martingms/dmpro2012ytelse/README.md

dmpro2012ytelse
===============

Mailingliste: [dmpro2012ytelse@list.stud.ntnu.no](mailto:dmpro2012ytelse@list.stud.ntnu.no)  
IRC: [#dmpro @ IRCnet](irc://irc.ifi.uio.no/dmpro)
