martingms/dmpro2012ytelse/report/acronyms.tex

\chapter*{Abbreviations}
\acrodef{ALU}{Arithmetic Logic Unit}
\acrodef{API}{Application Programming Interface}
\acrodef{BMP}{Bitmap}
\acrodef{CPU}{Central Processing Unit}
\acrodef{DAC}{Digital-to-Analog Converter}
\acrodef{DMA}{Direct Memory Access}
\acrodef{DRAM}{Dynamic RAM}
\acrodef{FAT}{File Allocation Table}
\acrodef{I/O}{Input/Output}
\acrodef{LED}{Light-Emitting Diode}
\acrodef{MB}{Megabyte}
\acrodef{RAM}{Random Access Memory}
\acrodef{RISC}{Reduced Instruction Set Computer}
\acrodef{SRAM}{Static RAM}
\acrodef{UI}{User Interface}
\acrodef{USB}{Universal Serial Bus}
\begin{acronym}
  \acro{ASF}{Atmel Software Foundation}
  \acro{EBI}{External Bus Interface}
  \acro{FPGA}{Field-Programmable Gate Array}
  \acro{GPIO}{General Purpose Input/Output}
  \acro{JTAG}{Joint Test Action Group}
  \acro{LENA}{Lightweight, Efficient Node Array}
  \acro{MIMD}{Multiple Instruction, Multiple Data}
  \acro{PCB}{Printed Circuit Board}
  \acro{PDCA}{Peripheral DMA Controller}
  \acro{SCU}{System Control Unit}
  \acro{SDHC}{Secure Digital High-Capacity}
  \acro{SDRAM}{Synchronous Dynamic RAM}
  \acro{SD}{Secure Digital}
  \acro{SIMD}{Single Instruction, Multiple Data}
  \acro{SMC}{Static Memory Controller}
  \acro{SPI}{Serial Peripheral Interface Bus}
  \acro{USART}{Universal Synchronous/Asynchronous Receiver Transmitter}
  \acro{VGA}{Video Graphics Array}
  \acro{VHDL}{VHSIC Hardware Description Language}
  \acro{VHSIC}{Very-High-Speed Integrated Circuits}
\end{acronym}
