martingms/dmpro2012ytelse/report/fb/front.tex

\begin{titlepage}
%  \begin{addmargin}[-1cm]{-3cm}
    \begin{center}
      \large  
      
      \hfill
      
      \vfill
      
      \begingroup
      \color{Maroon}\spacedallcaps{\ourTitle} \\ 
      \endgroup
      \begingroup
%      \small \spacedlowsmallcaps{computers have never been sexier}
      \bigskip
      \endgroup
      
      {\sc \ourNames}
      
      \vfill
      
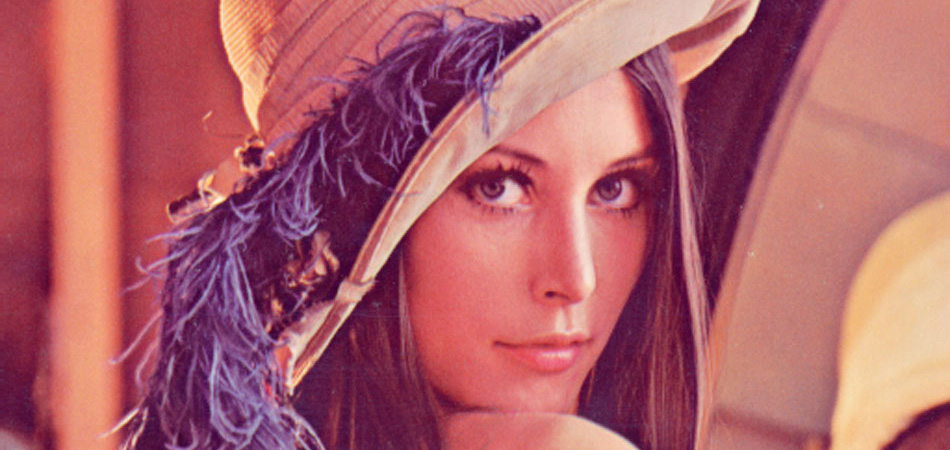
[picture p1: report/gfx/killinglena.jpg]
       \\
      
      \vfill
      
      \ourProject \\
      \ourDept \\                            
      \ourFaculty \\
      \ourUni \\ \bigskip
      
      \vfill                      
      
    \end{center}  
% \end{addmargin}
\end{titlepage}
