martingms/dmpro2012ytelse/report/apx/pcb.tex

\chapter{PCB}

\input{apx/pcb/pin-use}
\input{apx/pcb/ordered-parts}
\input{apx/pcb/macaos} 
\clearpage
\input{apx/pcb/schematics}
