martingms/dmpro2012ytelse/report/ch/pcb.tex

\chapter{PCB}\label{ch:pcb}

\begin{flushright}{\slshape
    Electricity is really just organized lightning.\\ \medskip
    --- George Carlin}
\end{flushright}

\input{fig/pcb/pcbwithcomp}
The entire system is connected together on the PCB. Designing and soldering
a correct and working PCB is thus important to be able to construct the system
as a whole.

This chapter will start by explaining how some of our overall design choices
affected the PCB design. We elaborate our power layout before giving an
overview of where we got our footprints from. Finally, we explain the process 
of making the PCB, as well as some of the issues and solutions we met during 
the process.

\input{ch/pcb/introduction.tex}
%Flytta til process
%\input{ch/pcb/schematics.tex}
\input{ch/pcb/power_supply.tex}
\input{ch/pcb/power_plane.tex}
\input{ch/pcb/footprints.tex}
%Flytta til process
%\input{ch/pcb/routing.tex}
\input{ch/pcb/thepcb.tex}
\input{ch/pcb/process.tex}
\input{ch/pcb/workarounds.tex}
