martingms/dmpro2012ytelse/report/presentation/presentation.tex

\documentclass{beamer}
\usepackage[utf8x]{inputenc}

\usepackage{beamerthementnuenglish}

\title[Datamaskinprosjekt 2012 med fokus på ytelse: 256 Shades of Grey]{256
  Shades of Grey}
\institute[NTNU]{Department of Computer and Information Science}
\author{V. Mange}
\date{21. november, 2012}

\begin{document}

\ntnutitlepage

\begin{frame}
  Eksempel på frame
\end{frame}

\end{document}
