martingms/dmpro2012ytelse/report/ch/res/sdcard.tex

\section{SD Card Performance}
\label{sec:performance-sd-card}

As mentioned in Section \ref{sec:avr-spi-issues}, reading data from an
SD card over SPI turned out to be the biggest bottleneck for throughput
in our system. In this section, we will document the optimizations we
made to improve the SD card's read performance.

Table \ref{tab:spi-optimizations-table} shows the gradually improving
performance as we optimized the code. This is also shown in Figure
\ref{fig:spi-optimizations-plot}. Each of the optimizations are
explained in greater detail below.

\begin{description}
	\item[Removed status checking + function inlining] \hfill \\
		The spi\_send function busy-waited on the TXEMPTY flag for each
		byte it transmitted. In our case of alternating sends and reads,
		we do not have to check whether the SPI send register is empty
		every time. Inlining spi\_read and spi\_write also helped,
		although -O1, -O2 or -O3 would have done this for us.
	\item[Less SPI status register polling] \hfill \\
		In spi\_read, two conditions are busy-waited on before
		returning: whether the send register is empty, and whether the
		receive buffer is full yet. We only have to check the latter of
		these conditions.
	\item[Increased clock rate] \hfill \\
		Our CPU and main bus is driven by an external 12MHz crystal
		oscillator and the SPI clock frequency is calculated by dividing
		this by an integer number. We kept this divisor to be either 1
		or 2 (so SPI ran at either the same or half the speed of the
		CPU). Increasing to clock rate from 12MHz to 78 MHz boosted the
		speed from 157kB/s to 456 kB/s.
	\item[Compiler optimizations] \hfill \\
		Turning on compiler optimizations improved performance
		by another 14\%. There was no noticeable difference in
		performance between -O1, -O2 or -O3. However, compiler
		optimizations had a more profound effect on the overall system
		performance. We did not benchmark this extensively, but it was
		probably caused by optimizations the compiler made to the \ac{LENA}
		communication code.
	\item[Bypass FAT and use multiple block reads] \hfill \\
		We patched the framework code to support multiple block reads.
		Apparently, this was not something the FAT driver was able to
		take full advantage of out of the box. It was easier to simply
		bypass the file system than to try to fix it, so that is what we
		did.
		
		By reading the blocks directly from the SD card, we could read
		all 150 blocks of a picture in one function call. Limiting the
		file system to the first half of the SD card and adding metadata
		files containing the block offsets into the second half of the
		card was easy. This more than doubled our performance, from 515
		kB/s to 1172 kB/s.
\end{description}

\TODO{This must be rewritten}
After implementing these optimizations, the \ac{SCU} was capable of pushing out around
12 FPS to the \ac{LENA}, around 920 kB/s. As we managed to reach our goal of 10
FPS, we did not optimize it any further. However, using the \ac{PDCA}, we could
have effectively eliminated the 25\% time spent sending to the \ac{LENA} while
the \ac{SD} card waited. Thus, giving as a frame rate of around 16
FPS. 
\input{fig/avr/spi-optimizations-table.tex}
\input{fig/avr/spi-optimizations-plot.tex}
