martingms/dmpro2012ytelse/report/ch/pcb/footprints.tex

\section {Footprints}
Some of the components we chose did not have footprints readily available, which
meant we either had to look for them on the internet, or create them.

This meant either staring at datasheets and carefully placing pins
relative to each other, or running the IPC wizard.

\subsection{We made the following footprints}
\input{fig/pcb/footprintswemade}
\begin{description}
\item[SD card] \hfill
\\
  With the pin designations selected by googling the pinouts for
  \ac{SD} cards in general, and comparing a few of those hits to make sure that
  the results agreed with each other. Finally we selected a single hit\footnote{\url{http://pinouts.ru/Memory/sdcard_pinout.shtml}}
  to base the pinout on. The
  schematic\footnote{\url{http://katalog.we-online.de/em/datasheet/693063010911.pdf}}
  for the reader itself was particularly hard to read, to the point that we had to ask Tufte
  for help to understand it. Even after that, there was no way to be sure
  precisely where the grounding pads were relative to the rest of the \ac{SD}
  card reader. Thus we did some guesswork, and added a decent amount
  of slack to the ground pads by adding extra tin to these pads.
\item[Memory (TSOP54/TSOP44)] \hfill
\\
  The TSOP54/TSOP44 footprints were created using
  the IPC Footprint Wizard, as their datasheets fitted nicely with the Small
  Outline Package setting in that Wizard.
\end{description}

\subsection{Footprints from other sources:}
As Festina Lente used some components that we also ended up using, we decided,
after talking to Tufte, to use their Footprints\footnote{\url{http://org.ntnu.no/datamaskinerprosjekt2011/altium_libraries/dmprolibrary/}}
(as they were known to work) for these components:

\input{fig/pcb/footprintsources}
The oscillator had one issue last year, the footprint for it was mirrored
, noting this from Festina Lente's report, we read
through the datasheet, and remapped the pin-numbering (taking care to understand
why it was mirrored last year) on the footprint 
before using this footprint.

After reading the Festina Lente report\cite{berg2011festinalente}, we decided to
follow their choice of footprint for capacitors and resistors: 1206 SMT. As
those were physically bigger than the 0804 SMTs they mentioned as an
alternative, they would be easier to solder by hand.
