martingms/dmpro2012ytelse/report/fig/pcb/footprintswemade.tex

\begin{table}[h]
  \centering
  \begin{tabular}{l l}\toprule
    \thx{Component} & \thx{Purpose} \\ \midrule
    \ac{SD} card reader & For fast data access \\
    \ac{VGA} plug & For our own VGA implementation \\
    CY7C1069DV33 54TSOP & Data-memory (2M $\times$ 8bit) \\
    CY7C1021DV33 44TSOP & Program-memory (64k $\times$ 16bit) \\
    CY7C1049DV33 44TSOP &  VGA memory (512 $\times$ 8bit) \\
    \bottomrule
  \end{tabular}
  \caption{The Customized Footprints}
  \label{fig:footprints-we-made}
\end{table}
