martingms/dmpro2012ytelse/report/fig/fpga/fpga-simd-s-reg.tex

\begin{figure}[h]
  \centering
  \includegraphics[width=\linewidth,clip,trim=0 0 0 0]
                  {fig/fpga/fpga-simd-s-reg.pdf}
  \caption[Source Data Flow.]{Source data flow through the \ac{LENA} \ac{SIMD} array.}
  \label{fig:fpga-simd-s-reg}
\end{figure}
