martingms/dmpro2012ytelse/report/apx/pcb/pin-use.tex

\section{Overview of Pin Use}\label{app:pin-use}

\subsection{FPGA}\label{app:pin-use-fpga}
\input{fig/parts/pcb-pin-use-fpga.tex}
\subsection{AVR}\label{app:pin-use-avr}
\input{fig/parts/pcb-pin-use-avr.tex}
