martingms/dmpro2012ytelse/report/ch/pcb/process.tex

\section {Process}
This section describes the work and design challenges faced related to the PCB.

\input{ch/pcb/schematics}
\input{ch/pcb/routing}
\input{ch/pcb/soldering}
