martingms/dmpro2012ytelse/report/fig/avr/modules.tex

\begin{figure}[H]
  \centering
  
  \caption[SCU Modules]{The different modules of the SCU}
  \label{fig:avr-modules}
\end{figure}
