martingms/dmpro2012ytelse/report/fig/avr/spi-optimizations-plot.tex

\begin{figure}[H]
  \centering
  
  \caption[SPI Optimizations Plot]{The results from Table
    \ref{tab:spi-optimizations-table} plotted. Milestones are along the
    $x$-axis and read performance along the $y$-axis.}
  \label{fig:spi-optimizations-plot}
\end{figure}
