martingms/dmpro2012ytelse/report/fig/avr/spi-optimizations-table.tex

\begin{table}[H]
  \centering
  \begin{tabularx}{\textwidth}{c X r} \toprule
    \thx{Milestone} & \thx{Description} & \thx{Performance} \\
    \midrule
    1 & Baseline before optimization & 74.87 kB/s \\
    2 & Less status checking in {\tt spi\_send} plus inlining & 137.00 kB/s \\
    3 & Less \ac{SPI} status register polling & 156.59 kB/s \\
    4 & Clock rate of 20MHz, 10MHz \ac{SPI} & 214.40 kB/s \\
    5 & Clock rate of 20MHz, 20MHz \ac{SPI} & 243.00 kB/s \\
    6 & Clock rate of 40MHz, 20MHz \ac{SPI} & 327.80 kB/s \\
    7 & Clock rate of 48MHz, 24MHz \ac{SPI} & 369.50 kB/s \\
    8 & Clock rate of 60MHz, 30MHz \ac{SPI} & 423.40 kB/s \\
    9 & Clock rate of 72MHz, 36MHz \ac{SPI} & 432.70 kB/s \\
    10 & Clock rate of 78MHz, 39MHz \ac{SPI} & 455.80 kB/s \\
    11 & Turn on {\tt -O1} & 521.70 kB/s \\
    12 & Turn on {\tt -O2} & 523.40 kB/s \\
    13 & Turn on {\tt -O3} & 515.30 kB/s \\
    14 & Bypass \ac{FAT} and use multiple block reads & 1171.90 kB/s \\ 
    \bottomrule
  \end{tabularx}
  \caption[SPI Read Performance]{The read performance over \ac{SPI} at various
    milestones.}
  \label{tab:spi-optimizations-table}
\end{table}
