martingms/dmpro2012ytelse/report/fig/disc/memarch.tex

\begin{figure}[h]
  \centering
  \includegraphics[width=\textwidth,clip,trim=0 17cm 0 0]
                  {fig/disc/memarch.pdf}
  \caption[Data Memory Architecturres]{Considered data memory architectures}
  \label{fig:disc-memarch}
\end{figure}
