martingms/dmpro2012ytelse/report/fig/fpga/fpga_ctrl_core.tex

\begin{figure}[h]
  \begin{addmargin}{-2cm}
    \centering
    \includegraphics[width=\linewidth,clip,trim=0 18cm 0 0]
                    {fig/fpga/fpga_ctrl_core.pdf}
    \caption{Image processor control core.}
    \label{fig:fpga-ctrl-core}
  \end{addmargin}
\end{figure}
