martingms/dmpro2012ytelse/report/fig/pcb/footprintsources.tex

\begin{table}[h]
  \centering
  \begin{tabular}{l l}\toprule
    \thx{Component} & \thx{Source} \\ \midrule 
    Button (FSM2JSMA) & Festina Lente \\
    Crystal & Festina Lente \\
    LUMBERG - 2486 01 - MINI \ac{USB} TYPE B & Festina Lente \\
    Oscillator (CSX750FJC50.000M-UT) & Festina Lente \\
    Power Connector & Festina Lente \\
    External \ac{VGA} module & Festina Lente \\
    AVR & AVR-freaks \\
    \ac{FPGA} & Altium Design Library \\ \bottomrule
  \end{tabular}
  \caption{Footprints and sources}
  \label{fig:footprints-and-sources}
\end{table}
