martingms/dmpro2012ytelse/report/fig/pcb/pcbwithcomp.tex

\begin{figure}[h]
  \centering
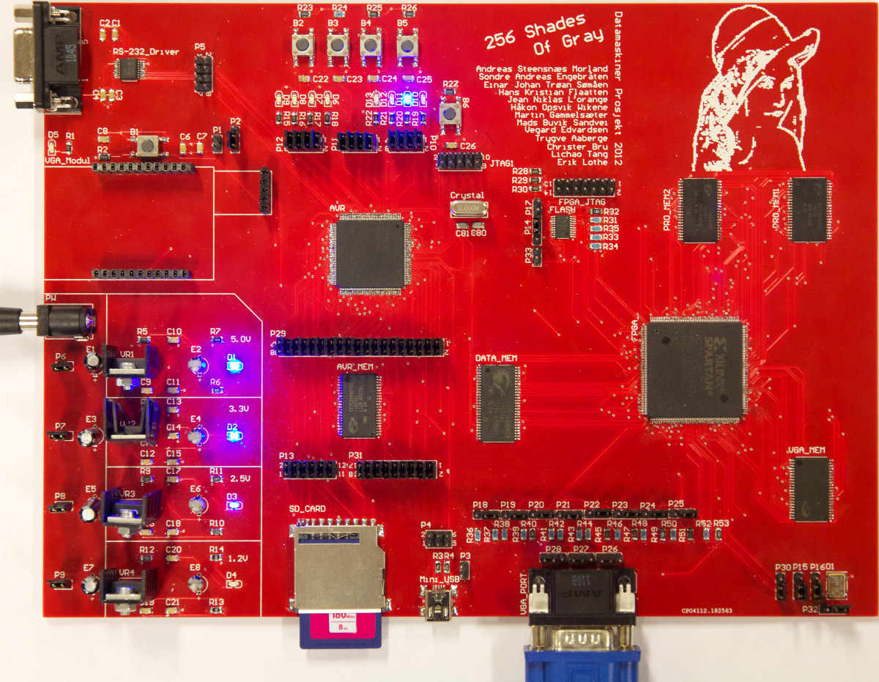
[picture p2: report/fig/pcb/pcbwithcomp.jpg]
  
  \caption[The PCB]{The PCB With All The Components.}
  \label{fig:pcb-with-components}
\end{figure}
