martingms/dmpro2012ytelse/report/apx/pcb/schematics.tex

\section{Schematics}\label{app:schematics}
The following figures will show schematics of our PCB.
\input{fig/pcb/schematics/pcbschematic}
\input{fig/pcb/schematics/pcbschematic_avr}
\input{fig/pcb/schematics/pcbschematic_avrmem}
\input{fig/pcb/schematics/pcbschematic_vgamodule}
\input{fig/pcb/schematics/pcbschematic_vgamem}
\input{fig/pcb/schematics/pcbschematic_vgacontroller}
\input{fig/pcb/schematics/pcbschematic_serial}
\input{fig/pcb/schematics/pcbschematic_sdcard}
\input{fig/pcb/schematics/pcbschematic_powersupply}
\input{fig/pcb/schematics/pcbschematic_ledbtn}
\input{fig/pcb/schematics/pcbschematic_jtagflash}
\input{fig/pcb/schematics/pcbschematic_fpgapower}
\input{fig/pcb/schematics/pcbschematic_fpgab01}
\input{fig/pcb/schematics/pcbschematic_fpgab3}
