martingms/dmpro2012ytelse/report/fig/pcb/pcb_removing_vias.tex

\begin{figure}[h]
  \centering
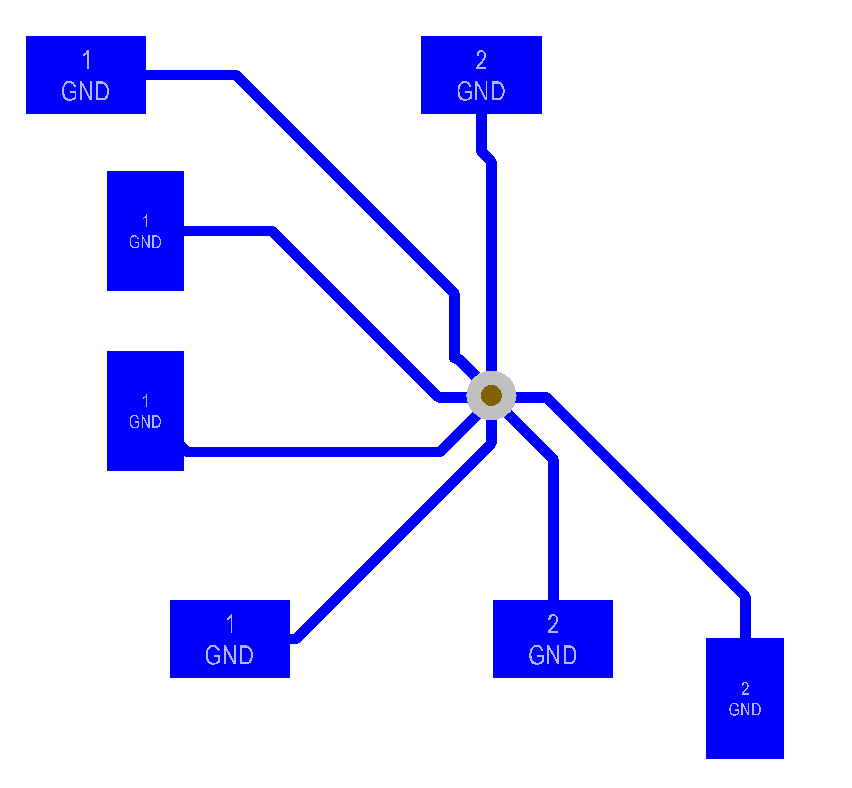
[picture p3: report/fig/pcb/pcb_removing_vias.png]
  
  \caption{Removing vias}
  \label{fig:removingvias-pcb}
\end{figure}
