martingms/dmpro2012ytelse/report/fig/pcb/voltageresult.tex

\begin{table}[h]
  \centering
  \begin{tabularx}{\textwidth}{l l l l}\toprule
    \thx{Test} & \thx{Result} & \thx{Passed} 
    \\ 
	 \midrule
    Power supply 12.0V               &Measured 12.045  & OK  \\	
    Power supply 5.0V               &Measured 4.995  & OK  \\
    Power supply 3.3V                   & Measured 3.286 & OK  \\
    Power supply 2.5V                 & Measured 2.510 & OK \\
    Power supply 1.2V            & Measured 1.240 & OK  \\
    
    \bottomrule
  \end{tabularx}
  \caption{Results of power supply}
  \label{fig:pcb}
\end{table}
