martingms/dmpro2012ytelse/report/fig/sys-over/journey.tex

\begin{figure}[h]
  \centering
  \includegraphics[width=\linewidth,clip,trim=0 20.5cm 0 0]
                  {fig/sys-over/journey.pdf}
  \caption{The Journey of an Image}
  \label{fig:image-journey}
\end{figure}
