martingms/dmpro2012ytelse/report/fig/fpga/fpga-simd-datacom.tex

\begin{figure}[h]
  \centering
  \includegraphics[width=\linewidth,clip,trim=0 18cm 0 0]
                  {fig/fpga/fpga-simd-datacom.pdf}
  \caption[Communication in SIMD array.]{Four-way communication in the \ac{LENA}
    \ac{SIMD} array.}
  \label{fig:fpga-simd-datacom}
\end{figure}
