martingms/dmpro2012ytelse/report/fig/fpga/vga-circuit.tex

\begin{figure}[h!]
\centering
\includegraphics[width=\linewidth,clip,trim=0 11cm 0 0]
                {fig/fpga/vga-circuit.pdf}
\caption[VGA controller]
        {The resistor network of the DAC.}
\label{fig:vga-circuit}
\end{figure}
