martingms/dmpro2012ytelse/report/fig/pcb/routing.tex

\begin{figure}[h]
  \centering
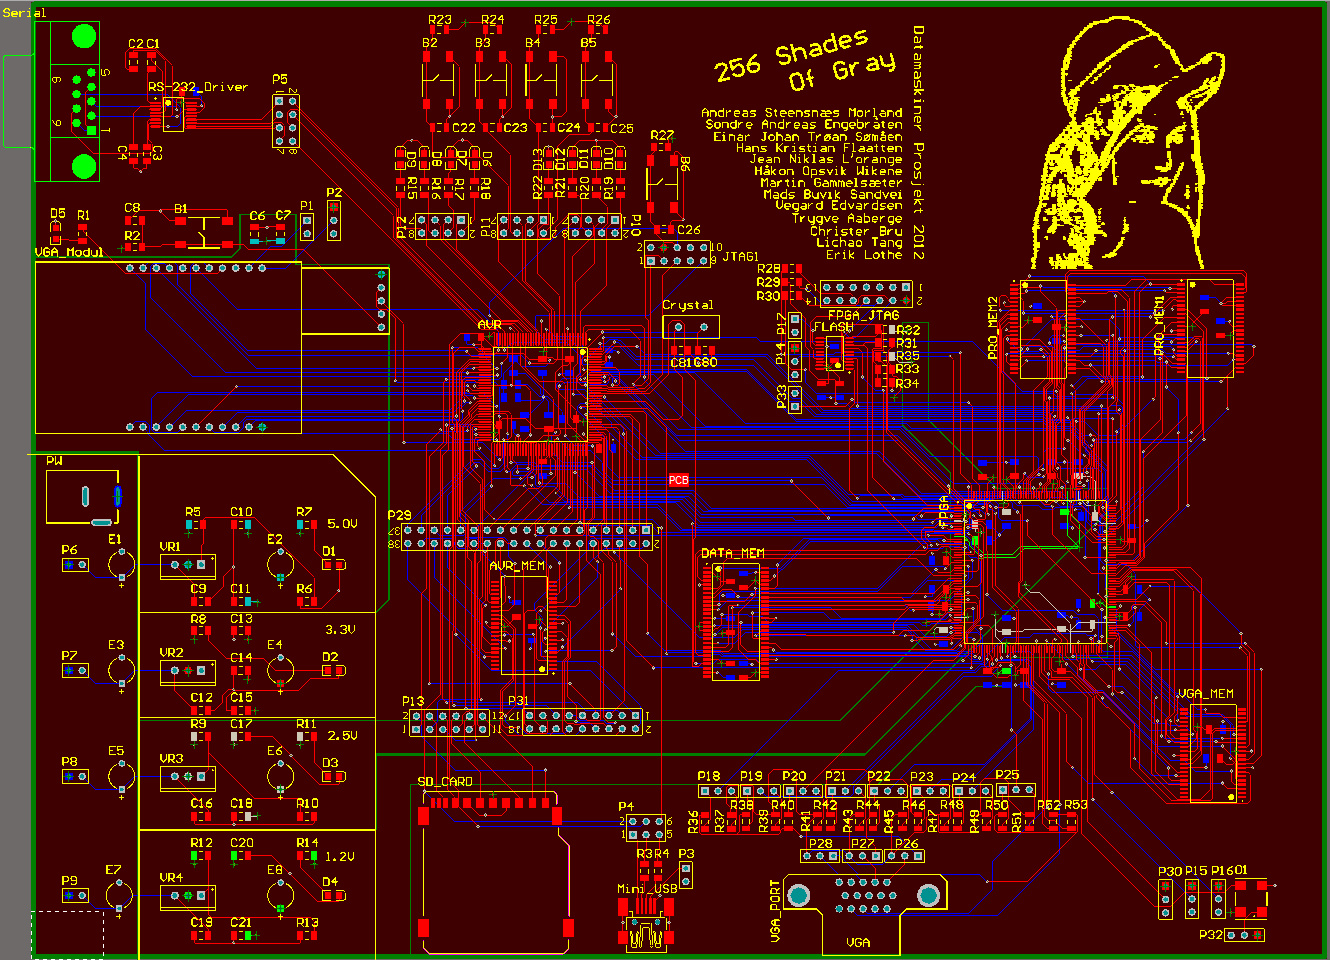
[picture p4: report/fig/pcb/routing.PNG]
  
  \caption{Routed PCB}
  \label{fig:routed-pcb}
\end{figure}
