martingms/dmpro2012ytelse/report/fig/pcb/power_planes.tex

\begin{figure}[h]
  \centering
  
  \caption{The Power Planes}
  \label{fig:power_planes}
\end{figure}
