martingms/dmpro2012ytelse/report/fig/fpga/vga.tex

\begin{figure}[h!]
\centering
\includegraphics[width=\linewidth,clip,trim=0 18cm 0 0]
                {fig/fpga/vga.pdf}
\caption[VGA controller]
        {The parts of the VGA controller.}
\label{fig:vga}
\end{figure}
