martingms/dmpro2012ytelse/report/fig/fpga/control_module.tex

\begin{figure}[h!]
\centering
\includegraphics[width=\linewidth,clip,trim=0 10cm 0 0]
                {fig/fpga/control_module.pdf}
\caption[Control module]
        {An overview of the control module of the image processor.}
\label{fig:control-module}
\end{figure}
