martingms/dmpro2012ytelse/report/fig/fpga/architecture.tex

\begin{figure}[h!]
\centering
\includegraphics[width=\linewidth,clip,trim=0 7.6cm 0 0]
                {fig/fpga/architecture.pdf}
\caption[LENA architecture]
        {An overview of the LENA image processor architecture.}
\label{fig:fpga-architecture}
\end{figure}
