martingms/dmpro2012ytelse/report/fig/pcb/pcbwithoutcomp.tex

\begin{figure}[h]
  \centering
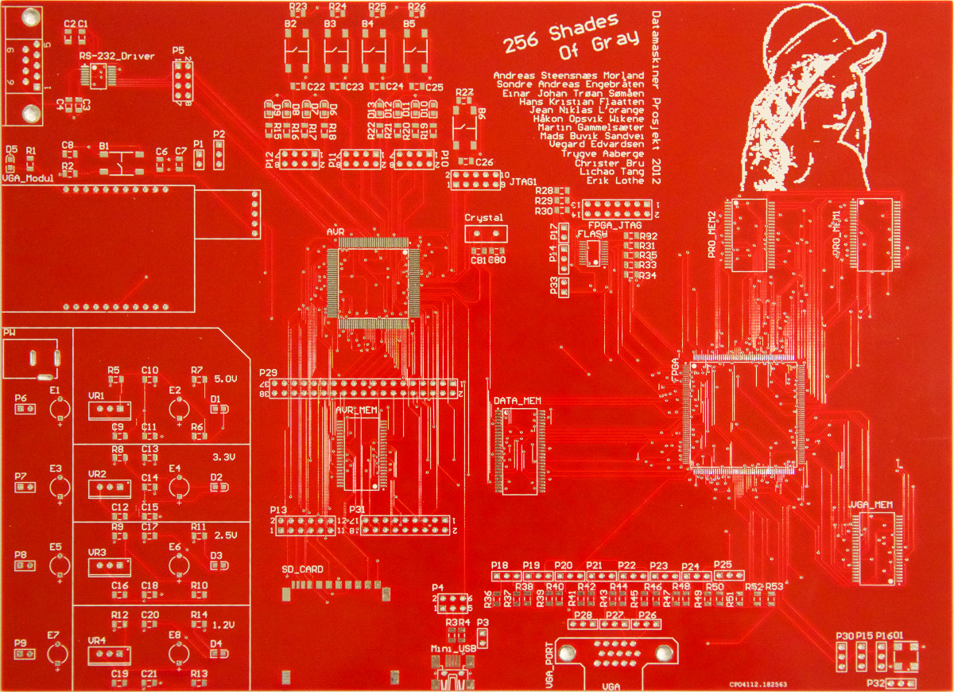
[picture p5: report/fig/pcb/pcbwithoutcomp.jpg]
  
  \caption{The PCB Without Components}
  \label{fig:pcb-without-components}
\end{figure}
