martingms/dmpro2012ytelse/report/fig/sys-over/arch-fig.tex

\begin{figure}[h]
  \centering
  \includegraphics[width=\linewidth,clip,trim=0 18cm 0 0]
                  {fig/sys-over/arch-fig.pdf}
  \caption{System Architecture}
  \label{fig:sys-over-arch-fig}
\end{figure}
