martingms/dmpro2012ytelse/report/ch/intro/terms.tex

\section{Terminology, Names and Conventions}

We will use the following names and non-standard terms in the report:

\begin{description}
\item[AVR] A microprocessor architecture
\item[LENA Architecture] Lightweight, Efficient, Node Array Architecture
\end{description}

The following acronyms are used consistently throughout the report, to ease
reading.

\begin{description}
\item[PCB] Printed Circuit Board
\item[FPGA] Field-Programmable Gate Array
\item[SIMD] Single Instruction, Multiple Data
\item[RISC] Reduced Instruction Set Computer
\item[VGA] Video Graphics Array
\item[ALU] Arithmetic Logic Unit
\item[USB] Universal Serial Bus
\item[I/O] Input/Output
\item[JTAG] Joint Test Action Group
\item[API] Application Programming Interface
\item[RAM] Random Access Memory
\item[SRAM] Static Random Access Memory
\item[DRAM] Dynamic Random Access Memory
\item[SD] Secure Digital
\end{description}
