martingms/dmpro2012ytelse/report/lst/apx/lena/simd_embossing.tex

\begin{code}
  \usemintedstyle{soderberg}
  \inputminted[frame=single,linenos,%firstline=50,firstnumber=50,%lastline=92,
    fontsize=\small]{lena}{../tools/fpga_programs/simd_edge_detection.lena}
  \caption{Edge detection code in LENA assembly.}
  \label{lst:edgedetect}
\end{code}
