martingms/dmpro2012ytelse/report/fig/pcb/schematics/pcbschematic_avrmem.tex

\begin{figure}[h]
  \centering
  
  \caption{AVR Memory}
  \label{fig:schematic-pcb-avrmem}
\end{figure}
