martingms/dmpro2012ytelse/report/fig/pcb/schematics/pcbschematic_avr.tex

\begin{figure}[h]
  \centering
  
  \caption{AVR Schematic and FPGA Input}
  \label{fig:schematic-pcb-avr}
\end{figure}
