martingms/dmpro2012ytelse/report/fig/pcb/schematics/pcbschematic.tex

\begin{figure}[h]
  \centering
  
  \caption{PCB Schematic Overview}
  \label{fig:schematic-pcb}
\end{figure}
