martingms/dmpro2012ytelse/report/fig/pcb/schematics/pcbschematic_fpgab01.tex

\begin{figure}[h]
  \centering
  
  \caption{FPGA Bank 0 and Bank 1}
  \label{fig:schematic-pcb-fpgab01}
\end{figure}
