martingms/dmpro2012ytelse/report/fig/pcb/schematics/pcbschematic_fpgab3.tex

\begin{figure}[h]
  \centering
  
  \caption{FPGA Bank 3}
  \label{fig:schematic-pcb-fpgab3}
\end{figure}
