martingms/dmpro2012ytelse/report/fig/pcb/schematics/pcbschematic_fpgapower.tex

\begin{figure}[h]
  \centering
  
  \caption{FPGA Power Supply}
  \label{fig:schematic-pcb-fpgapower}
\end{figure}
