martingms/dmpro2012ytelse/report/fig/pcb/schematics/pcbschematic_jtagflash.tex

\begin{figure}[h]
  \centering
  
  \caption{FPGA JTAG Flash}
  \label{fig:schematic-pcb-jtagflash}
\end{figure}
