martingms/dmpro2012ytelse/report/fig/pcb/schematics/pcbschematic_ledbtn.tex

\begin{figure}[h]
  \centering
  
  \caption{LEDs and Buttons}
  \label{fig:schematic-pcb-ledbtn}
\end{figure}
