martingms/dmpro2012ytelse/report/fig/pcb/schematics/pcbschematic_powersupply.tex

\begin{figure}[h]
  \centering
  
  \caption{Power Supply}
  \label{fig:schematic-pcb-powersupply}
\end{figure}
