martingms/dmpro2012ytelse/report/fig/pcb/schematics/pcbschematic_sdcard.tex

\begin{figure}[h]
  \centering
  
  \caption{SD Card Reader}
  \label{fig:schematic-pcb-sdcard}
\end{figure}
