martingms/dmpro2012ytelse/report/fig/pcb/schematics/pcbschematic_serial.tex

\begin{figure}[h]
  \centering
  
  \caption{Serial}
  \label{fig:schematic-pcb-serial}
\end{figure}
