martingms/dmpro2012ytelse/report/fig/pcb/schematics/pcbschematic_vgacontroller.tex

\begin{figure}[h]
  \centering
  
  \caption{VGA Controller}
  \label{fig:schematic-pcb-vgacontroller}
\end{figure}
