martingms/dmpro2012ytelse/report/fig/pcb/schematics/pcbschematic_vgamem.tex

\begin{figure}[h]
  \centering
  
  \caption{VGA Memory}
  \label{fig:schematic-pcb-vgamem}
\end{figure}
