martingms/dmpro2012ytelse/report/fig/pcb/schematics/pcbschematic_vgamodule.tex

\begin{figure}[h]
  \centering
  
  \caption{VGA Module}
  \label{fig:schematic-pcb-vgamodule}
\end{figure}
