martingms/dmpro2012ytelse/doc/design_spec/architecture.pdf

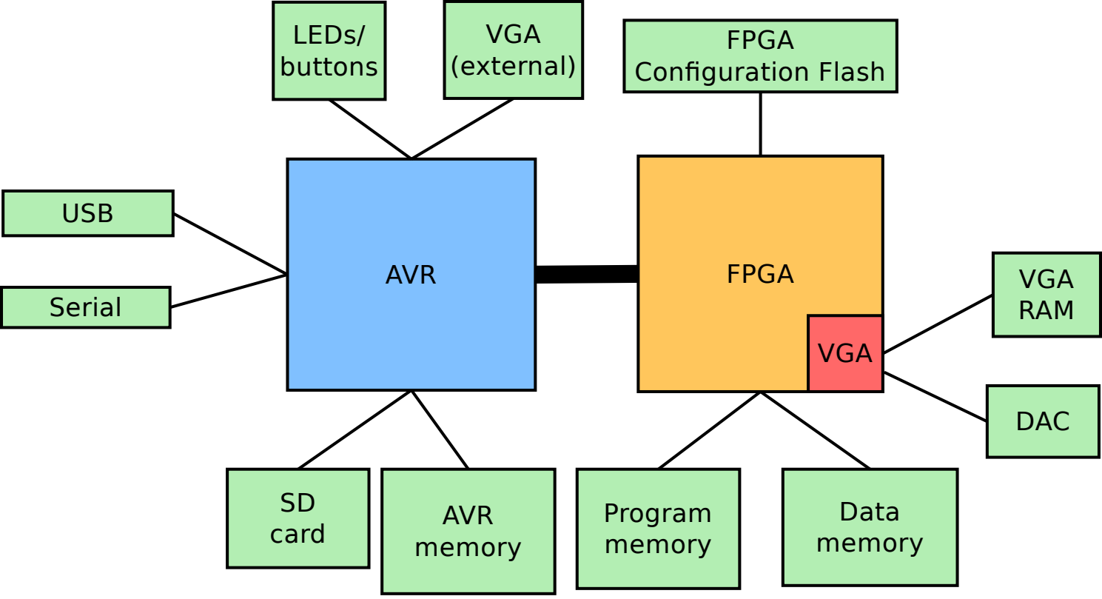
[picture p6: figure]
AVR; FPGA; VGA; VGA (external); LEDs/ buttons; USB; Serial; Data memory; Program memory; DAC; FPGA Configuration Flash; VGA RAM; card; memory
