martingms/dmpro2012ytelse/report/fig/avr/modules.pdf

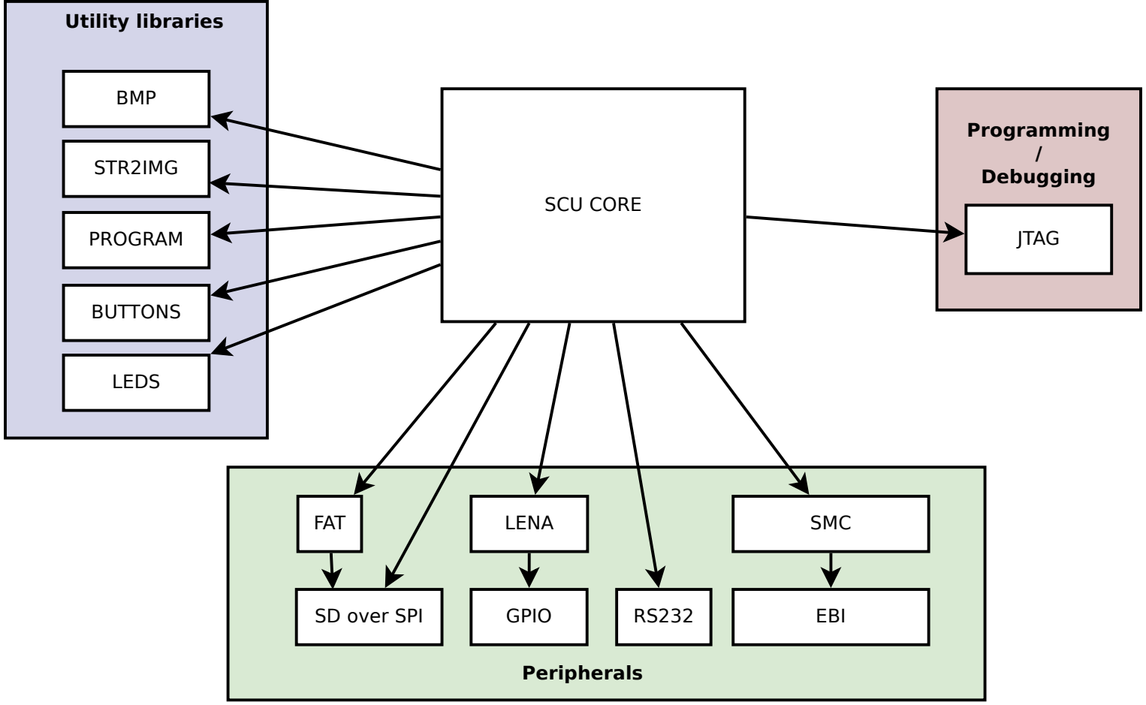
[picture p7: figure]
SCU CORE; STR2IMG; BMP; PROGRAM; Utility libraries; EBI; SMC; LEDS; BUTTONS; SD over SPI; FAT; GPIO; LENA; Peripherals; JTAG; Programming / Debugging
