martingms/dmpro2012ytelse/report/fig/fpga/architecture.pdf

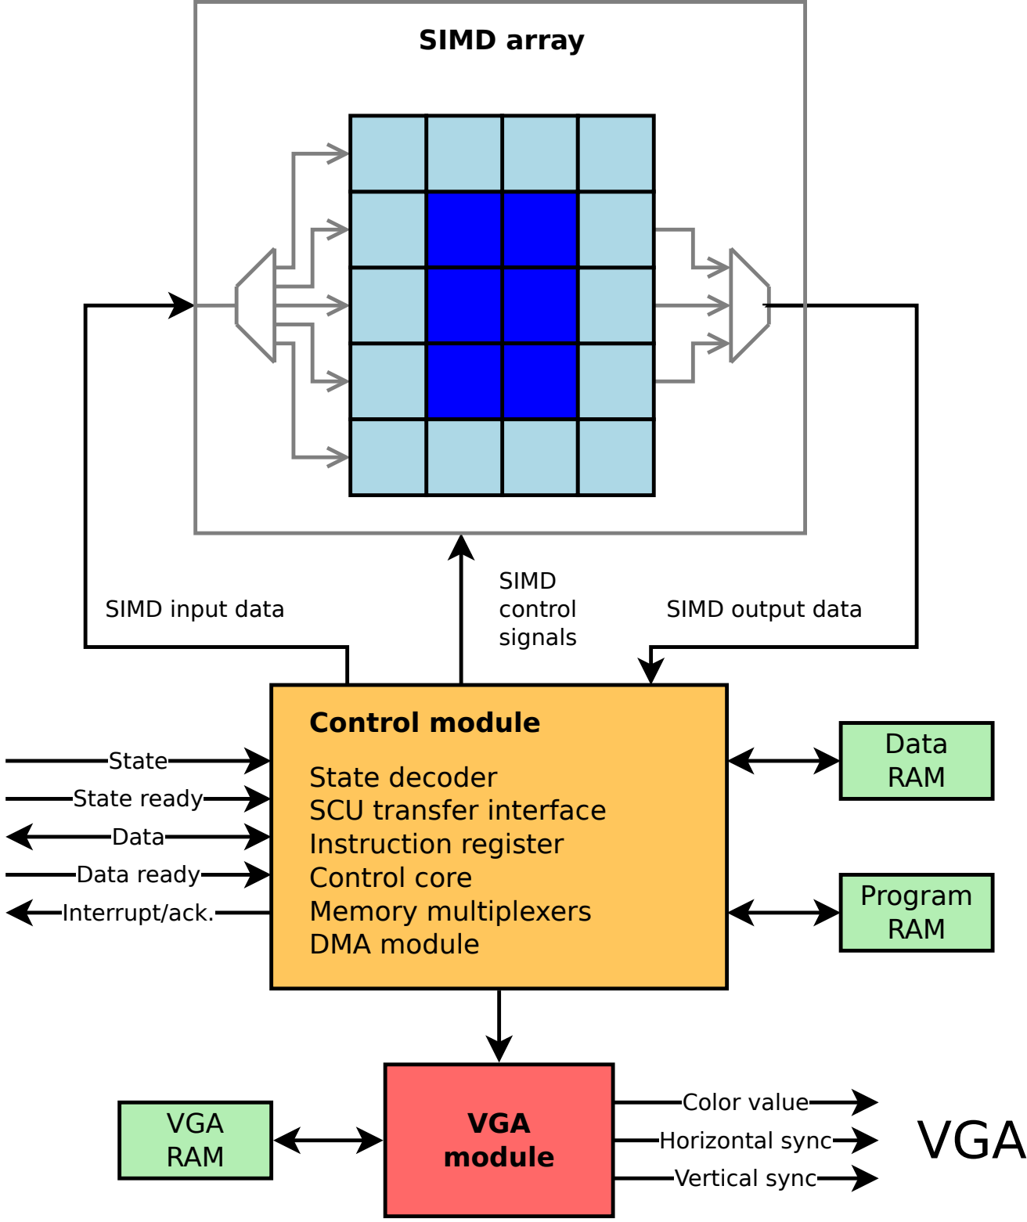
[picture p8: figure]
Program RAM; Data RAM; VGA module; VGA RAM; State ready; State; Data; Interrupt/ack.; Vertical sync; Color value; Data ready; Horizontal sync; State decoder SCU transfer interface Instruction register Control core Memory multiplexers DMA module; Control module; VGA; SIMD array; SIMD control signals; SIMD input data; SIMD output data

# SCU
