martingms/dmpro2012ytelse/report/fig/sys-over/arch-fig.pdf

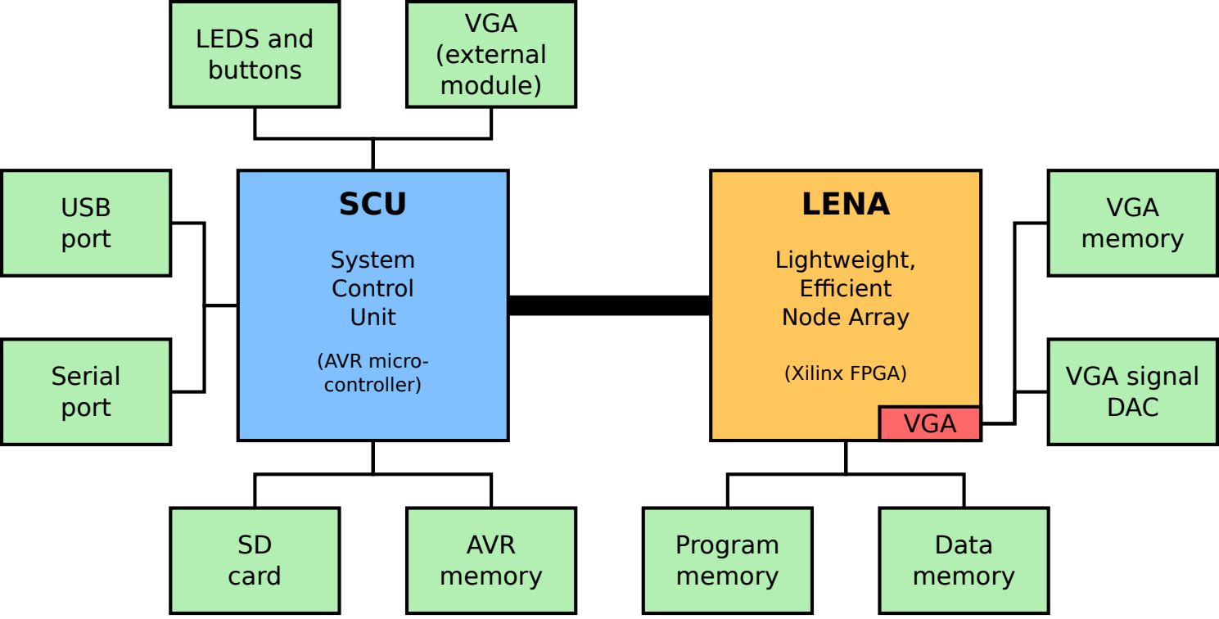
[picture p9: figure]
SCU; LENA; VGA; VGA (external module); LEDS and buttons; (AVR micro-; controller); (Xilinx FPGA); AVR memory; SD card; Serial port; USB port; Data memory; Program memory; VGA signal DAC; VGA memory System; Control Unit; Lightweight, Efficient Node Array
