martingms/dmpro2012ytelse/report/fig/sys-over/journey.pdf

S | S
S | S
S | S

VGA

# LENA

SD | SCU | DMA
MEM | C
