martingms/dmpro2012ytelse/report/fig/fpga/vga.pdf

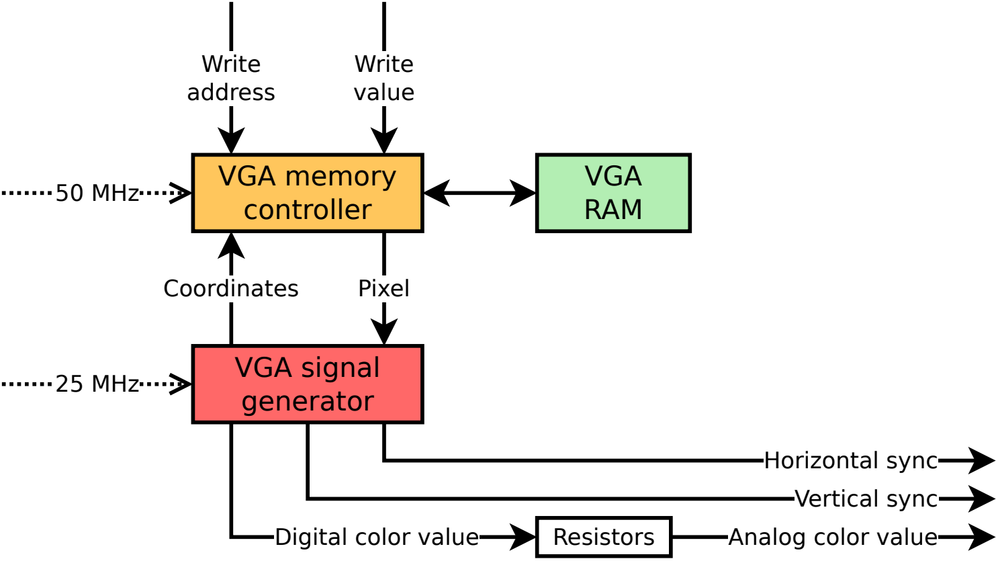
[picture p10: figure]
Horizontal sync; VGA signal generator; VGA RAM; Resistors; Analog color value; Coordinates; Pixel; Write address; Write value; VGA memory controller; 25 MHz; 50 MHz; Vertical sync; Digital color value
