martingms/dmpro2012ytelse/report/fig/fpga/fpga-simd-datacom.pdf

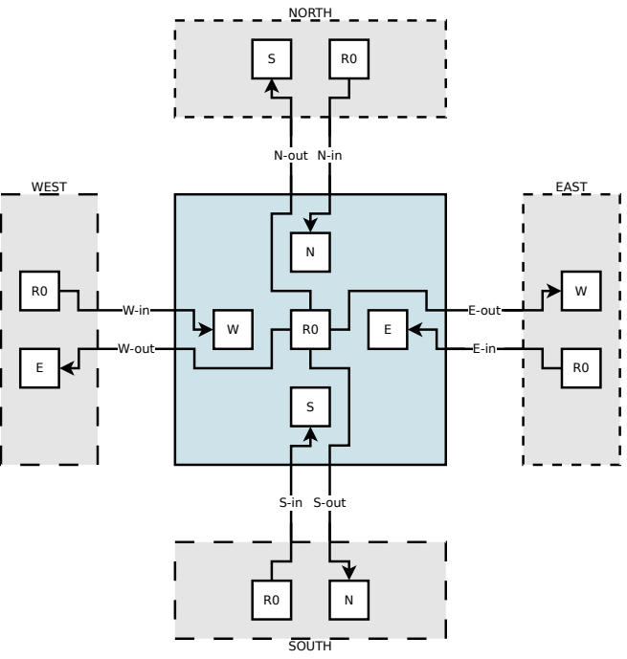
[picture p11: figure]
N-out N-in; S-in S-out; W-out; E-out; WEST; NORTH; EAST; SOUTH
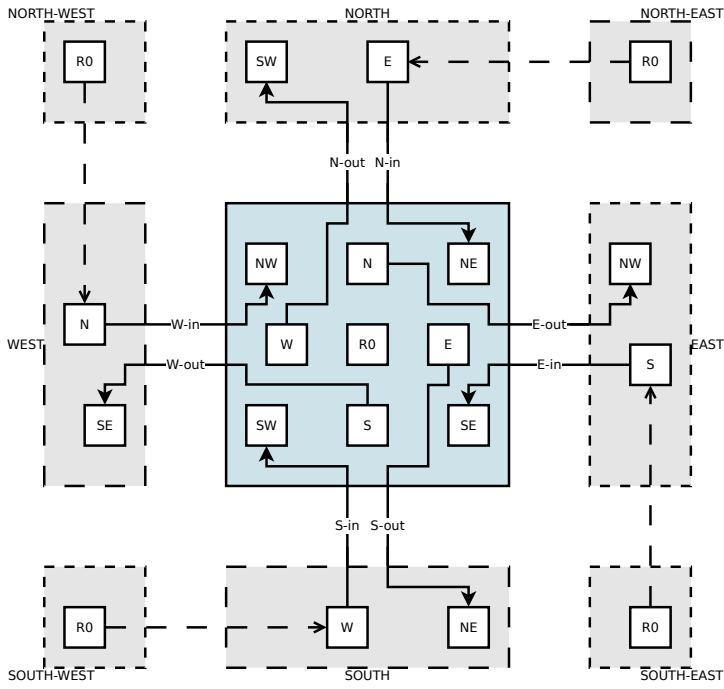
[picture p12: figure]
N-out N-in; S-in S-out; W-out; E-out; WEST; NORTH; EAST; SOUTH; NORTH-EAST; SOUTH-EAST; SOUTH-WEST; NORTH-WEST

DATA FLOW BETWEEN ADJACENT NODES | DATA FLOW BETWEEN NON-ADJACENT NODES
