martingms/dmpro2012ytelse/report/fig/fpga/fpga_ctrl_core.pdf

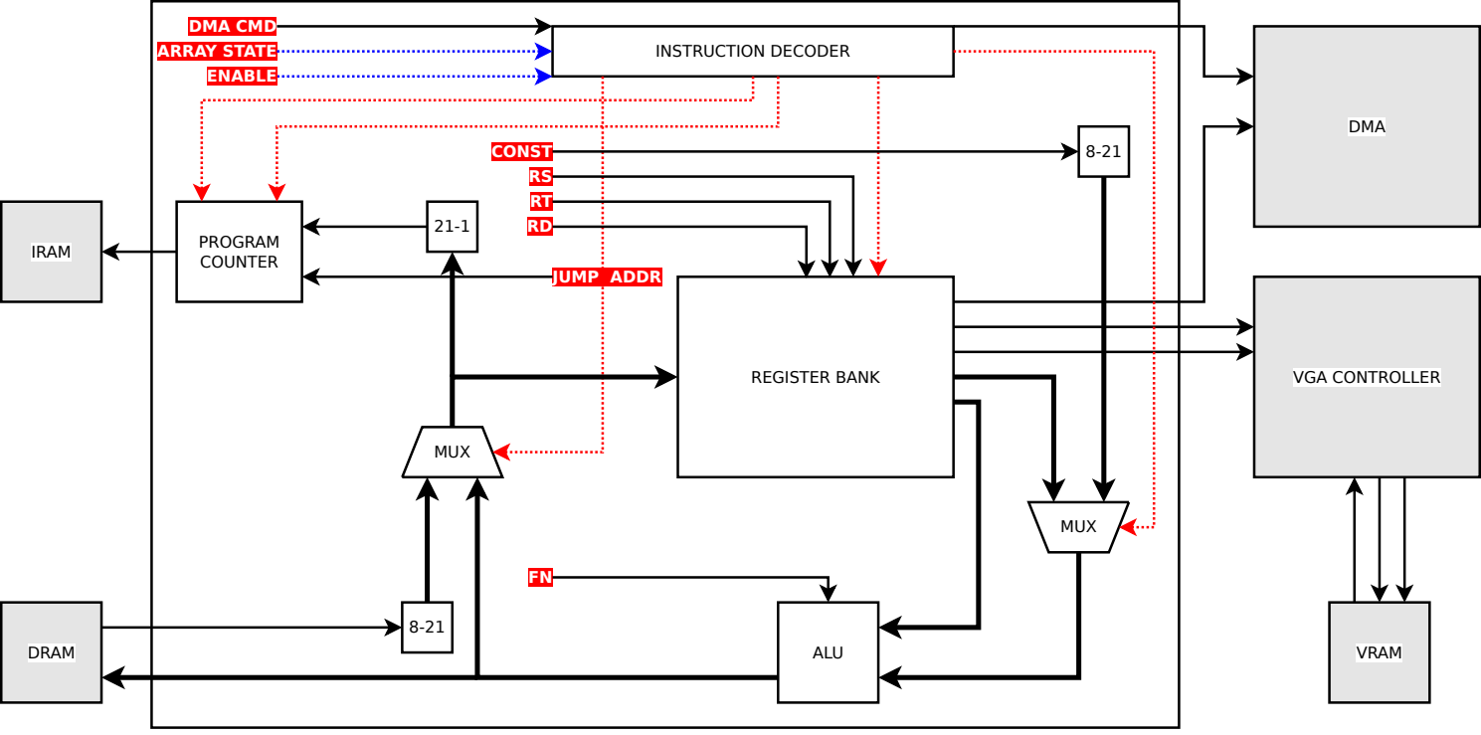
[picture p13: figure]
REGISTER BANK; INSTRUCTION DECODER; MUX; PROGRAM COUNTER; DMA; VGA CONTROLLER; DRAM; ALU; VRAM; CONST; JUMP ADDR; ENABLE; IRAM; ARRAY STATE; DMA CMD
