martingms/dmpro2012ytelse/report/fig/fpga/control_module.pdf

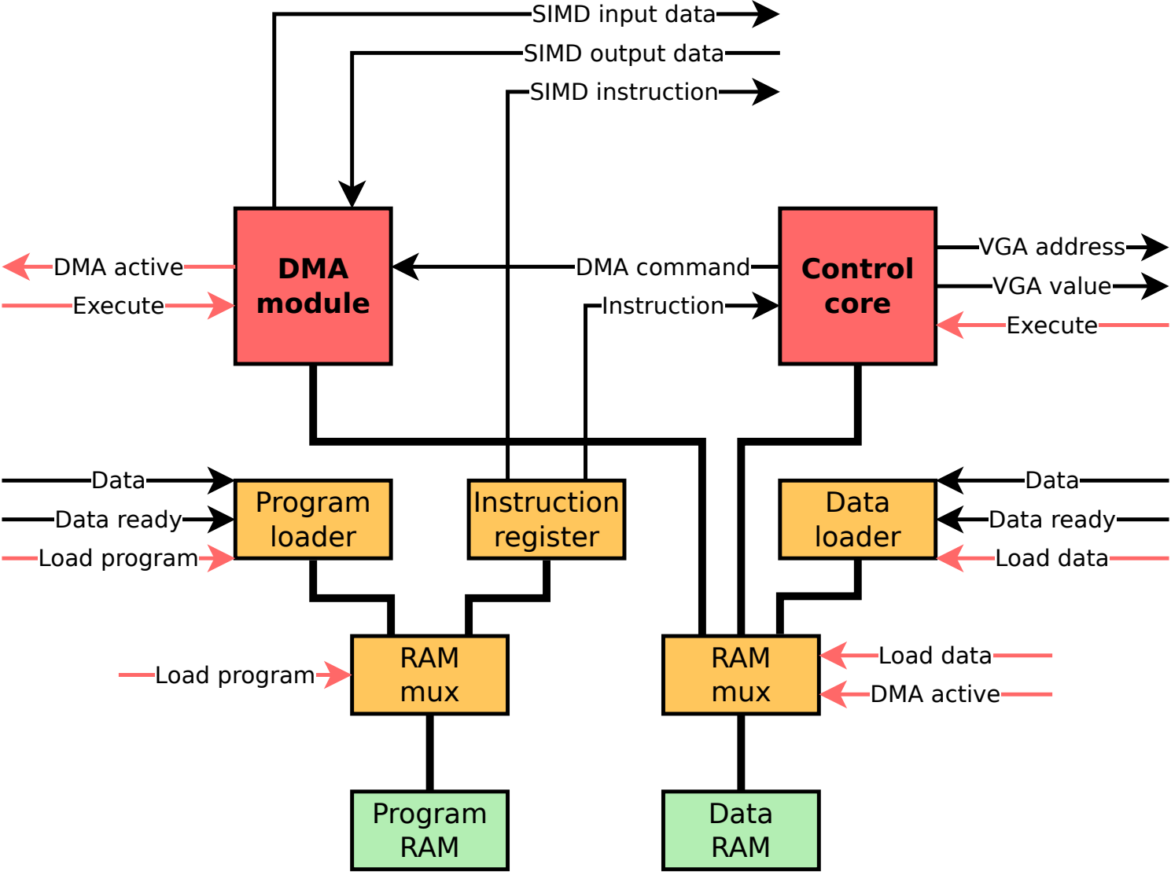
[picture p14: figure]
Program RAM; Data Data ready; Data RAM; RAM mux; Load program; RAM; mux; Load data; DMA module; DMA active; Control core; Program loader; Instruction register Load program; Data Data ready Data loader; VGA address VGA value; DMA command Instruction; Execute; SIMD instruction; SIMD output data; SIMD input data

State

### State decoder

Load program
Load data
Execute
