martingms/dmpro2012ytelse/report/fig/pcb/schematics/pcbschematic_sdcard.pdf

CD - DAT3 | 1
CMD | 2
Vss1 | 3
Vdd | 4
CLK | 5
GND | 6
DAT0 | 7
DAT1 | 8
DAT2 | 9
WP | WP
CD | CD

SD_CARD

SD_CARD

# SD_CARD

3.3V

2 | 1
4 | 3
6 | 5
8 | 7
10 | 9

12 11

P13

Header 6X2

DAT0
DAT1
DAT2

CD - DAT3
CMD
CLK

NC

GND
