martingms/dmpro2012ytelse/doc/fpga/fpga_simd_datacom2.pdf

R0

R-in | R0' | R-in

WEST

NORTH

EAST

SOUTH

R0' | R0'

# SOURCE DATA FLOW

step
