martingms/dmpro2012ytelse/doc/fpga/fpga_simd_datacom_send.pdf

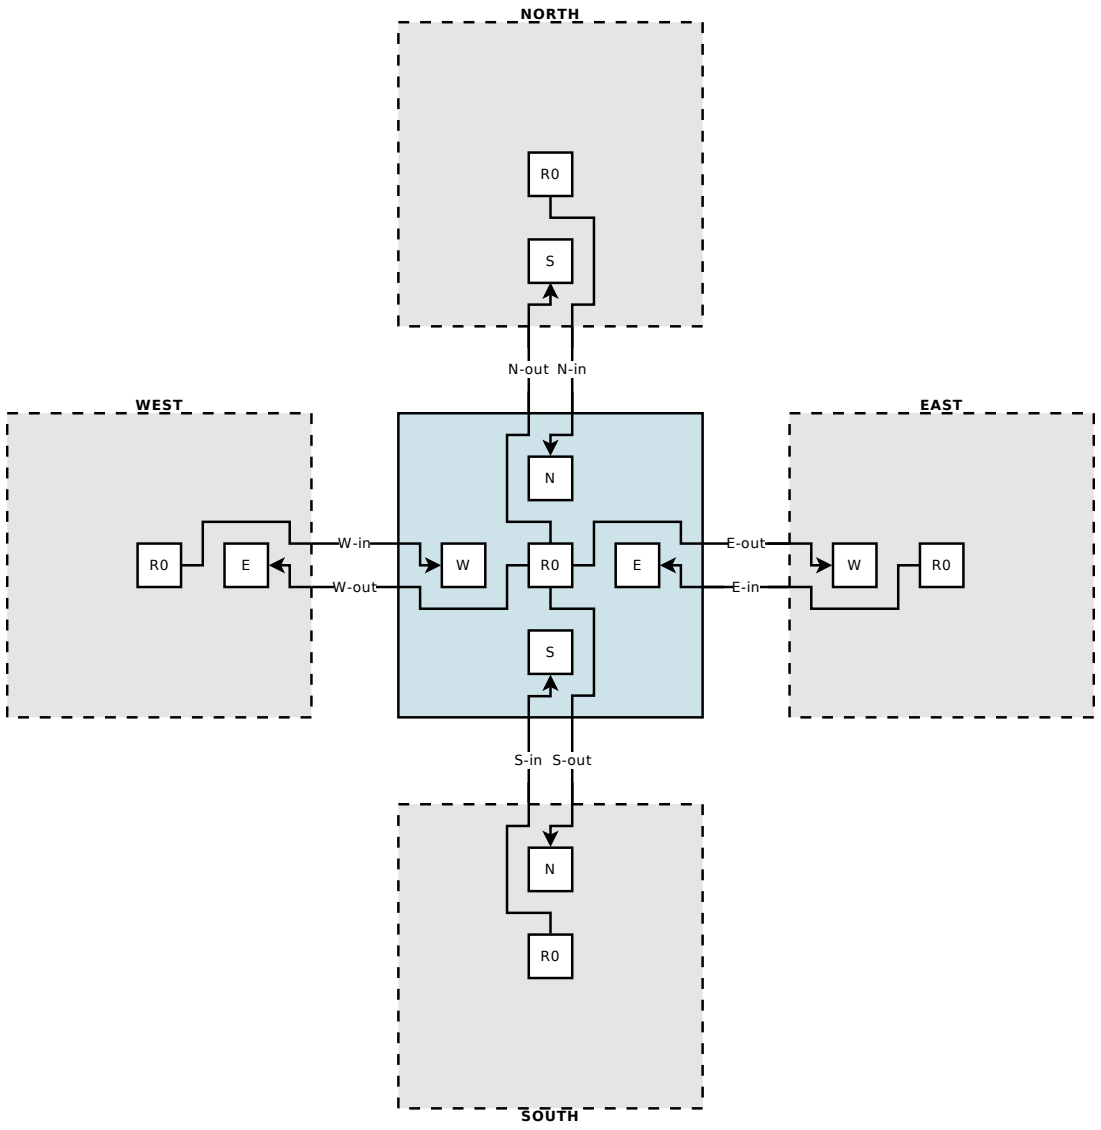
[picture p15: figure]
N-out N-in; S-in S-out; W-out; E-out; WEST; NORTH; EAST; SOUTH

# DATA FLOW BETWEEN ADJACENT NODES
