martingms/dmpro2012ytelse/doc/fpga/fpga_simd_dataflow_fwrd.pdf

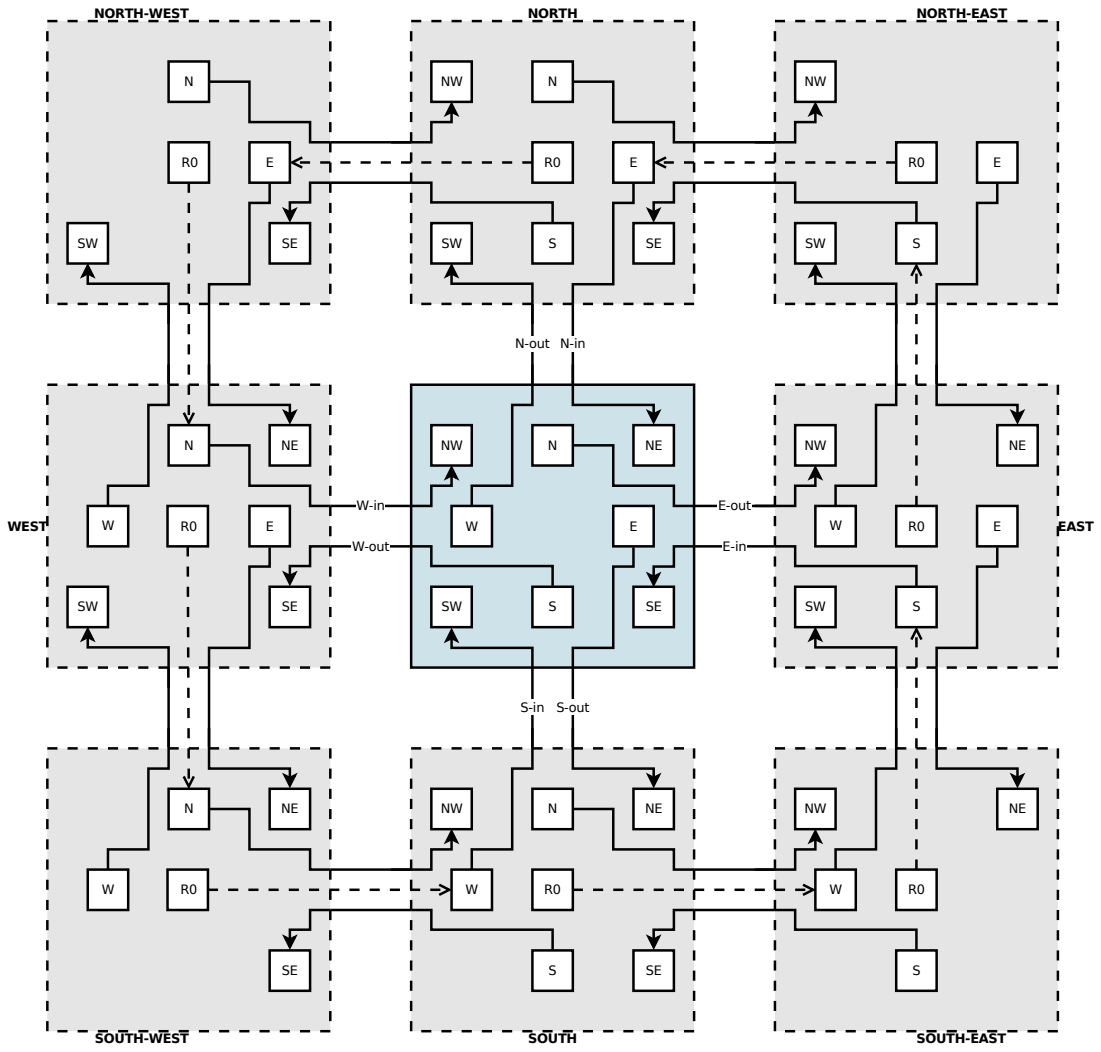
[picture p16: figure]
N-out N-in; S-in S-out; W-out; E-out; WEST; NORTH; EAST; SOUTH; NORTH-EAST; SOUTH-WEST; SOUTH-EAST; NORTH-WEST

# DATA FLOW BETWEEN NON-ADJACENT NODES (counterclockwise forwarding)
