martingms/dmpro2012ytelse/doc/fpga/fpga_simd_datacom.pdf

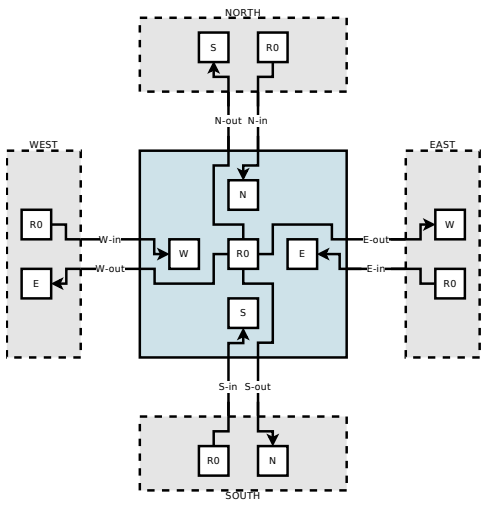
[picture p17: figure]
N-out N-in; S-in S-out; W-out; E-out; WEST; NORTH; EAST; SOUTH
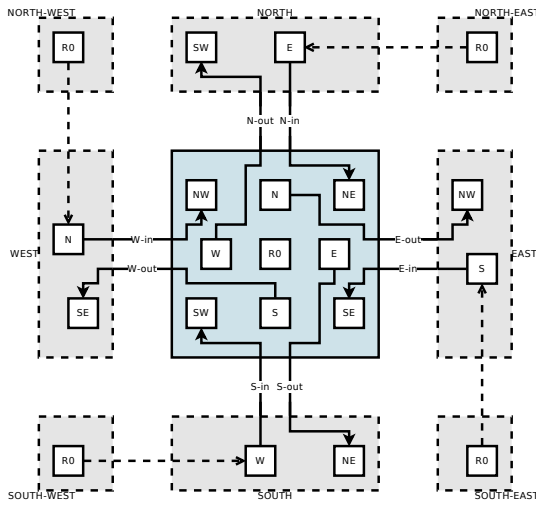
[picture p18: figure]
N-out N-in; S-in S-out; W-out; E-out; WEST; NORTH; EAST; SOUTH; NORTH-EAST; SOUTH-EAST; SOUTH-WEST; NORTH-WEST

DATA FLOW BETWEEN ADJACENT NODES | DATA FLOW BETWEEN NON-ADJACENT NODES
