martingms/dmpro2012ytelse/report/config.tex

%%% Personal data.
\usepackage[utf8x]{inputenc} % Fix æøå before they actually appear

\newcommand{\ourTitle}{256 Shades of Gray}
\newcommand{\ourNames}{
Christer Emil Haga Bru\\
Vegard Edvardsen\\
Sondre Andreas Engebråten\\
Hans Kristian Flaatten\\
Martin Gammelsæter\\
Jean Niklas L'orange\\ % "'" is before "o" in the ASCII-table :D
Erik Lothe\\
Andreas Steensnæs Morland\\
Mads Buvik Sandvei\\
Einar Johan Trøan Sømåen\\
Lichao Tang\\
Håkon Opsvik Wikene\\
Trygve Aaberge\\
}
\newcommand{\ourDate}{November 21, 2012}
\newcommand{\ourProject}{TDT4295 Computer Design, Project Work}
\newcommand{\ourDept}{Department of Computer and Information Science}
\newcommand{\ourFaculty}{Computer Architecture and Design}
\newcommand{\ourUni}{Norwegian University of Science and Technology}
\newcommand{\myVersion}{0.1.0-alpha03}

%% Functional requirements as commands? Yessir.

\newcommand{\FRI}{The image processor should be fast enough to output unmodified
    8-bit images of at least $320\times240$ resolution at 10 frames per second.}
\newcommand{\FRII}{The image processor should be generally programmable.}
\newcommand{\FRIII}{The machine should have a video port for image output.}
\newcommand{\FRIV}{It should be possible to operate the machine with on-board 
    buttons.}
\newcommand{\FRV}{The machine should have on-board \acp{LED} for visual
    feedback.}
\newcommand{\FRVI}{There should be developer tools (assembler) available for the
    machine.}
\newcommand{\FRVII}{The machine should have example programs demonstrating its 
    capabilities, such as a video player and a median filter.}

%%% Util commands
\newcommand{\thx}[1]{\spacedlowsmallcaps{#1}}
\newcommand{\thxc}[1]{\multicolumn{1}{c}{\spacedlowsmallcaps{#1}}}
\newcommand{\subsubsubsection}[1]{\paragraph{#1}}
\newcommand{\TODO}[1]{}
\newcommand{\NOTE}[1]{}
\newcommand{\CHECK}[1]{}
\newcommand{\acfoot}[1]{\acsu{#1}\footnote{\acl*{#1}}}

%%% Util environments
\newenvironment{Test}[0]
{\begin{addmargin}[1cm]{0cm}}
{\end{addmargin}}

%%% Packages

\usepackage{scrextend}
\usepackage{float}
\usepackage{graphicx}
\usepackage{tabularx}
\usepackage{multirow}
\usepackage{comment}
\usepackage{caption}
\usepackage{hyperref}
\usepackage{appendix}
\usepackage[nohyperlinks]{acronym}

%%% Fine-tuning of this classicthesis
\newcounter{dummy} % Fikser hyperref-feil (?)
\usepackage{textcomp} % Fikser feilmelding om at fonter er bytta ut
\usepackage{scrhack} % Fikser warnings i listings

\usepackage{xspace} % Fikser mellomrom etter makroer.
\usepackage{mparhack} % Margins, how do they work.
\usepackage{fixltx2e} % Generell "fiks" på diverse andre fails
                      % (ser ut til å funke?)

%%% Hyperref setup
\hypersetup{
    %draft, % Fjerner alle lenker. Kjekt for 
    colorlinks=true, linktocpage=true, pdfstartpage=3, pdfstartview=FitV,
    % Fjern kommenteringa på lenkene under for svarte lenker
    % colorlinks=false, linktocpage=false, pdfborder={0 0 0},
    breaklinks=true, pdfpagemode=UseNone, pageanchor=true, 
    pdfpagemode=UseOutlines,plainpages=false, bookmarksnumbered, 
    bookmarksopen=true, bookmarksopenlevel=1, hypertexnames=true, 
    pdfhighlight=/O,
    urlcolor=webbrown, linkcolor=RoyalBlue, citecolor=webgreen, 
    % pagecolor=RoyalBlue,
    % urlcolor=Black, linkcolor=Black, citecolor=Black, %pagecolor=Black,
    pdftitle={\ourTitle},
    pdfauthor={\textcopyright\ C. Bru et al, \ourUni, \ourFaculty},
    pdfsubject={\ourProject},
}

\renewcommand{\bflabel}[1]{{#1}\hfill}

\usepackage[usenames,dvipsnames]{xcolor}
\usepackage[chapter]{minted}
\usemintedstyle{soderberg}
\newenvironment{code}{\captionsetup{type=listing}\centering}{}
\renewcommand\listoflistingscaption{List of Listings}

\newminted{lena}{frame=single,linenos}

\usepackage{amsmath, amssymb}
%% Note: eulermath is sweet for equations, but requires a 500 mb font bundle
%% installed. Better leave it off and remember to flip it on before sending.
\usepackage[dottedtoc,%eulermath,%listings,
            floatperchapter,%drafting
            ]{classicthesis}
\setlength{\parskip}{\bigskipamount}
\setlength{\parindent}{0pt}
\usepackage{tikz}

%\renewcommand{\lstlistlistingname}{List of Listings}
