martingms/dmpro2012ytelse/report/ch/conc/future.tex

\section{Future Work}
The limited number of cores we were able to fit on the FPGA is a major limitation
of our system. Future work could be to work on reducing the complexity of the
SIMD nodes to fit more onto the FPGA, and another option may be to choose a larger
FPGA.

Once the core design has been improved to fit more cores, or a much larger FPGA is
used, we might consider adding some instructions we chose to strip out. Multiplication
and division are two very useful instructions we did not include that, if included, would simplify
general coding on the LENA architecture.

A second major limitation was the reading speed from the SD card.
The chosen microcontroller, the AT32UC3A0512, has limited possibilities of input
from mass storage devices. A possibly faster solution is Ethernet input, but this
would require another computer to feed information to the system. As the group did not want the system to be dependent on another computer, we did not look further into this possibilitiy.

Another possibility for improving input speed could be to switch to an AT32UC3A3xxx
microcontroller, as these have support for SD card in 4 bit bus mode, which should be
able to read SD cards much faster than in our current solution.
