martingms/dmpro2012ytelse/report/ch/pcb/introduction.tex

\section {Design Choices}

\subsection {Memory}
The overall design for our machine specifies various different, separate memories. One for data,
one for instructions and one for the VGA. The data, VGA and AVR memories use 8-bit chips to match
their word size. And the instruction memory uses 2x16-bit chips with address lines connected
together and 8 ignored I/O-pins, to match its 24-bit word size.
\begin{comment}
Tok dette ut siden dette allerede er diskutert tidligere i rapporten
~Mads

One of the
earliest design choices that led to this was the decision to have separate instruction/data-memories.
The reasoning behind this choice being that we could avoid the bottleneck that would be introduced
from sharing memories.
\end{comment}

\begin{comment}
Skrev om for å skille ut prosess
~Mads

Since the requirements for the data/instruction memories differed in both size and word-width 
we wound up with not only separate, but also different chips for this purpose (The data-memory required
8-bit words, the instruction-width was 24-bit, and since we wanted to avoid using multiple memory accesses
to get a complete instruction, we needed a wide enough memory chip for that purpose. 24-bit chips were out of
production, and 32-bit memory was too expensive, thus the solution became 2x16-bit chips with their address lines
connected together and 8 ignored I/O-pins, effectively making them a 24-bit memory).

Since we wanted to reduce the sharing of memories as much as possible, we also needed a separate memory for
our \ac{VGA} controller, as that needed to read it's buffer as fast as possible without interfering with the speed
of the rest of the system. This called for a memory that was big enough to hold at least a full screen-frame,
at 8-bit per pixel (since each pixel is an 8-bit greyscale pixel).

To reduce the possibility of having too slow data-access from the AVR, an extra memory was added to work as
a buffer for the AVR as well. This design choice was made {\em after} ordering, which meant that we had to choose from
the chips we had already ordered to fit this purpose. Since this was intended to carry data intended for the rest
of the system, and as the rest of the system is working with data in 8-bit bytes, we ended up using one of the
extra chips ordered as \ac{VGA} memory for this purpose.

Forresten, da vart det så kort at jeg bare tødde det in i avsnittet over. Må få jobbet prosess-delene inn igjen et eller annet sted!
~Mads
\end{comment}

\subsection{VGA}
Our initial plans were to create our own \ac{VGA} controller in the \ac{FPGA}, but since having video output was mission critical
for our project, we really wanted to have a fallback solution in case our own
\ac{VGA} controller solution ended up not working.
To allow for this fallback, we added the necessary connectors for the external \ac{VGA} module that Festina Lente used last year,
even though that module was known to be too slow to be able to display images at our required speeds, it would at least give us
some way of outputting anything at all if our own solution failed.

\subsection {Communication}
The intention was to use the \ac{SD} card reader as our main source of data and instructions. However, as our system would
not fulfill our functional requirements unless we were able to get data into it at the speeds specified in requirement
FR1, we opted to also have a fallback solution here. Thus we also added \ac{USB} and RS232 as fallback solutions for getting data into, or communicating with, the computer.
