martingms/dmpro2012ytelse/report/fig/apx/bus_pin_mapping.tex

\begin{table}[h]
  \centering
  \begin{tabular}{l l} \toprule
    \thx{Line} & \thx{Usage}\\ \midrule
	LENA\_IO\_00..07 & Data bus (LSB..MSB)\\
	LENA\_IO\_CTRL & Interrupt / Ack from LENA.\\
  \end{tabular}
  \caption{LENA out bus}
  \label{tab:outbus}
\end{table}

\begin{table}[h]
  \centering
  \begin{tabular}{l l} \toprule
    \thx{Line} & \thx{Usage}\\ \midrule
	LENA\_IN\_00..23 & Data bus (LSB..MSB)\\
	LENA\_IN\_24 & Data bus ready\\ \bottomrule
  \end{tabular}
  \caption{LENA in bus}
  \label{tab:inbus}
\end{table}

\begin{table}[h]
  \centering
  \begin{tabular}{l l} \toprule
    \thx{Line} & \thx{Usage}\\ \midrule
	LENA\_IN\_25 & Set LENA state\\
	LENA\_IN\_26 & State bus (LSB)\\
	LENA\_IN\_27 & State bus\\
	LENA\_IN\_28 & State bus (MSB)\\ \bottomrule
  \end{tabular}
  \caption{LENA state bus}
  \label{tab:statebus}
\end{table}
