martingms/dmpro2012ytelse/report/fig/avr/intro-picture.tex

\begin{figure}[h]
  \centering
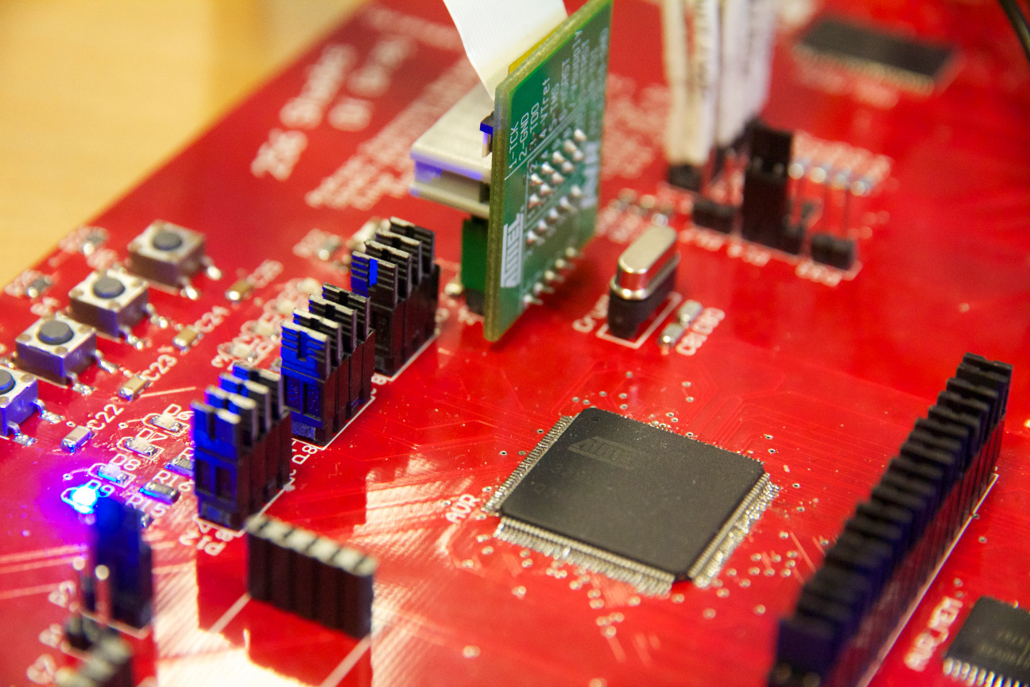
[picture p23: report/fig/avr/intro-picture.jpg]
  
  \caption{The System Control Unit}
  \label{fig:scu-intro-picture}
\end{figure}
