martingms/dmpro2012ytelse/report/fig/intro/nonfunc.tex

\begin{table}[h]
  \centering
  \begin{tabularx}{\textwidth}{l X}\toprule
    \thxc{Name} & \thxc{Description}\\ \midrule
    {\sc NFR1} & The machine must use a Xilinx Spartan 3 XC3S500E PQG208 FPGA\\
    {\sc NFR2} & The machine must use one AVR32 UC3A microcontroller\\
    {\sc NFR3} & The budget of $\sim$ 10 000 NOK must cover all \ac{PCB} and
    component costs\\
    {\sc NFR4} & The image processor should consist of multiple cores arranged 
    in a matrix\\
    {\sc NFR5} & The machine should be optimized for performance\\
    \bottomrule
  \end{tabularx}
  \caption[Non-functional requirements]{The non-functional requirements}
  \label{fig:nonfunc-req}
\end{table}
