martingms/dmpro2012ytelse/report/fig/fpga/fpga-simd-fwrd.pdf

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

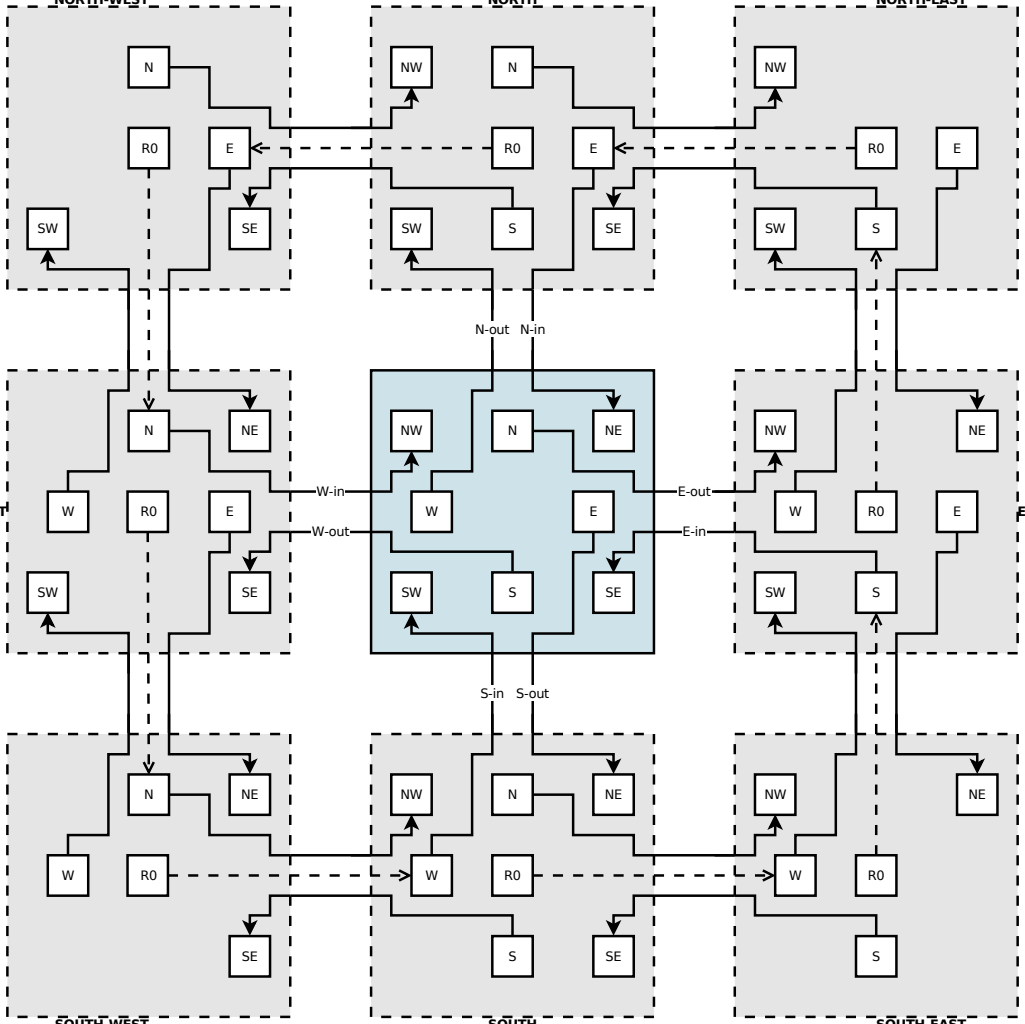
[picture p24: figure]
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
