martingms/dmpro2012ytelse/report/fig/disc/memarch.pdf

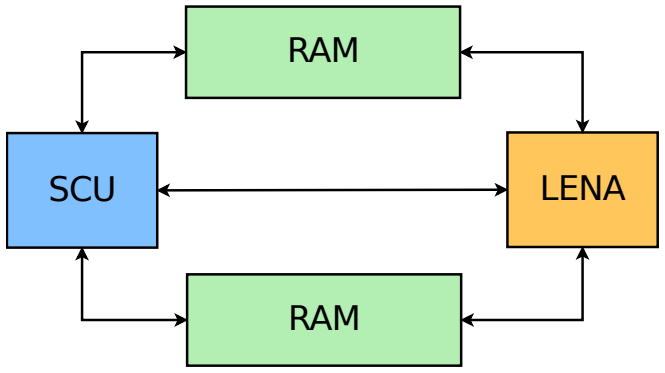
[picture p26: figure]
RAM; LENA; SCU

RAM

RAM

RAM

LENA

RAM

LENA

LENA

SCU

SCU
SCU
