martingms/dmpro2012ytelse/report/fig/fpga/vga-circuit.pdf

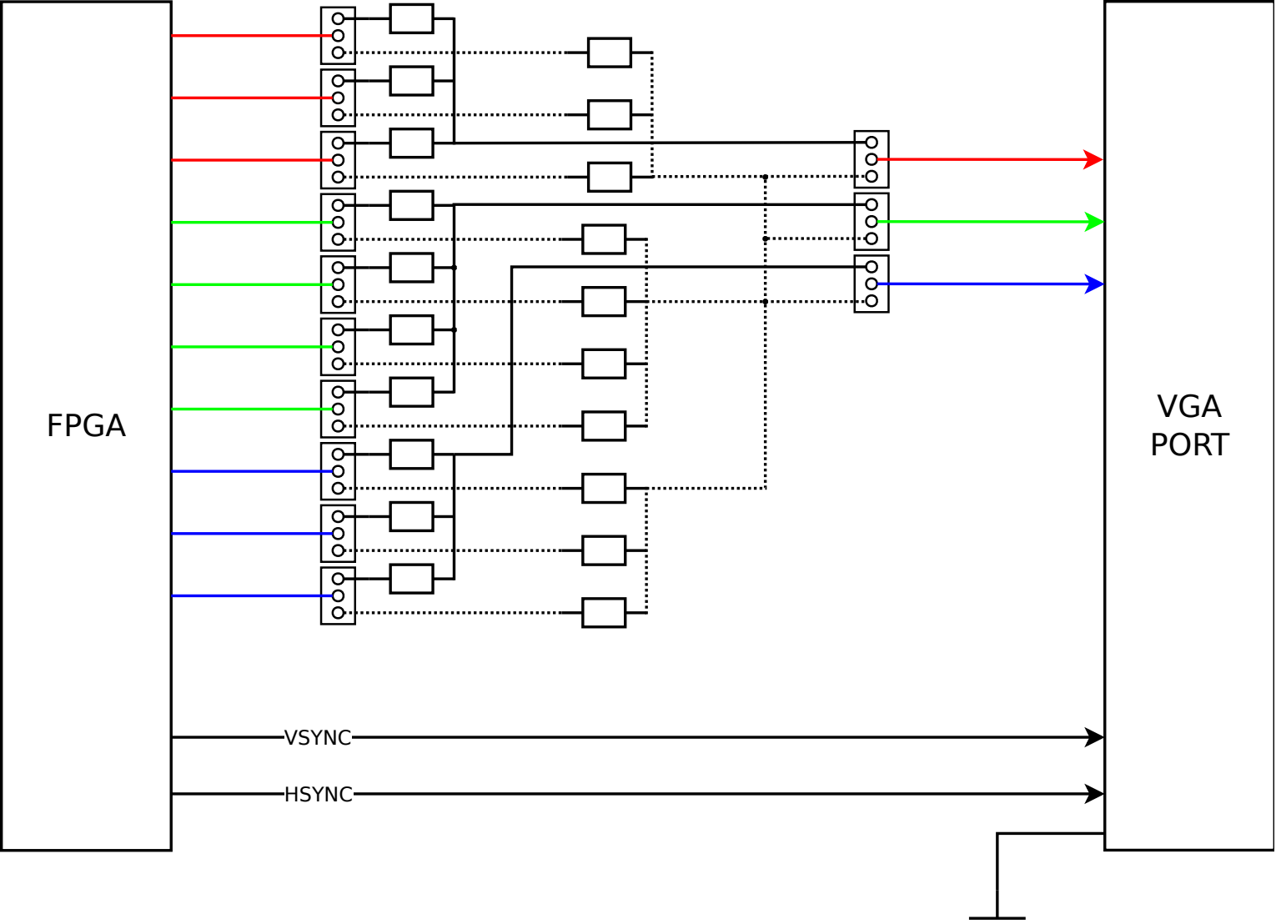
[picture p27: figure]
FPGA; VGA; PORT; VSYNC; HSYNC
