martingms/dmpro2012ytelse/doc/fpga/fpga_ctrl_core.pdf

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

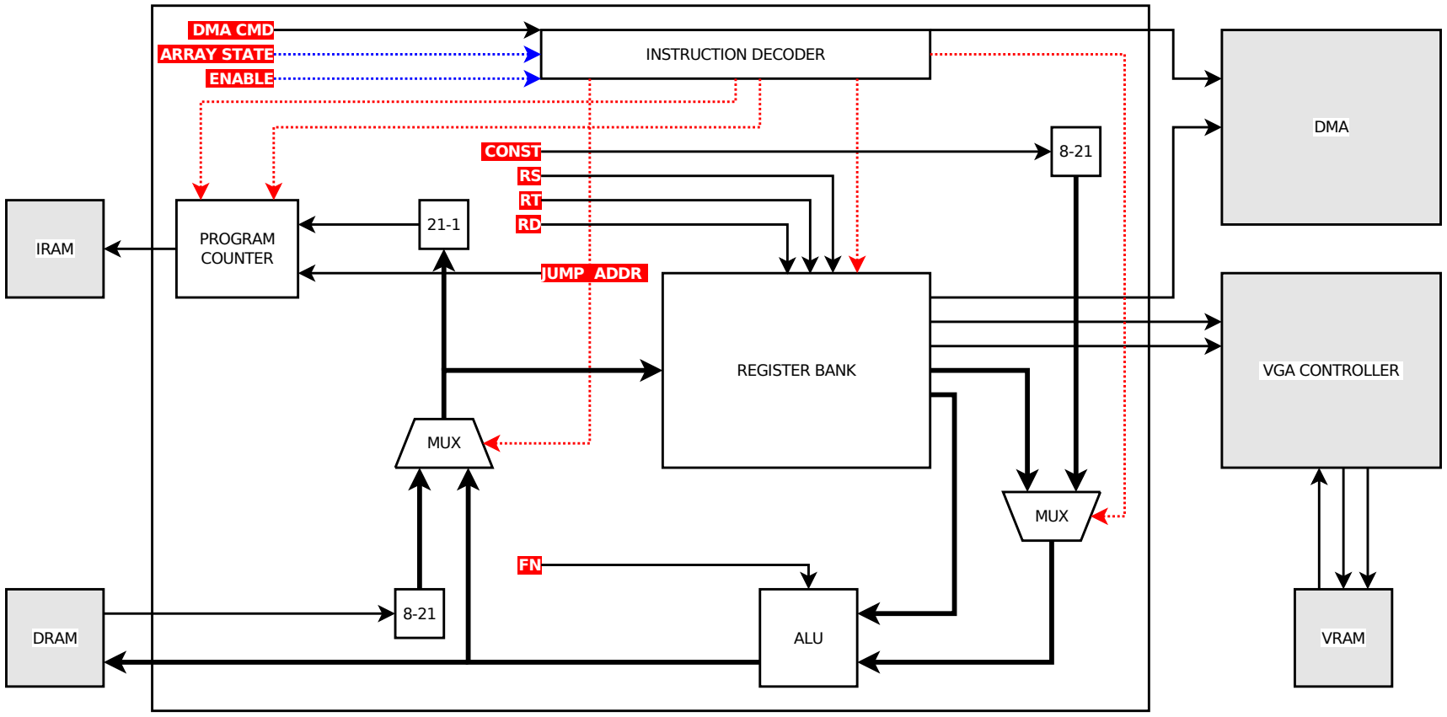
[picture p28: figure]
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
