martingms/dmpro2012ytelse/doc/fpga/fpga_simd_edge.pdf

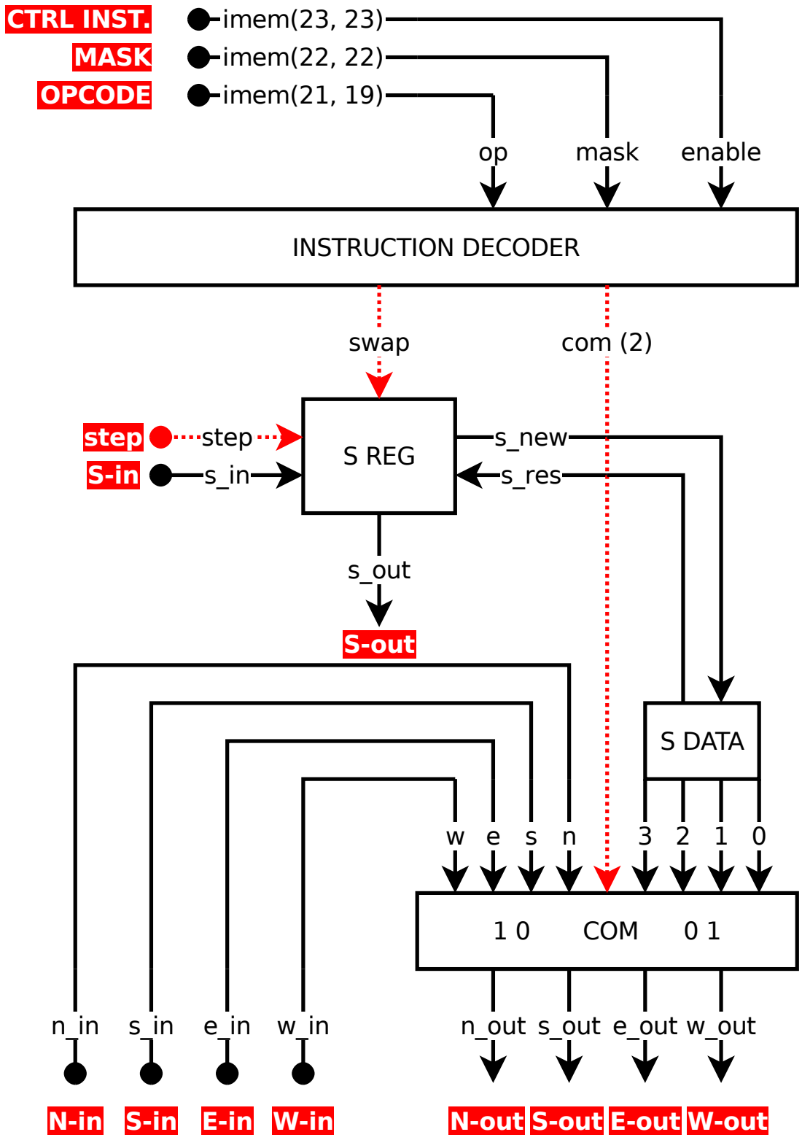
[picture p29: figure]
COM; INSTRUCTION DECODER; S REG s_in; s_out; step; s_res; s_new; OPCODE; imem(21, 19); swap; CTRL INST.; imem(23, 23); enable; MASK; mask; imem(22, 22); n_out s_out e_out w_out; N-out S-out E-out W-out; step S-in; S-out; com (2); S DATA
