martingms/dmpro2012ytelse/doc/fpga/fpga_states.pdf

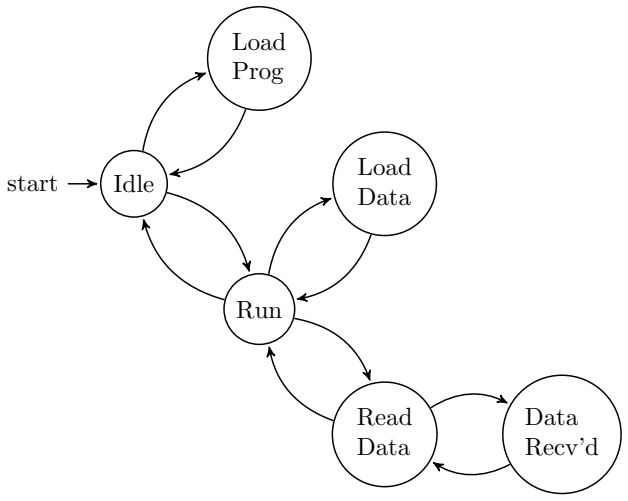
[picture p30: figure]
start; Idle; Load Prog; Run; Load Data; Read Data; Data Recv’d
