martingms/dmpro2012ytelse/doc/architecture1/Programvarediagram.png

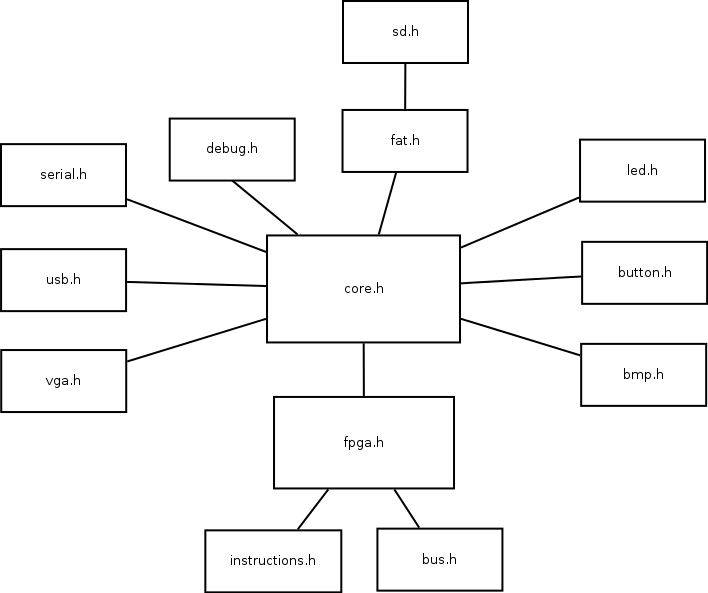
doc/architecture1/Programvarediagram.png
