martingms/dmpro2012ytelse/doc/design_spec/systemarkitektur-0.png

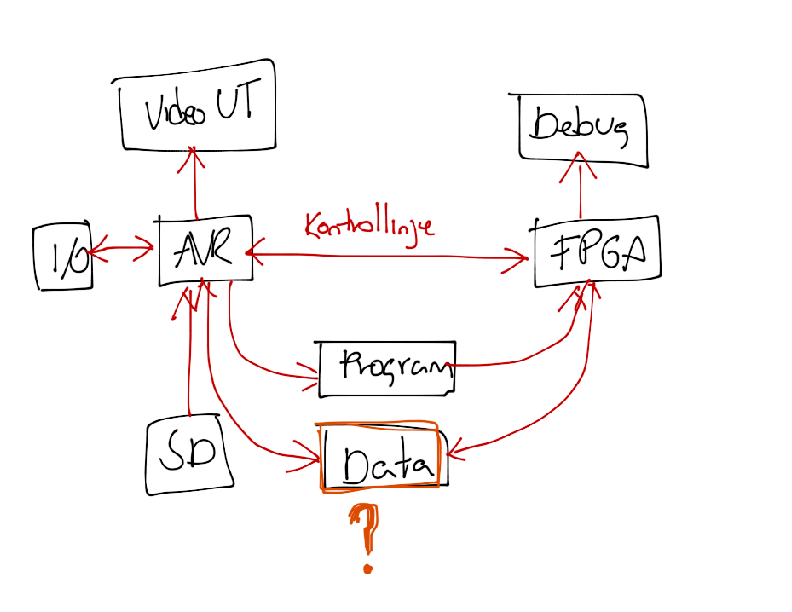
doc/design_spec/systemarkitektur-0.png
