martingms/dmpro2012ytelse/doc/design_spec/systemarkitektur-1.png

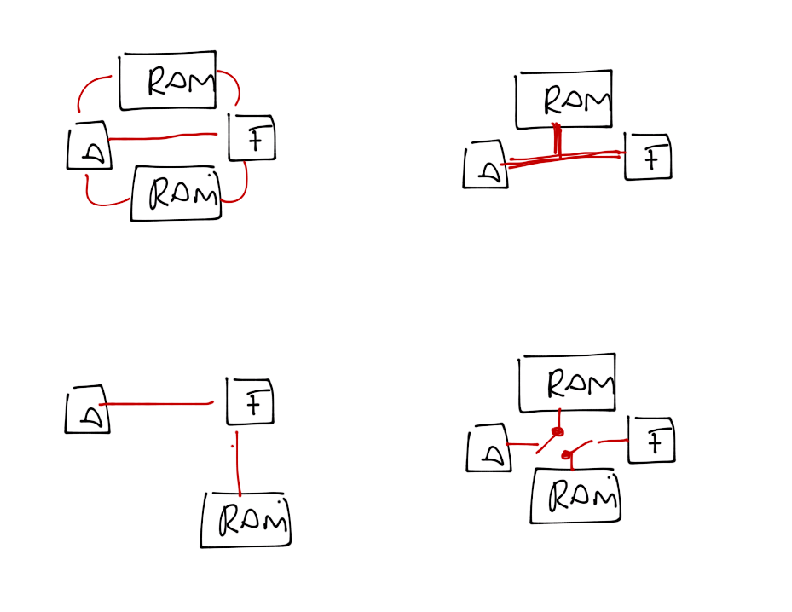
doc/design_spec/systemarkitektur-1.png
