martingms/dmpro2012ytelse/doc/design_spec/systemarkitektur-2.png

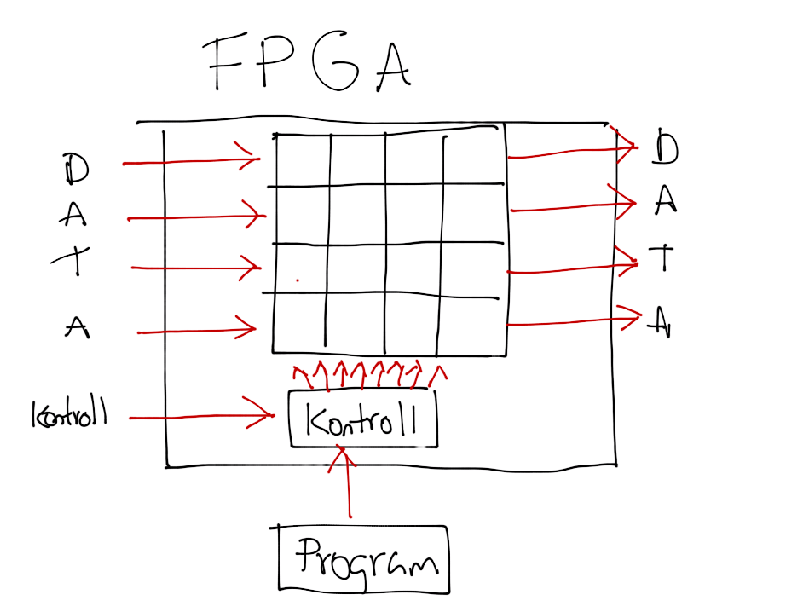
doc/design_spec/systemarkitektur-2.png
