martingms/dmpro2012ytelse/doc/design_spec/systemarkitektur-3.png

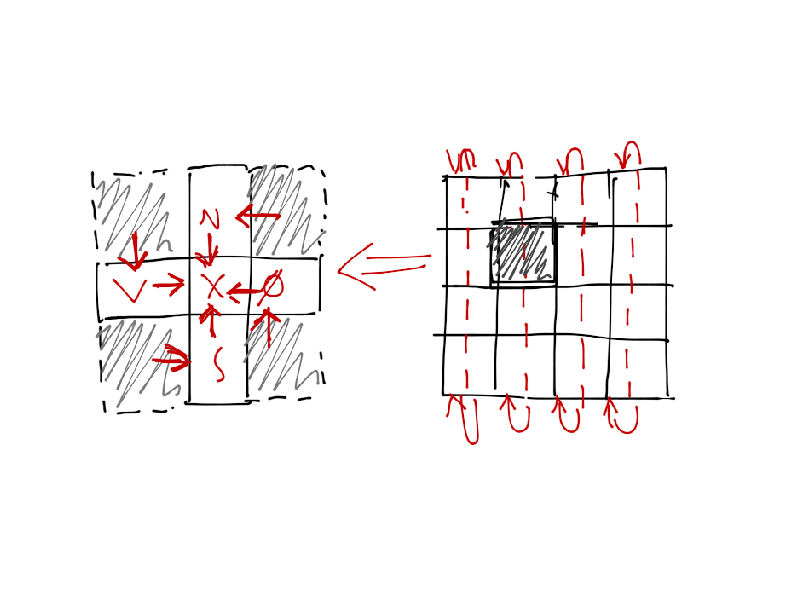
doc/design_spec/systemarkitektur-3.png
