martingms/dmpro2012ytelse/doc/fpga/skisse_fpga_2012-09-10.jpg

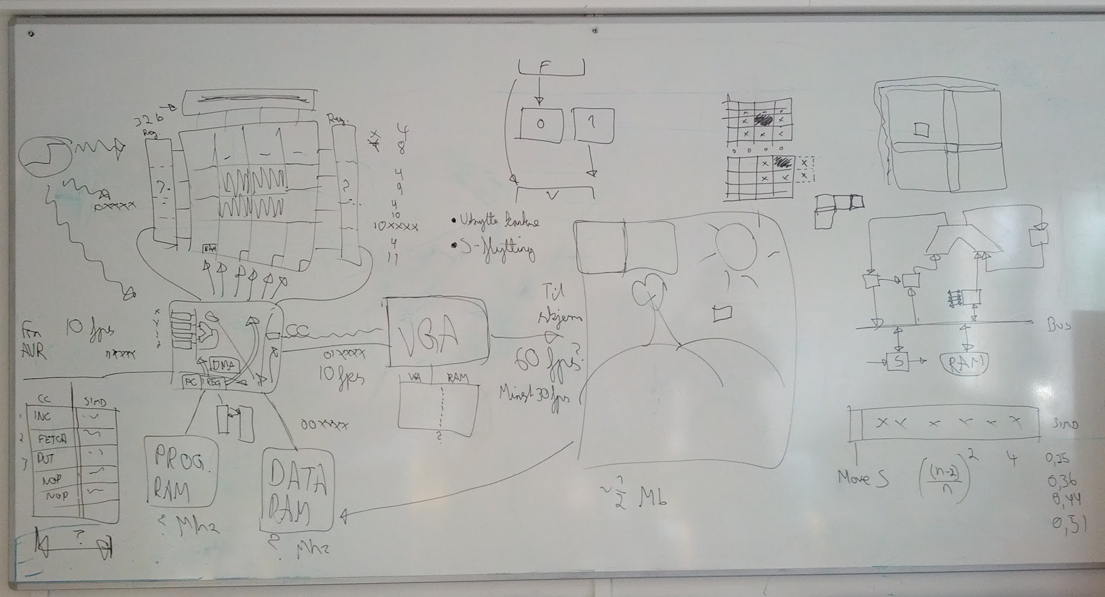
doc/fpga/skisse_fpga_2012-09-10.jpg
