martingms/dmpro2012ytelse/doc/pcb/d_review_26-09.png

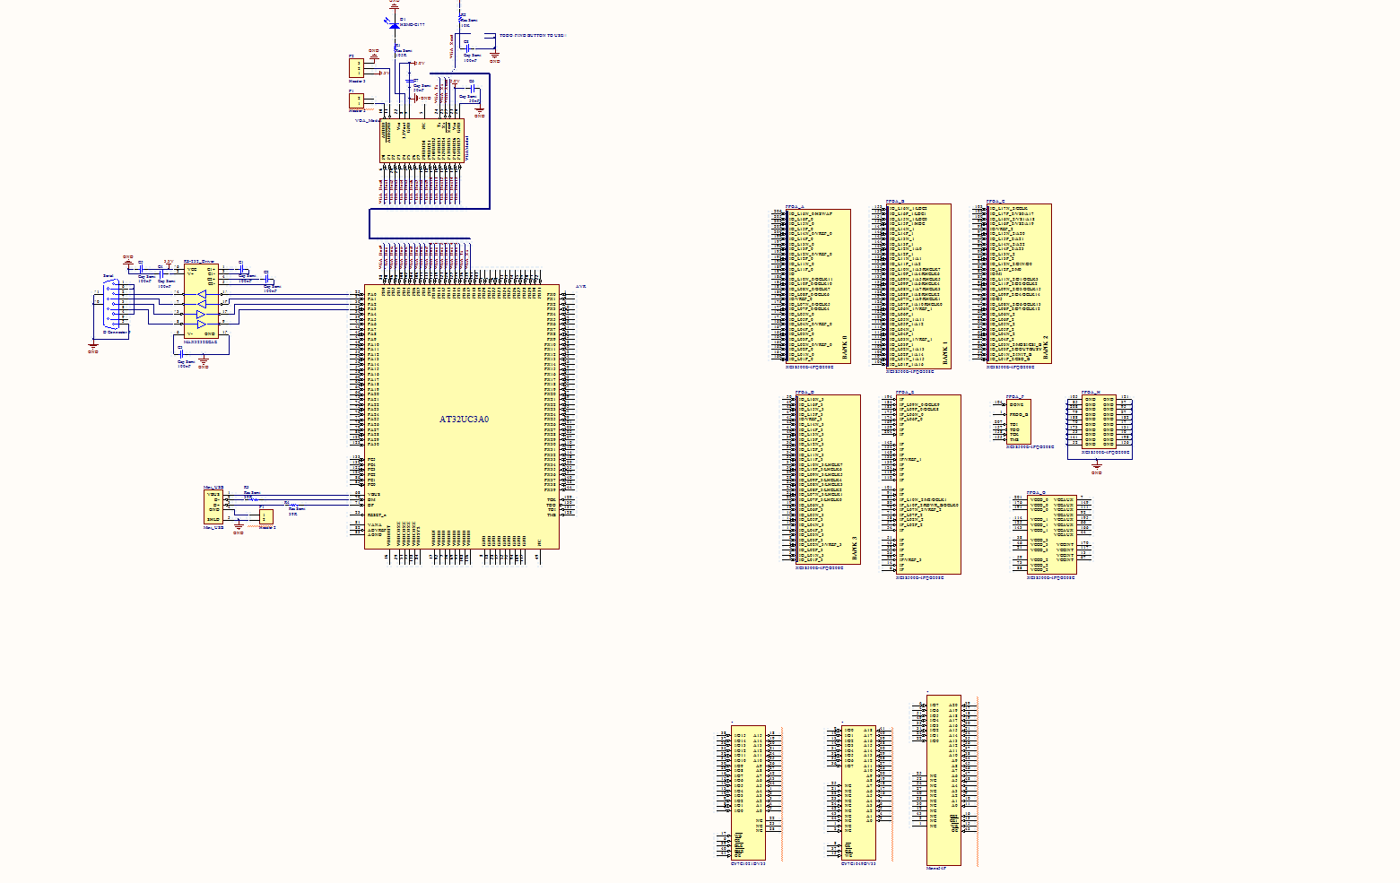
doc/pcb/d_review_26-09.png
