martingms/dmpro2012ytelse/doc/pcb/pcb_d_review_26-09.png

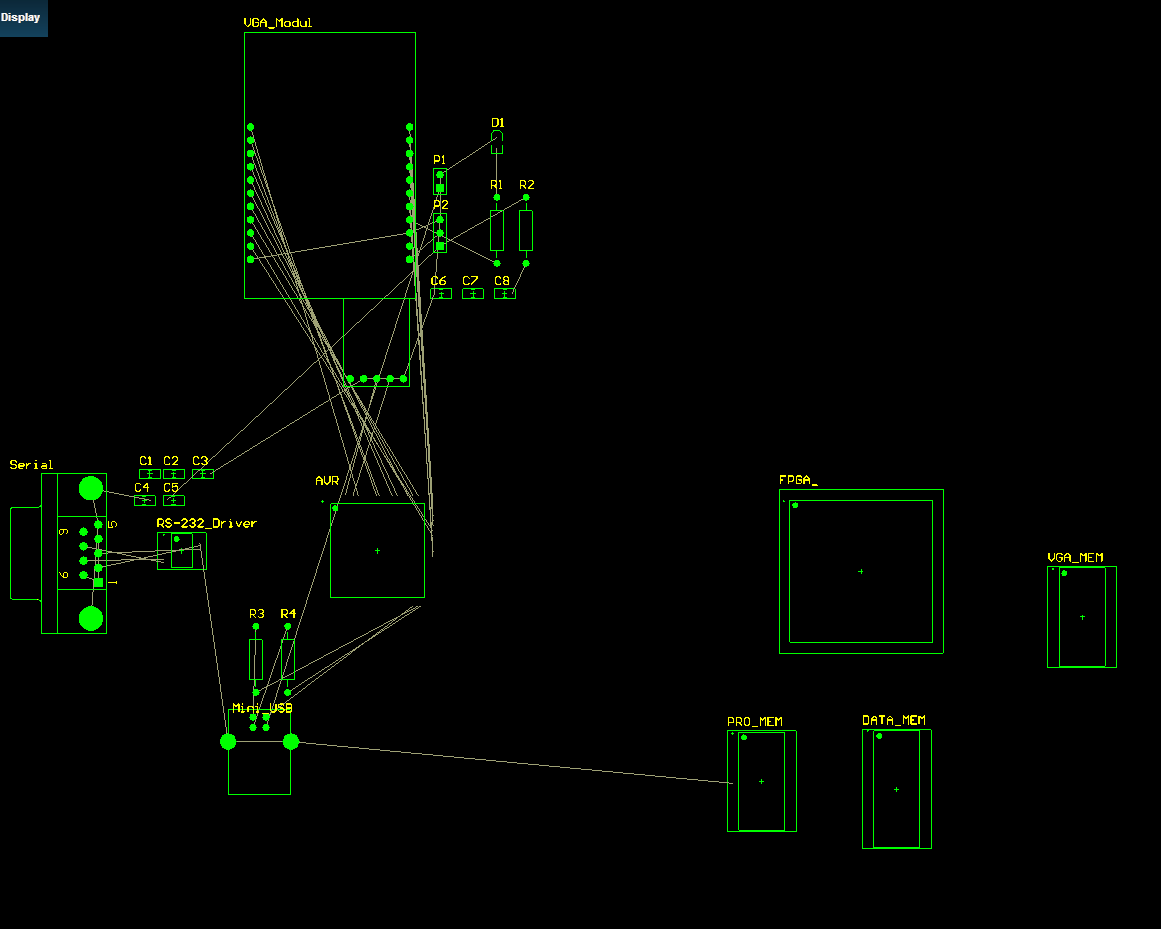
doc/pcb/pcb_d_review_26-09.png
