martingms/dmpro2012ytelse/pcb/altium/hull.PNG

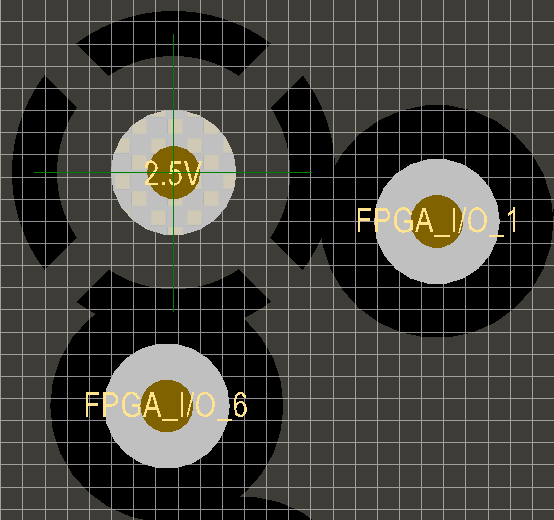
pcb/altium/hull.PNG
