martingms/dmpro2012ytelse/pcb/altium/lenna208.bmp

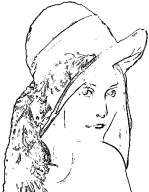
pcb/altium/lenna208.bmp
