martingms/dmpro2012ytelse/pcb/altium/lenna-monochrome.bmp

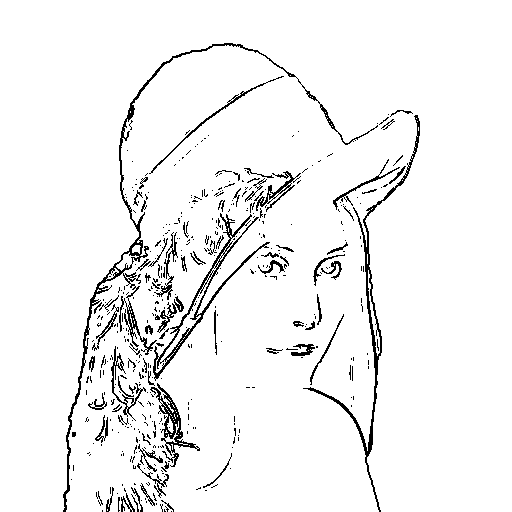
pcb/altium/lenna-monochrome.bmp
