martingms/dmpro2012ytelse/report/fig/pcb/power_planes.PNG

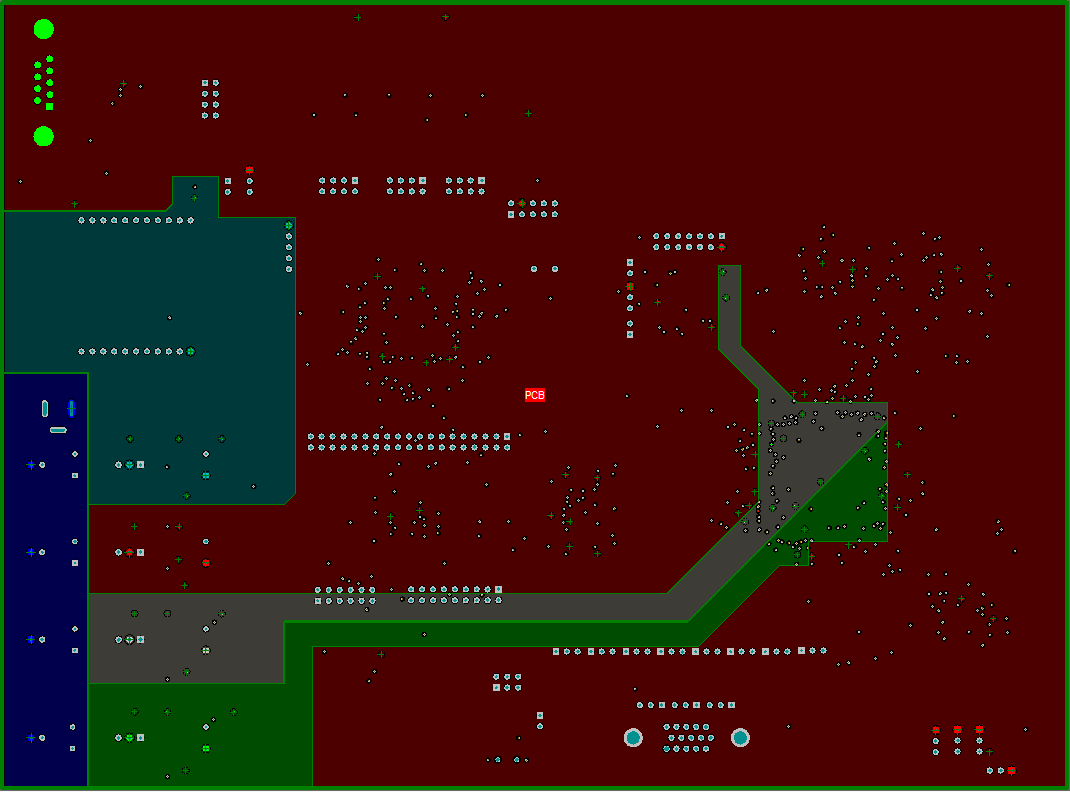
report/fig/pcb/power_planes.PNG
