martingms/dmpro2012ytelse/tools/gol_patterns/gosper_glider_gun.png

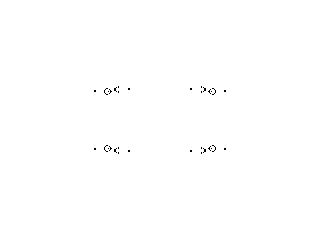
tools/gol_patterns/gosper_glider_gun.png
