martingms/dmpro2012ytelse/tools/gol_patterns/line.png

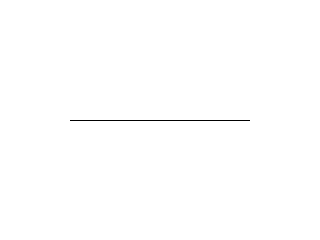
tools/gol_patterns/line.png
