martingms/dmpro2012ytelse/tools/gol_patterns/p138.png

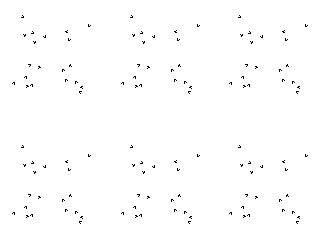
tools/gol_patterns/p138.png
