martingms/dmpro2012ytelse/tools/gol_patterns/puffer_breeder.png

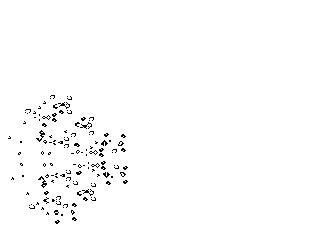
tools/gol_patterns/puffer_breeder.png
