martingms/dmpro2012ytelse/report/apx/pcb/ordered-parts.tex

\clearpage
\section{Ordered Parts}\label{app:ordered-parts}
We ordered the following components. They were ordered from
Farnell. All prices are in NOK.

\input{fig/parts/pcb-parts1.tex}
\input{fig/parts/pcb-parts2.tex}
\input{fig/parts/pcb-parts3.tex}
