martingms/dmpro2012ytelse/report/fig/parts/pcb-parts2.tex

\begin{table}[H]
  \centering
  \begin{tabular}{l r r r r}\toprule
    \thx{Name} & \thx{Product ID} & \thx{Count} & \thx{Price}
    & \thx{Total} \\ \midrule
     Crystal 50.0 MHz    & 1843360   & 2   &    6.09  &  12.18  \\
     Crystal 40.0 MHz    & 1611785   & 2   &    3.45  &   6.90  \\
     Crystal 16.0 MHz    & 1640875   & 2   &   14.59  &  29.18  \\
     Crystal 20.0 MHz    & 1640878   & 2   &   14.59  &  29.18  \\
     Socket              & 224960    & 1   &   48.59  &  48.59  \\
     Flash               & 1605850   & 1   &   62.95  &  62.95  \\
     Capacitor 100$\mu$f & 1889290   & 1   &    6.66  &  99.90  \\
     Resistor 105R       & 2142134   & 12  &    0.42  &   5.04  \\
     Resistor 39R        & 9337377RL & 150 &    0.16  &  23.70  \\ %% 0.158
     Resistor 360R       & 9336400   & 50  &    0.22  &  11.00  \\
     Resistor 191R       & 2139374   & 50  &    0.09  &   4.55  \\ %% 0.091
     Resistor 100R       & 2074543   & 100 &    0.14  &  13.70  \\ %% 0.137
     Resistor 0R         & 9240273RL & 150 &    0.07  &   9.75  \\ %% 0.065
     Micro SD 2GB        & 1795130   & 1   &  113.52  & 113.52  \\
     Header              & 9728856   & 2   &   22.32  &  44.64  \\
     Capacitor 47nf      & 1740718   & 60  &    1.97  & 118.20  \\
     \bottomrule
  \end{tabular}
  \caption{Components ordered in the first order continued}
  \label{fig:pcb-components}
\end{table}
