martingms/dmpro2012ytelse/report/fig/parts/pcb-parts3.tex

\begin{table}[H]
  \centering
  \begin{tabularx}{\textwidth}{l c r r r}\toprule
    \thx{Name} & \thx{Product ID} & \thx{Count} & \thx{Price} & \thx{Total}
    \\ \midrule
    Program memory\\ (64k $\times$ 16bit) & 2115418 & 1 & 21.27  & 21.27  \\
    VGA memory\\ (512 $\times$ 8bit)    & 1688739 & 2 &  55.94  & 111.88  \\
    Oscillator        & 1611846 & 1 &  26.09  &  26.09  \\
 Voltage regulator \\ adjustable& 1685484 & 4 &  38.34  &  153.36  \\
    Voltage regulator \\ 3.3V & 1469037 &2 &  31.96  & 63.92 \\
     Flash               & 1605850   & 1   &   62.95  &  62.95  \\
 \bottomrule
  \end{tabularx}
  \caption{Spare parts ordered for the third board}
\label{fig:pcb-components}
\end{table}
