martingms/dmpro2012ytelse/report/fig/parts/pcb-parts1.tex

\begin{table}[H]
  \centering
  \begin{tabularx}{\textwidth}{l c r r r}\toprule
    \thx{Name} & \thx{Product ID} & \thx{Count} & \thx{Price} & \thx{Total}
    \\ \midrule
    SD card reader               & 2081360 & 2 &  38.78  &  77.56  \\
    Serial port                  & 1653975 & 2 &   8.63  &  17.26  \\
    Serial driver                & 1287435 & 2 &  24.25  &  48.50  \\
    USB port (Mini B)            & 1243250 & 2 &  17.89  &  35.78  \\
    VGA port                     & 1056018 & 2 &  91.61  & 183.22  \\
    Data memory\\ (2M $\times$ 8bit)    & 2115432 & 2 & 326.02  & 652.04  \\
    Program memory\\ (64k $\times$ 16bit) & 2115418 & 2 & 19.85  & 39.7  \\
    VGA memory\\ (512 $\times$ 8bit)    & 1688739 & 2 &  57.43  & 111.88  \\
    Switch			 & 3801287 & 25 &  1.84  &  46.00  \\
    LED		 	& 1716765 & 20 &  1.91  &  38.20  \\
    Voltage regulator \\ adjustable& 1685484 & 3 &  38.34  &  115.02  \\
    Voltage regulator \\ 3.3V & 1469037 &1 &  31.96  &  31.96 \\
    Oscillator        & 1611846 & 1 &  26.09  &  26.09 \\
    Socket for\\Crystals        & 4695434 & 10 & 8.99  &  89.90  \\
    Crystal\\12.0 MHz        & 1640871 & 2 &  10.21  &  20.42  \\
    Crystal \\ 30.0 MHz       & 1842246 & 2 &  4.04  &  8.08  \\
    \bottomrule
  \end{tabularx}
  \caption{Components ordered in the first order}
\end{table}
