martingms/dmpro2012ytelse/report/fig/parts/pcb-parts.tex

\begin{table}[h]
  \centering
  \begin{tabularx}{\textwidth}{l c r r r}\toprule
    \thx{Name} & \thx{Product ID} & \thx{Count} & \thx{Price} & \thx{Total}
    \\ \midrule
    SD card reader               & 2081360 & 2 &  38,78 kr &  77,56 kr \\
    \midrule
    Serial port                  & 1653975 & 2 &   8,63 kr &  17,26 kr \\
    \midrule
    Serial driver                & 1287435 & 2 &  24,25 kr &  48,50 kr \\
    \midrule
    USB port (Mini B)            & 1243250 & 2 &  17,89 kr &  35,78 kr \\
    \midrule
    VGA controller               & ??????? & 1 &   0,00 kr &   0,00 kr \\
    \midrule
    VGA port                     & 1056018 & 2 &  91,61 kr & 183,22 kr \\
    \midrule
    Data memory\\ (2M x 8bit)      & 2115432 & 2 & 326,02 kr & 652,04 kr \\
    \midrule
    Program memory\\ (64k x 16bit) & 2115418 & 3 &  19,85 kr &  59,55 kr \\
    \midrule
    VGA memory\\ (512 x 8bit)      & 1688739 & 2 &  57,43 kr & 114,86 kr \\
    \bottomrule
  \end{tabularx}
  \caption{Components}
  \label{fig:components}
\end{table}
