martingms/dmpro2012ytelse/report/fig/pcb/pcb_powersoldered.tex

\begin{figure}[H]
  \centering
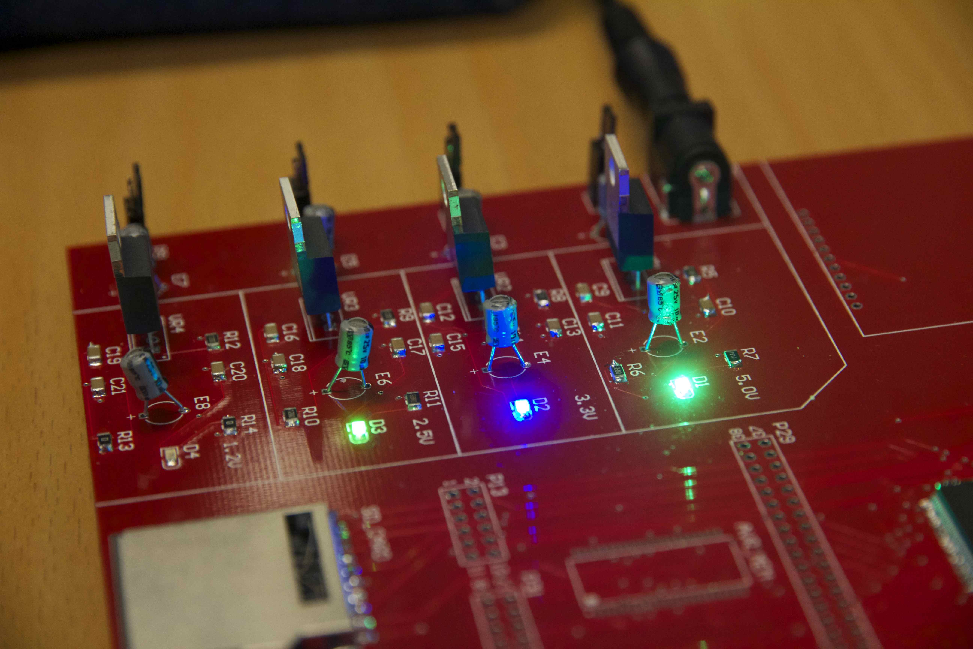
[picture p47: report/fig/pcb/pcb_powersoldered.jpeg]
  
  \caption[The PCB Power Supply]{The PCB with the powersupply soldered.}
  \label{fig:pcb-powersoldered}
\end{figure}
