martingms/dmpro2012ytelse/report/fig/fpga/s-instructions.tex

\begin{table}[h]\small
  \centering
  \begin{tabularx}{\textwidth}{lccX}\toprule
    \thx{name} & \thx{fn} & \thx{assembly code} & \thx{binary representation}
    \\ \midrule
    \thx{swap} & \tt 000 & \tt swap \$rs, \$rt &
    \tt 0 m 001 ssss tttt 0000 ---- 111\\ \bottomrule
  \end{tabularx}
  \caption{List of S instructions}
  \label{tab:s-instructions}
\end{table}
