martingms/dmpro2012ytelse/report/fig/res/lena-benchmark-plot.pdf

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
Idle

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
Frames per Second

Power Consumption (W)

Program

Frames per Second
Power Consumption
