martingms/dmpro2012ytelse/report/ch/sys-test.tex

\chapter{System Testing}\label{ch:sys-test}

\begin{flushright}{\slshape
    If you don’t care about quality, you can meet any other requirement.\\ \medskip
    --- Gerald M. Weinberg}
\end{flushright}

Any system with functional requirements needs to verify whether the functional
requirements are satisfied or not. This is done through system tests, which are
essential to get a confirmation or a rejection of whether we satisfy the
requirements. Usually we will test the functionality of a system as a whole, but
the nature of our requirements means that some of the tests will only test
specific parts of the system.

This chapter will start by presenting the design of the system tests. It will
then go into how we will test the different functional requirements. We
summarize by presenting our results with additional comments.

\input{ch/sys-test/design}
\input{ch/sys-test/proc}
\input{ch/sys-test/result}
