martingms/dmpro2012ytelse/tools/fpga_programs/simd_test_sim.txt

IRAM(0) <= "100000000000000000000000";
IRAM(1) <= "100010001000010010110000";
IRAM(2) <= "100000001000100000000110";
IRAM(3) <= "100000001000100000000110";
IRAM(4) <= "100000001000100000000110";
IRAM(5) <= "100000001000100000000110";
IRAM(6) <= "100000001000100000000110";
IRAM(7) <= "100000001000100000000110";
IRAM(8) <= "100000001000100000000110";
IRAM(9) <= "100000001000100000000110";
IRAM(10) <= "100000001000100000000110";
IRAM(11) <= "100011101000000000000000";
IRAM(12) <= "000010010000000111000000";
IRAM(13) <= "000100010001000000000000";
IRAM(14) <= "100011111000000000000000";
IRAM(15) <= "110000000000000000100000";
IRAM(16) <= "100000000000000000000000";
IRAM(17) <= "100011111000000000001000";
IRAM(18) <= "110000000000000001000000";
IRAM(19) <= "100000000000000000000000";
IRAM(20) <= "100011111000000000100000";
IRAM(21) <= "110000000000000001001000";
IRAM(22) <= "100000000000000000000000";
IRAM(23) <= "100011111000010100000000";
IRAM(24) <= "100001111111100000000110";
IRAM(25) <= "110000000000000001011000";
IRAM(26) <= "100000000000000000000000";
IRAM(27) <= "100010100000010100000000";
IRAM(28) <= "100000100010000000000110";
IRAM(29) <= "100001111000001000000000";
IRAM(30) <= "100001111111101000000000";
IRAM(31) <= "100001111111101000000000";
IRAM(32) <= "100011111111100000001000";
IRAM(33) <= "110000000000000001010000";
IRAM(34) <= "100000000000000000000000";
IRAM(35) <= "110000000000000000001000";
IRAM(36) <= "100000000000000000000000";
IRAM(37) <= "100000000000000000000000";
IRAM(38) <= "100000000000000000000000";
IRAM(39) <= "100000000000000000000000";
IRAM(40) <= "100000000000000000000000";
IRAM(41) <= "100000000000000000000000";
IRAM(42) <= "100000000000000000000000";
IRAM(43) <= "100000000000000000000000";
IRAM(44) <= "100000000000000000000000";
IRAM(45) <= "100000000000000000000000";
IRAM(46) <= "100000000000000000000000";
IRAM(47) <= "100000000000000000000000";
IRAM(48) <= "100000000000000000000000";
IRAM(49) <= "100000000000000000000000";
IRAM(50) <= "100000000000000000000000";
IRAM(51) <= "100000000000000000000000";
IRAM(52) <= "100000000000000000000000";
IRAM(53) <= "100000000000000000000000";
IRAM(54) <= "100000000000000000000000";
IRAM(55) <= "100000000000000000000000";
IRAM(56) <= "100000000000000000000000";
IRAM(57) <= "100000000000000000000000";
IRAM(58) <= "100000000000000000000000";
IRAM(59) <= "100000000000000000000000";
IRAM(60) <= "100000000000000000000000";
IRAM(61) <= "100000000000000000000000";
IRAM(62) <= "100101110110100000000000";
IRAM(63) <= "100000000000000000000000";
IRAM(64) <= "100011101110100000001000";
IRAM(65) <= "101010000000001000101000";
IRAM(66) <= "100000000000111010000010";
IRAM(67) <= "100000000000000000000000";
IRAM(68) <= "101000000000000111110000";
IRAM(69) <= "100000000000000000000000";
IRAM(70) <= "101000000000001000101000";
