martingms/dmpro2012ytelse/report/fig/res/lena-benchmark-plot.tex

\begin{figure}[h!]
\centering

\caption[LENA results]{The LENA results from Table
\ref{tab:lena-benchmark-table}.}
\label{fig:lena-benchmark-plot}
\end{figure}
