martingms/dmpro2012ytelse/tools/test_pattern.png

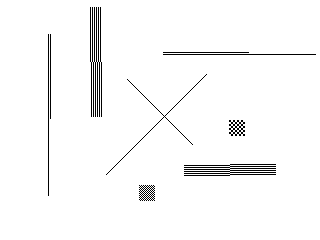
tools/test_pattern.png
