martingms/dmpro2012ytelse/report/fig/pcb/schematics/pcbschematic_avrmem.pdf

# AVR_MEM

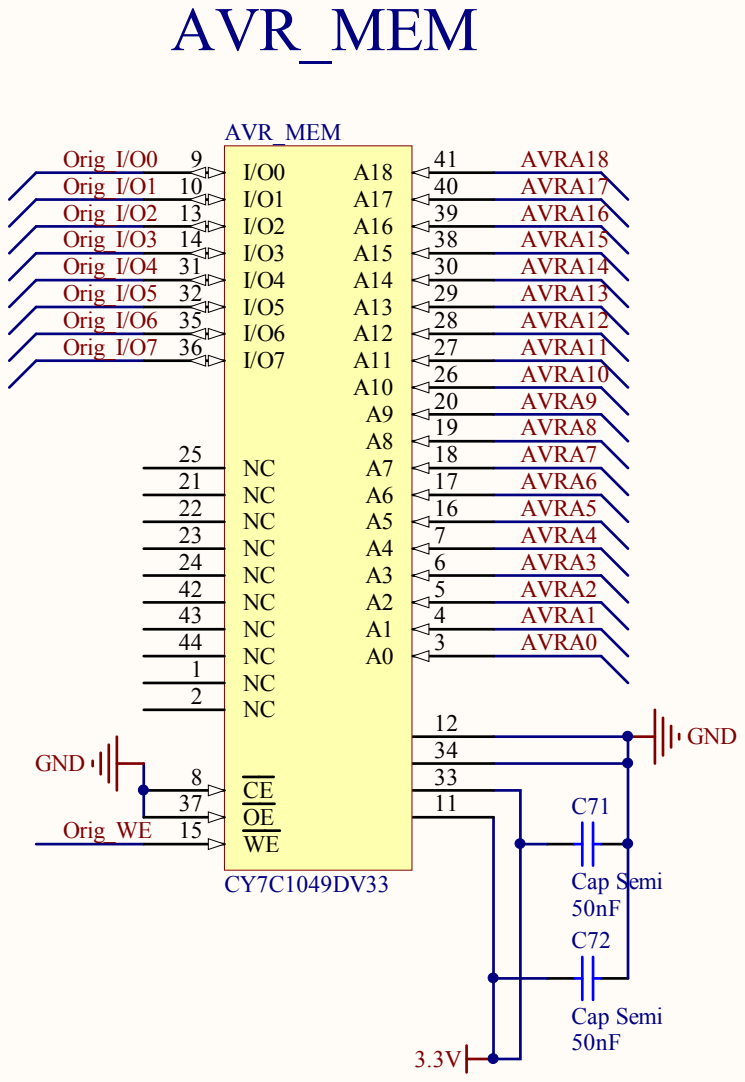
[picture p49: page 1]
Orig_WE; Cap Semi; Vcc; Vss; 33 Vss; AVR_MEM; Orig_I/O0 Orig_I/O1 Orig_I/O2 Orig_I/O3 Orig_I/O4 Orig_I/O5 Orig_I/O6 Orig_I/O7; GND; AVRA0; AVRA1; AVRA2; AVRA3; AVRA4; AVRA5; AVRA6; AVRA7; AVRA8; AVRA9; AVRA10; AVRA11; AVRA12; AVRA13; AVRA14; AVRA15; AVRA16; AVRA17; AVRA18
