martingms/dmpro2012ytelse/report/fig/pcb/schematics/pcbschematic_ledbtn.pdf

# Buttons LED

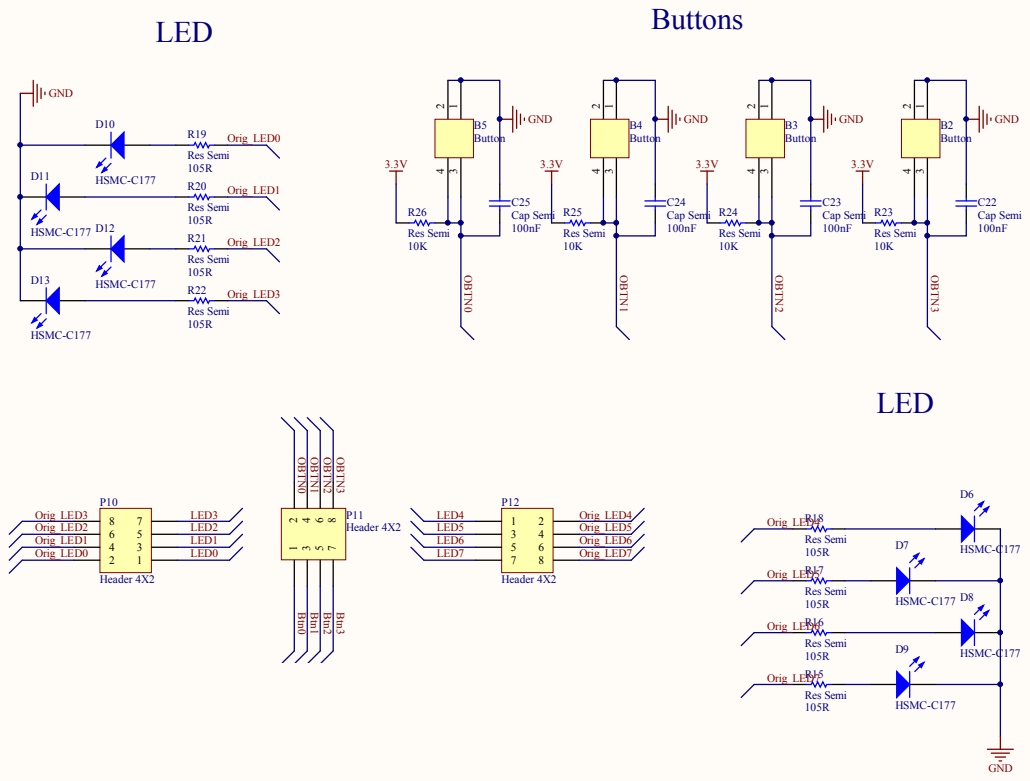
[picture p50: page 1]
