martingms/dmpro2012ytelse/report/fig/pcb/schematics/pcbschematic_powersupply.pdf

# POWER SUPPLY

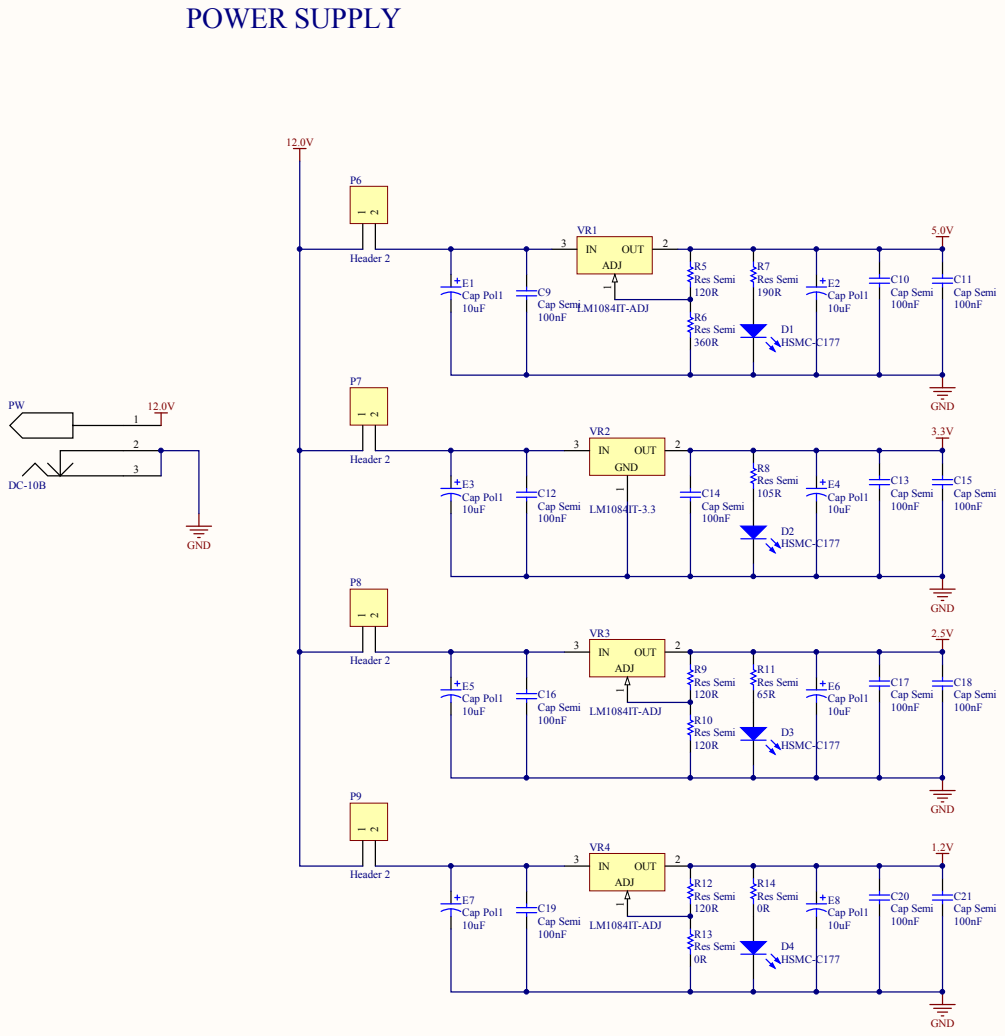
[picture p51: page 1]
