martingms/dmpro2012ytelse/report/fig/pcb/schematics/pcbschematic_serial.pdf

# Seriell

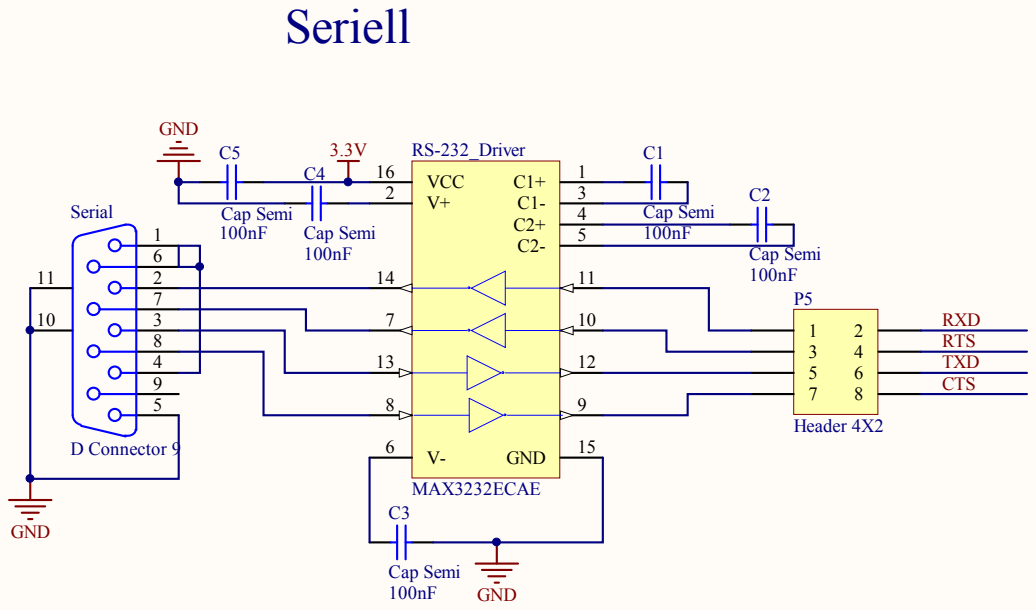
[picture p52: page 1]
Serial; D Connector 9; GND; 3 VCC 16; RS-232_Driver; MAX3232ECAE; Cap Semi; Header 4X2; TXD; RXD RTS; CTS
