martingms/dmpro2012ytelse/report/fig/pcb/schematics/pcbschematic_vgamem.pdf

# VGA_MEM

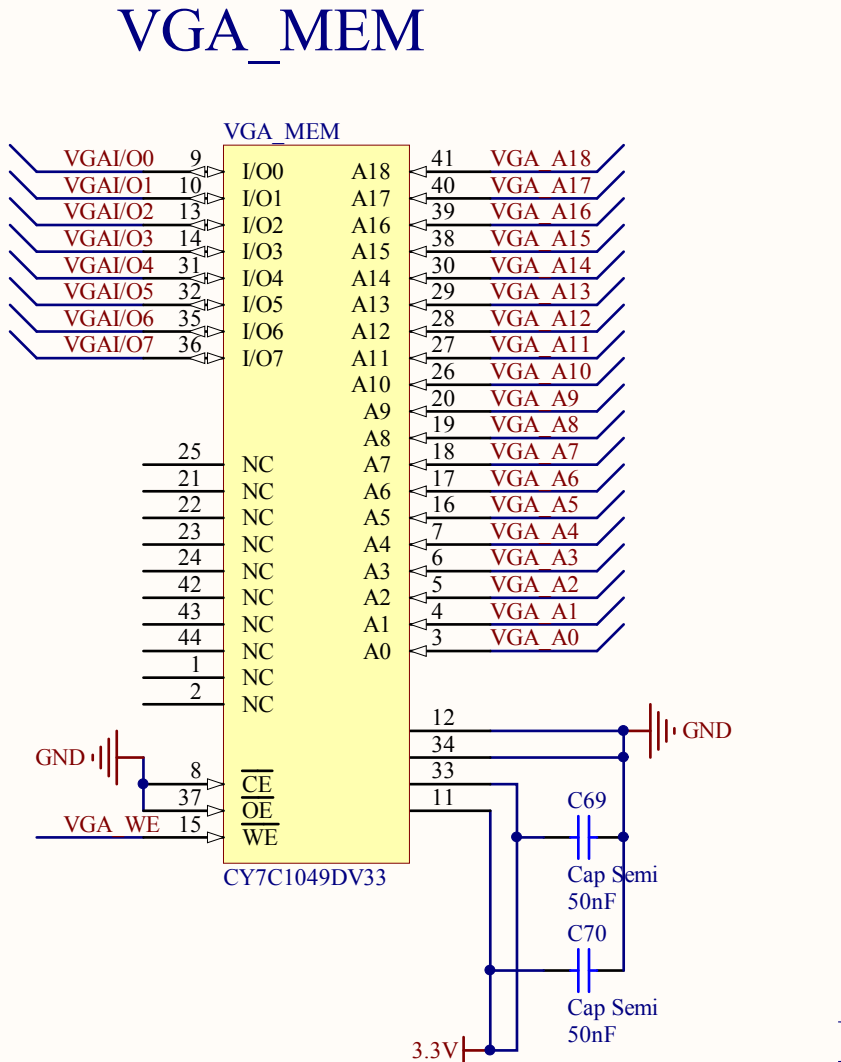
[picture p53: page 1]
GND; VGA_WE; Cap Semi; VGA_A0; VGA_A1; VGA_A2; VGA_A3; VGA_A4; VGA_A5; VGA_A6; VGA_A7; VGA_A8; VGA_A9; VGA_A10; VGA_A11; VGA_A12; VGA_A13; VGA_A14; VGA_A15; VGA_A16; VGA_A17; VGA_A18; Vcc; Vss; 33 Vss; VGA_MEM; VGAI/O0 VGAI/O1 VGAI/O2 VGAI/O3 VGAI/O4 VGAI/O5 VGAI/O6 VGAI/O7
