martingms/dmpro2012ytelse/doc/fpga/fpga_simd_architecture.pdf

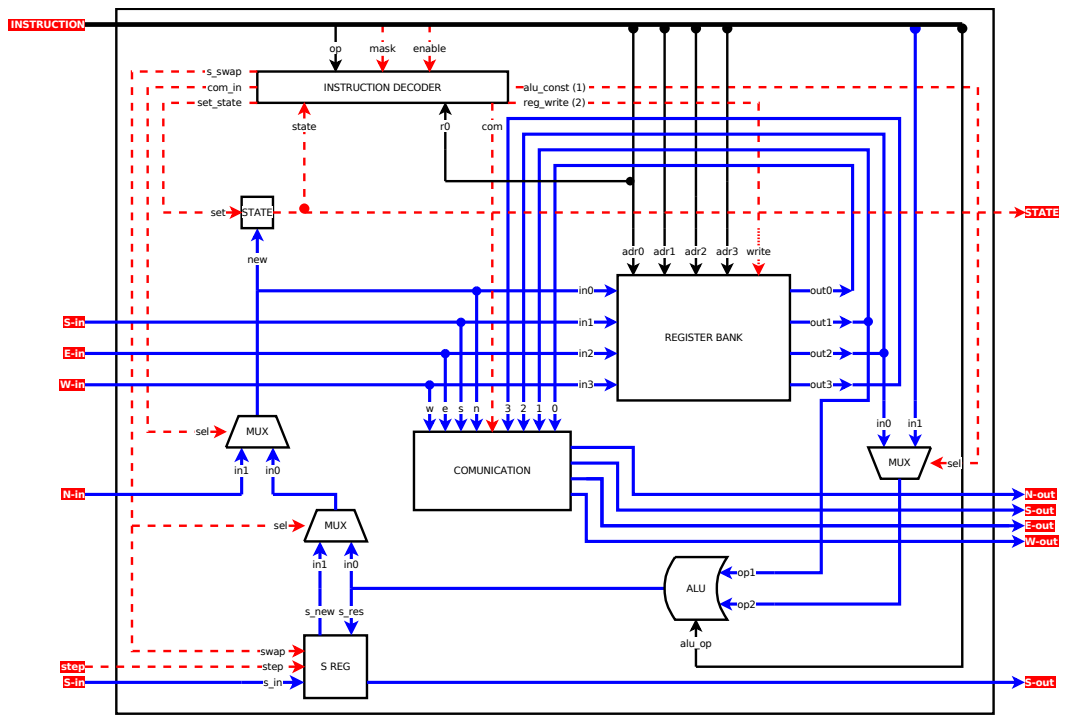
[picture p54: page 1]
REGISTER BANK; COMUNICATION; write; INSTRUCTION DECODER; adr0 adr1 adr2 adr3; S REG; step; s_new s_res; alu_op; sel; INSTRUCTION; swap; out1; out2; mask; enable; MUX; out0; out3; N-out; W-out; E-out; S-out; STATE; new; state; alu_const (1) reg_write (2); com_in; s_swap; com; set; set_state; ALU
