martingms/dmpro2012ytelse/report/fig/fpga/fpga-simd-arch.pdf

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

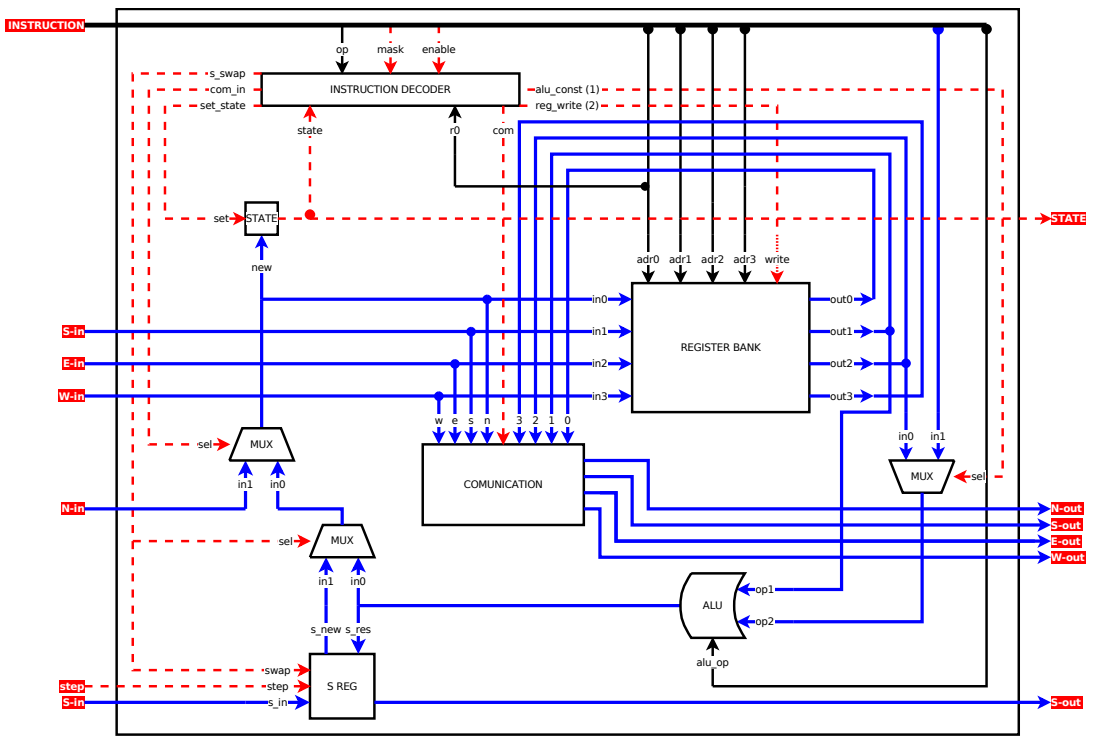
[picture p56: page 1]
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
