martingms/dmpro2012ytelse/report/fig/pcb/power_planes.pdf

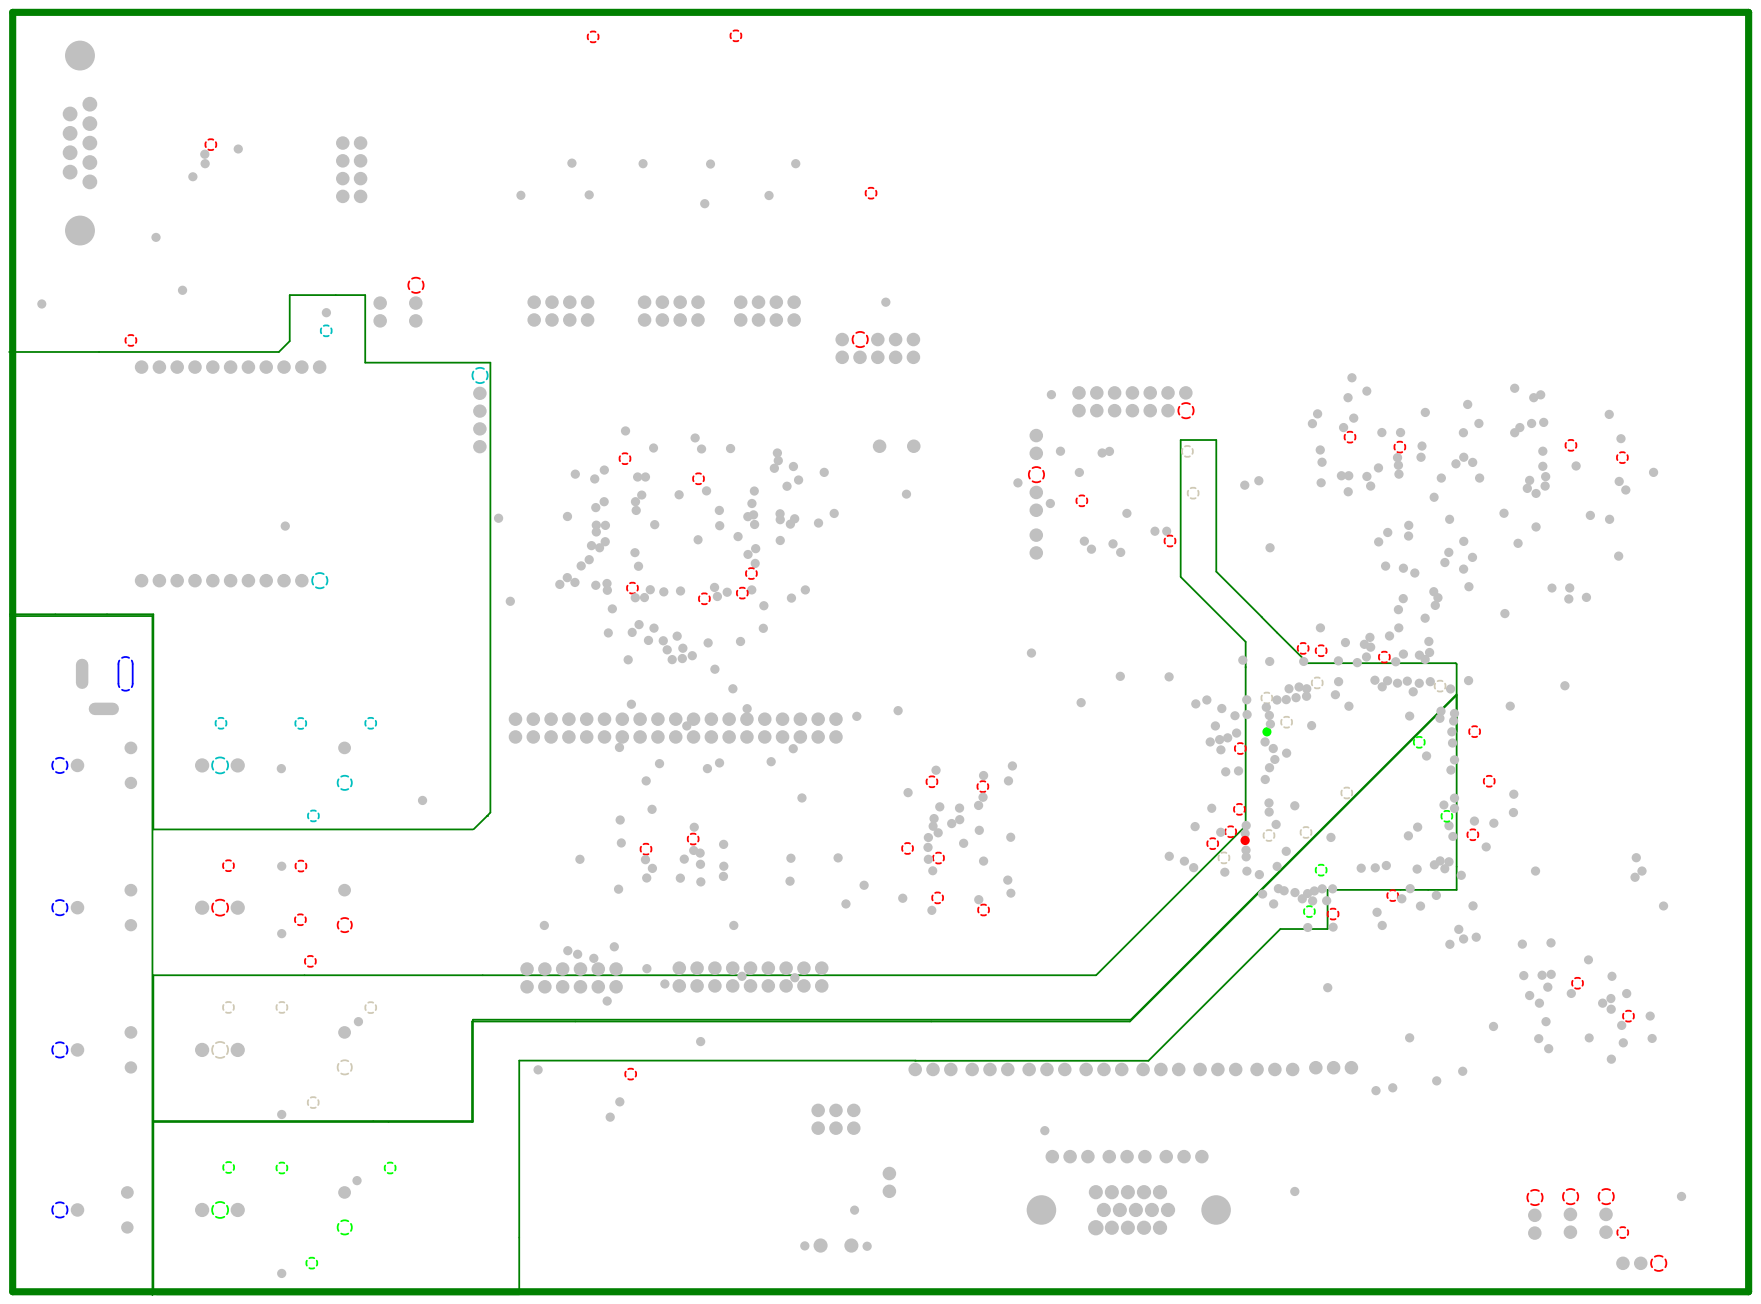
[picture p57: page 1]
