martingms/dmpro2012ytelse/report/fig/pcb/schematics/pcbschematic_avr.pdf

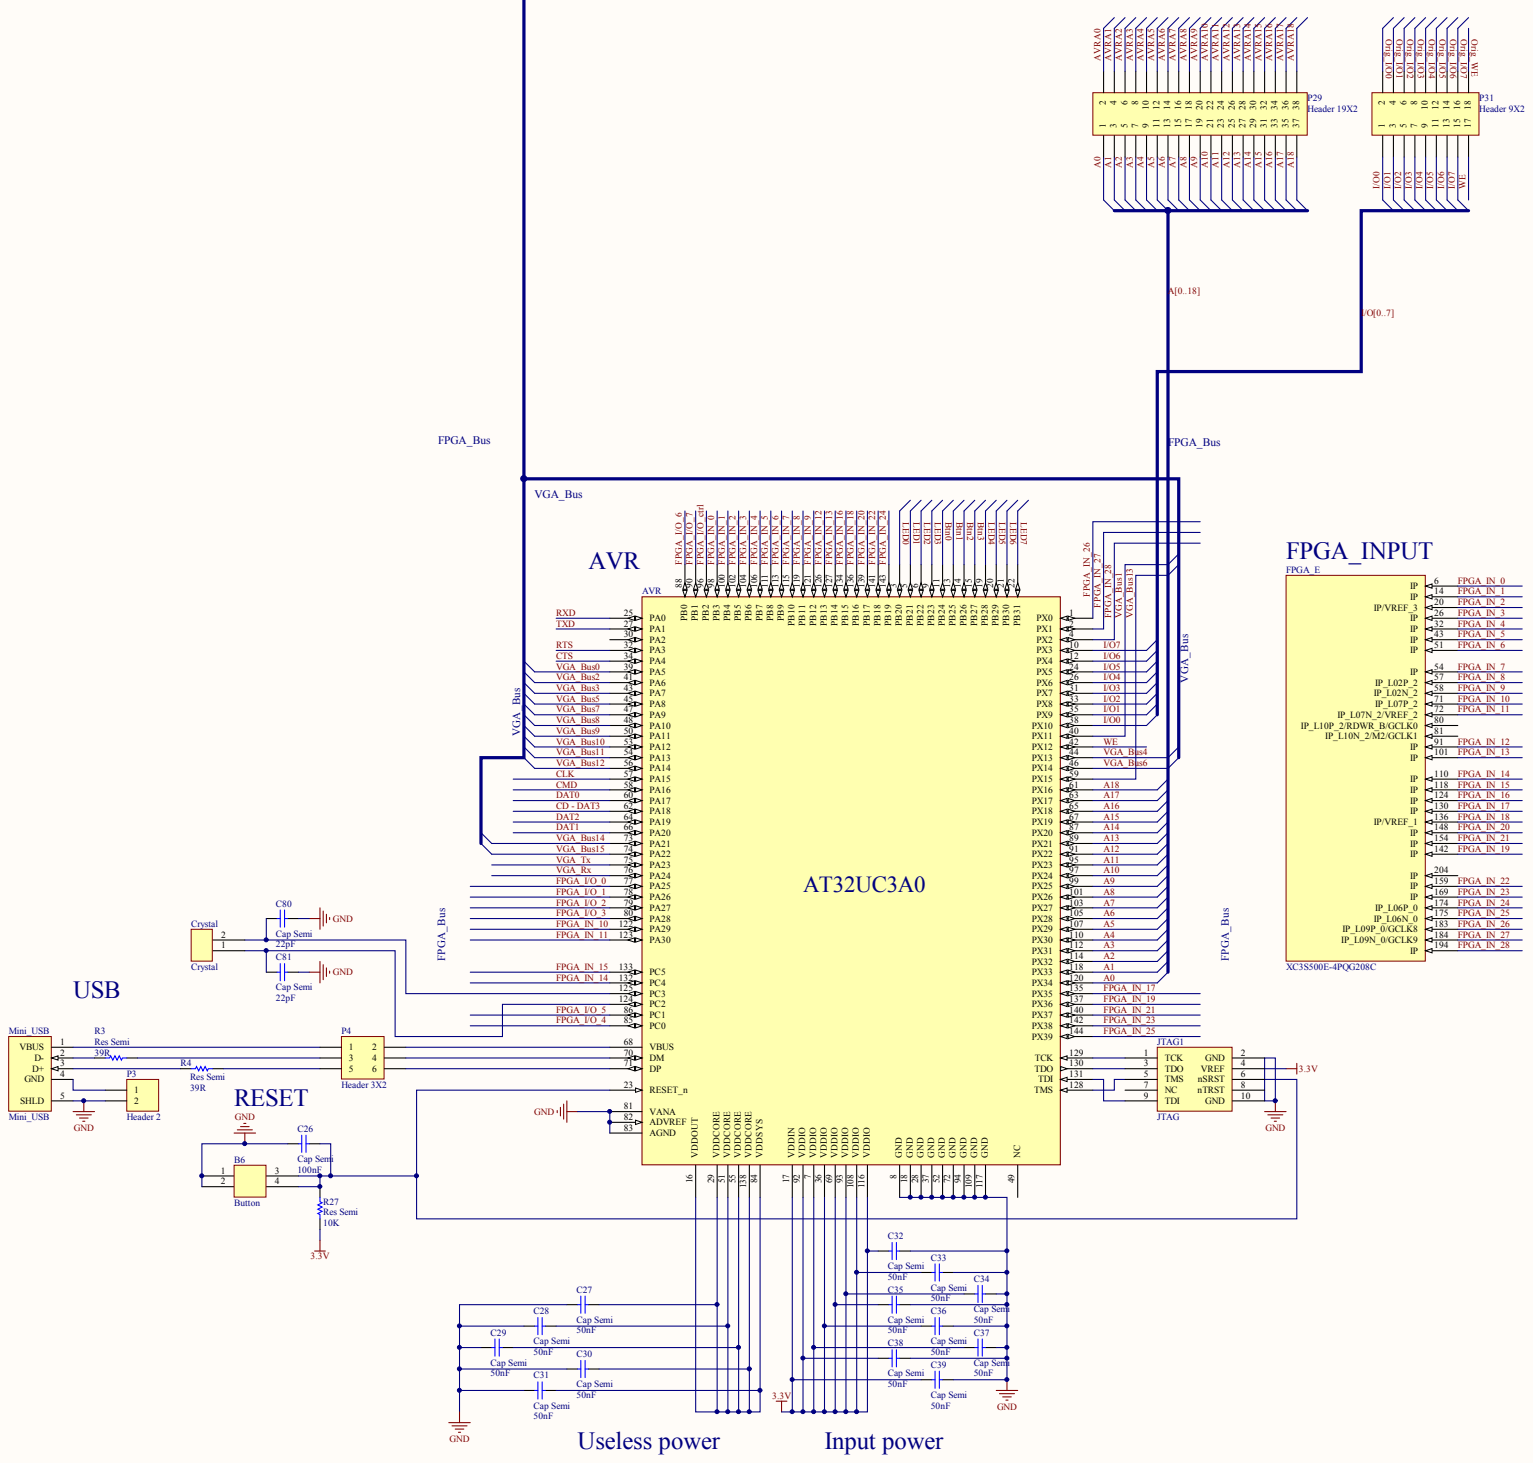
[picture p59: page 1]
