martingms/dmpro2012ytelse/report/fig/pcb/schematics/pcbschematic_fpgab01.pdf

# XC3S500E-4PQG208C BANK ¹

IO_L16N_1/LDC2 | 153 IO_L16P_1/LDC1 | 152 IO_L15N_1/LDC0 | 151 IO_L15P_1/HDC | 150 IO_L14N_1 | 147 IO_L14P_1 | 146 IO_L13N_1 | 145 IO_L13P_1 | 144 IO_L12N_1/A0 | 140 IO_L12P_1 | 139 IO_L11N_1/A1 | 138 IO_L11P_1/A2 | 137 IO_L10N_1/A3/RHCLK7 | 135 IO_L10P_1/A4/RHCLK6 | 134 IO_L09N_1/A5/RHCLK5 | 133 IO_L09P_1/A6/RHCLK4 | 132 IO_L08N_1/A7/RHCLK3 | 129 IO_L08P_1/A8/RHCLK2 | 128 IO_L07N_1/A9/RHCLK1 | 127 IO_L07P_1/A10/RHCLK0 | 126 IO_L06N_1/VREF_1 | 123 IO_L06P_1 | 122 IO_L05N_1/A11 | 120 IO_L05P_1/A12 | 119 IO_L04N_1 | 116 IO_L04P_1 | 115 IO_L03N_1/VREF_1 | 113 IO_L03P_1 | 112 IO_L02N_1/A13 | 109 IO_L02P_1/A14 | 108 IO_L01N_1/A15 | 107 IO_L01P_1/A16 | 106

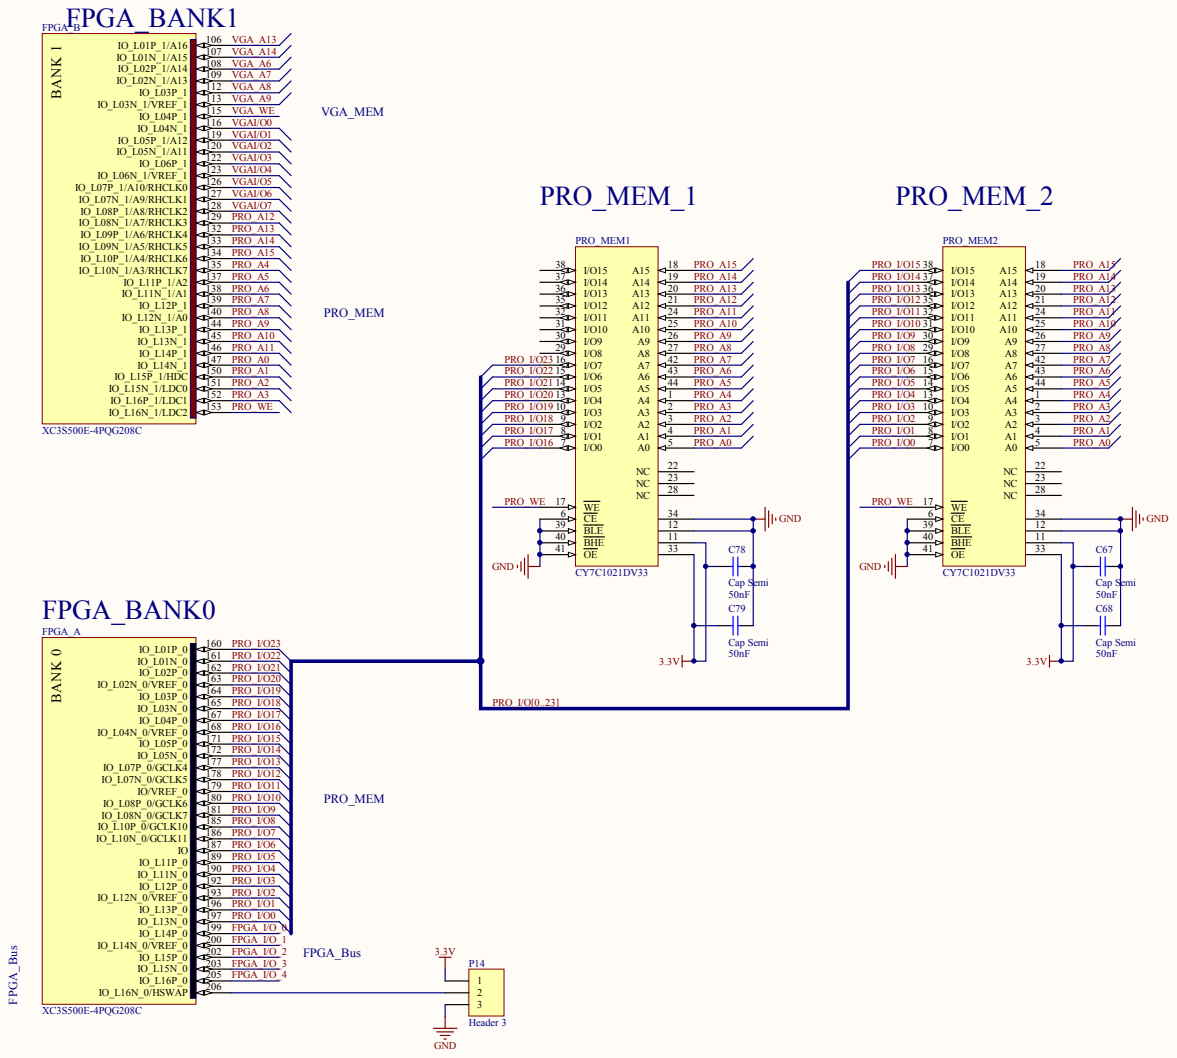
[picture p60: page 1]
BANK 0; IO_L16N_0/HSWAP; 202 IO_L14N_0/VREF_0; 196 IO_L12N_0/VREF_0; 187 IO_L10N_0/GCLK11; 186 IO_L10P_0/GCLK10; 185 IO_L08N_0/GCLK7; 181 IO_L08P_0/GCLK6; 180 IO/VREF_0; 179 IO_L07N_0/GCLK5; 178 IO_L07P_0/GCLK4; 171 IO_L04N_0/VREF_0; 164 IO_L02N_0/VREF_0; FPGA_A; FPGA_B; XC3S500E-4PQG208C; FPGA_BANK0; Vcc; 11 Vss; Vss; BLE 39 BHE 40 OE 41; PRO_MEM2; PRO_MEM_2; Header 3; GND; Cap Semi; PRO_MEM1; PRO_MEM_1; PRO_WE; FPGA_BANK1; VGA_A6 VGA_A7 VGA_A8 VGA_A9; VGA_A13 VGA_A14; VGA_WE; PRO_A0; PRO_A1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
