martingms/dmpro2012ytelse/report/fig/pcb/schematics/pcbschematic_fpgab3.pdf

IO_L16N_3 | 50 IO_L16P_3 | 49 IO_L15N_3 | 48 IO_L15P_3 | 47 IO/VREF_3 | 45 IO_L14N_3 | 42 IO_L14P_3 | 41 IO_L13N_3 | 40 IO_L13P_3 | 39 IO_L12N_3 | 36 IO_L12P_3 | 35 IO_L11N_3 | 34 IO_L11P_3 | 33 IO_L10N_3/LHCLK7 | 31 IO_L10P_3/LHCLK6 | 30 IO_L09N_3/LHCLK5 | 29 IO_L09P_3/LHCLK4 | 28 IO_L08N_3/LHCLK3 | 25 IO_L08P_3/LHCLK2 | 24 IO_L07N_3/LHCLK1 | 23 IO_L07P_3/LHCLK0 | 22 IO_L06N_3 | 19 IO_L06P_3 | 18 IO_L05N_3 | 16 IO_L05P_3 | 15 IO_L04N_3 | 12 IO_L04P_3 | 11 IO_L03N_3 | 9 IO_L03P_3 | 8 IO_L02N_3/VREF_3 | 5 IO_L02P_3 | 4 IO_L01N_3 | 3 IO_L01P_3 | 2

# DATA_MEM

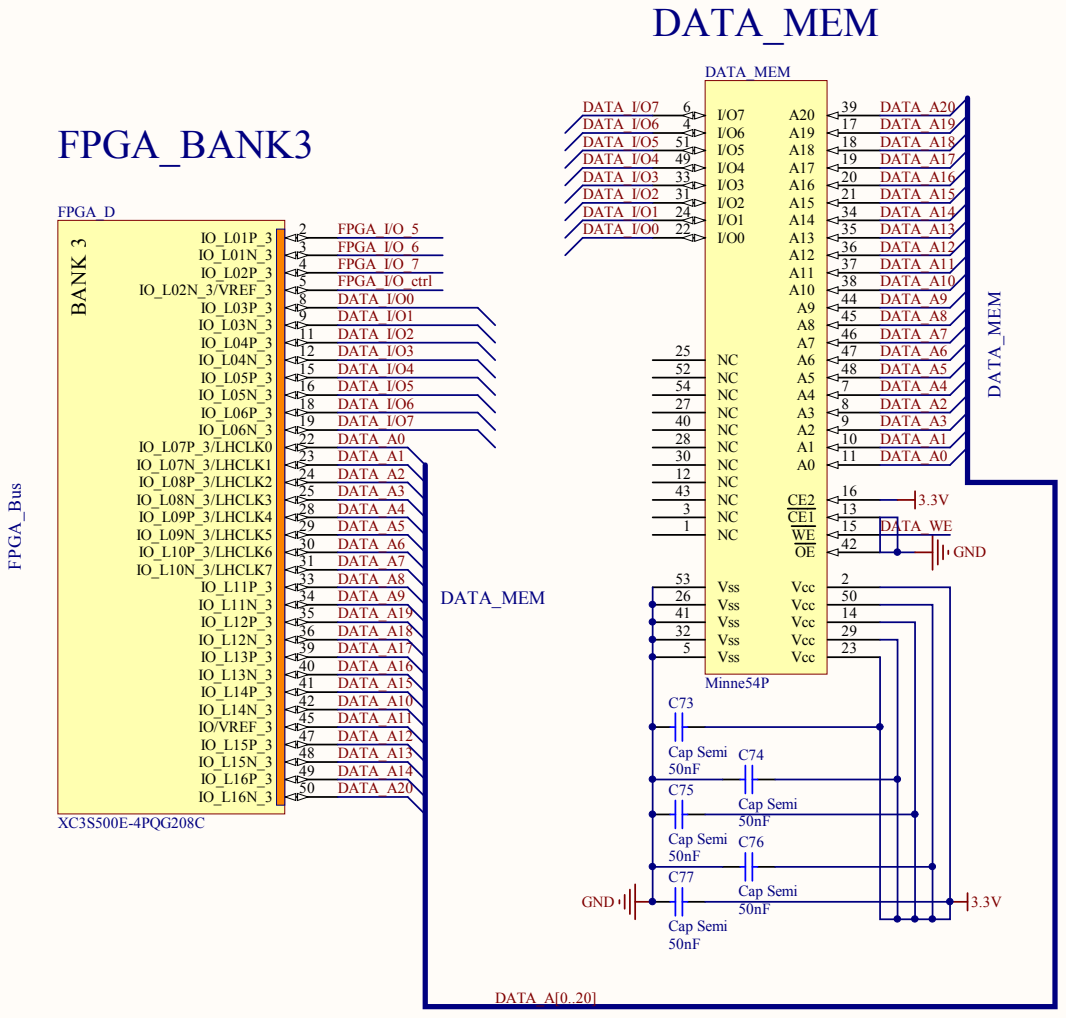
[picture p61: page 1]
BANK 3; FPGA_D; XC3S500E-4PQG208C; Vcc; Vss 5; Vss 26; Vss 32; Vss 41; Vss 53; DATA_MEM; Minne54P; GND; DATA_WE; Cap Semi; FPGA_BANK3; DATA_A0; DATA_A1; DATA_A2 DATA_A3; DATA_A4; DATA_A5; DATA_A6; DATA_A7; DATA_A8; DATA_A9; DATA_A10; DATA_A11; DATA_A12; DATA_A13; DATA_A14; DATA_A15; DATA_A16; DATA_A17; DATA_A18; DATA_A19; DATA_A20; DATA_I/O0; DATA_I/O1; DATA_I/O2; DATA_I/O3; DATA_I/O4; DATA_I/O5; DATA_I/O6; DATA_I/O7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
