martingms/dmpro2012ytelse/report/fig/pcb/schematics/pcbschematic_fpgapower.pdf

FPGA_POWER | FPGA_GND

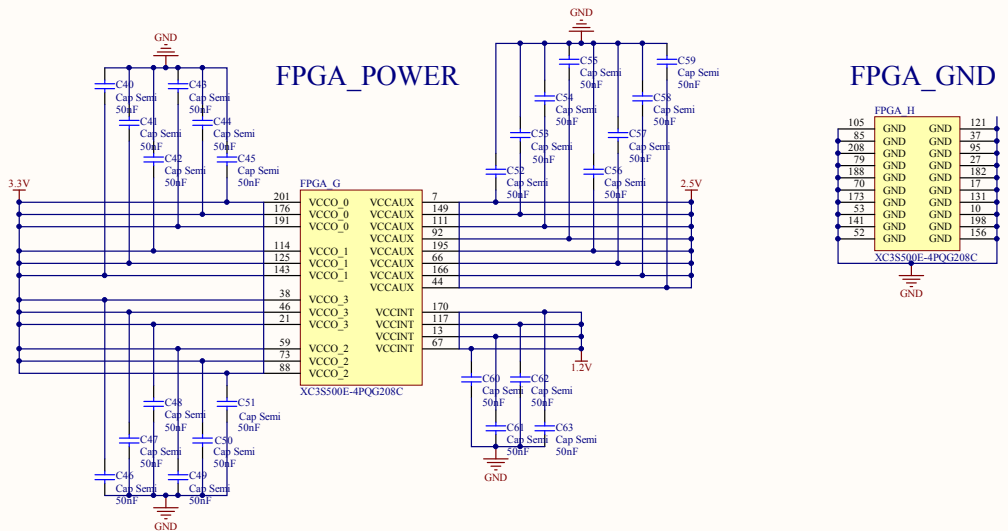
[picture p62: page 1]
