martingms/dmpro2012ytelse/report/fig/pcb/schematics/pcbschematic_jtagflash.pdf

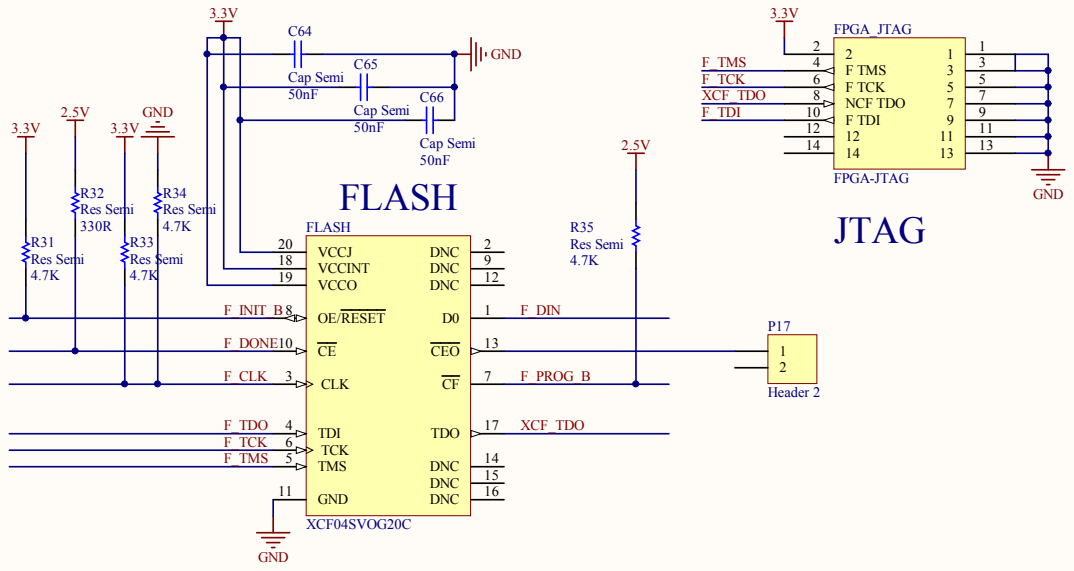
[picture p63: page 1]
