martingms/dmpro2012ytelse/report/fig/pcb/schematics/pcbschematic_vgacontroller.pdf

IO_L17N_2/CCLK | 103 IO_L17P_2/VS0/A17 | 102 IO_L16N_2/VS1/A18 | 100 IO_L16P_2/VS2/A19 | 99 IO/VREF_2 | 98 IO_L15N_2/A20 | 97 IO_L15P_2/A21 | 96 IO_L14N_2/A22 | 94 IO_L14P_2/A23 | 93 IO_L13N_2 | 90 IO_L13P_2 | 89 IO_L12N_2/DIN/D0 | 87 IO_L12P_2/M0 | 86 IO/M1 | 84 IO_L11N_2/D1/GCLK3 | 83 IO_L11P_2/D2/GCLK2 | 82 IO_L09N_2/D3/GCLK15 | 78 IO_L09P_2/D4/GCLK14 | 77 IO/D5 | 76 IO_L08N_2/D6/GCLK13 | 75 IO_L08P_2/D7/GCLK12 | 74 IO_L06N_2 | 69 IO_L06P_2 | 68 IO_L05N_2 | 65 IO_L05P_2 | 64 IO_L04N_2 | 63 IO_L04P_2 | 62 IO_L03N_2/MOSI/CSI_B | 61 IO_L03P_2/DOUT/BUSY | 60 IO_L01N_2/INIT_B | 56 IO_L01P_2/CSO_B | 55

# VGA

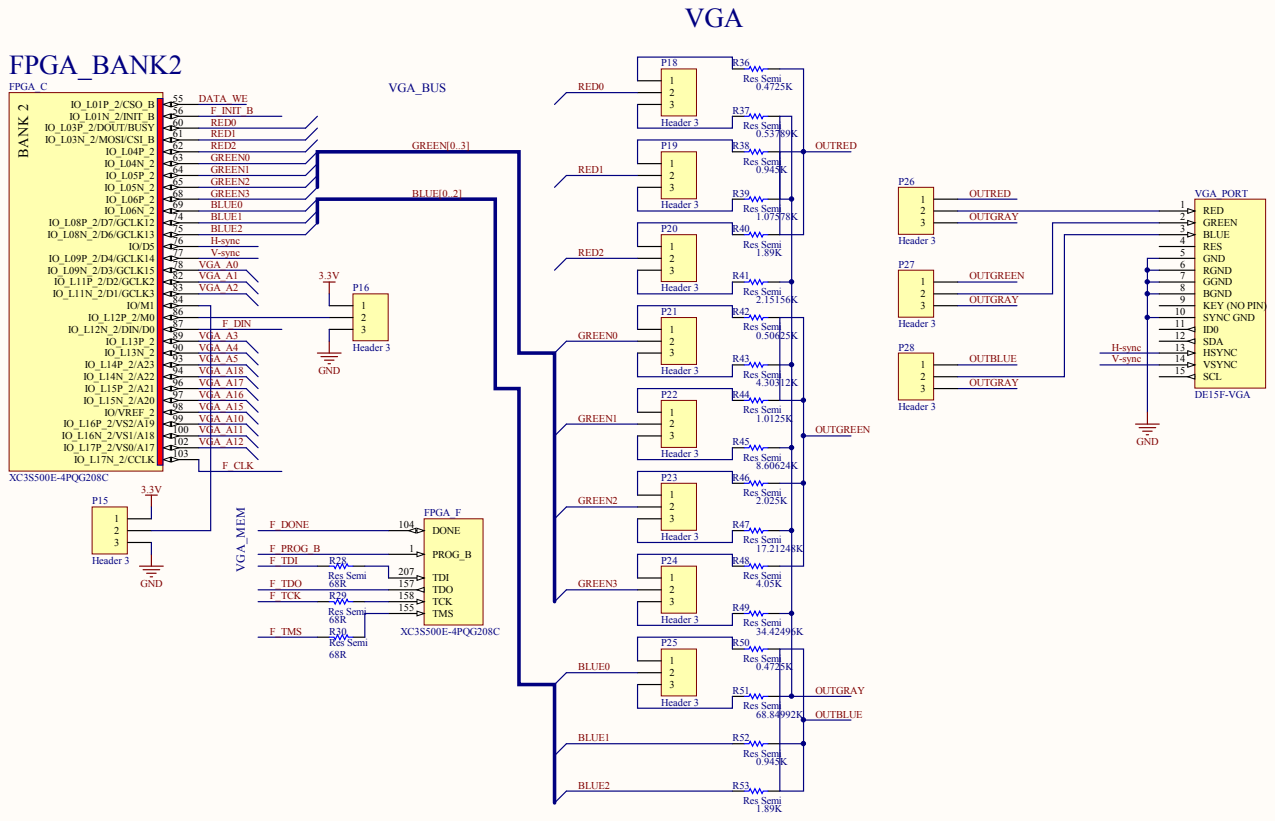
[picture p64: page 1]
