martingms/dmpro2012ytelse/report/fig/pcb/schematics/pcbschematic_vgamodule.pdf

10K

R2

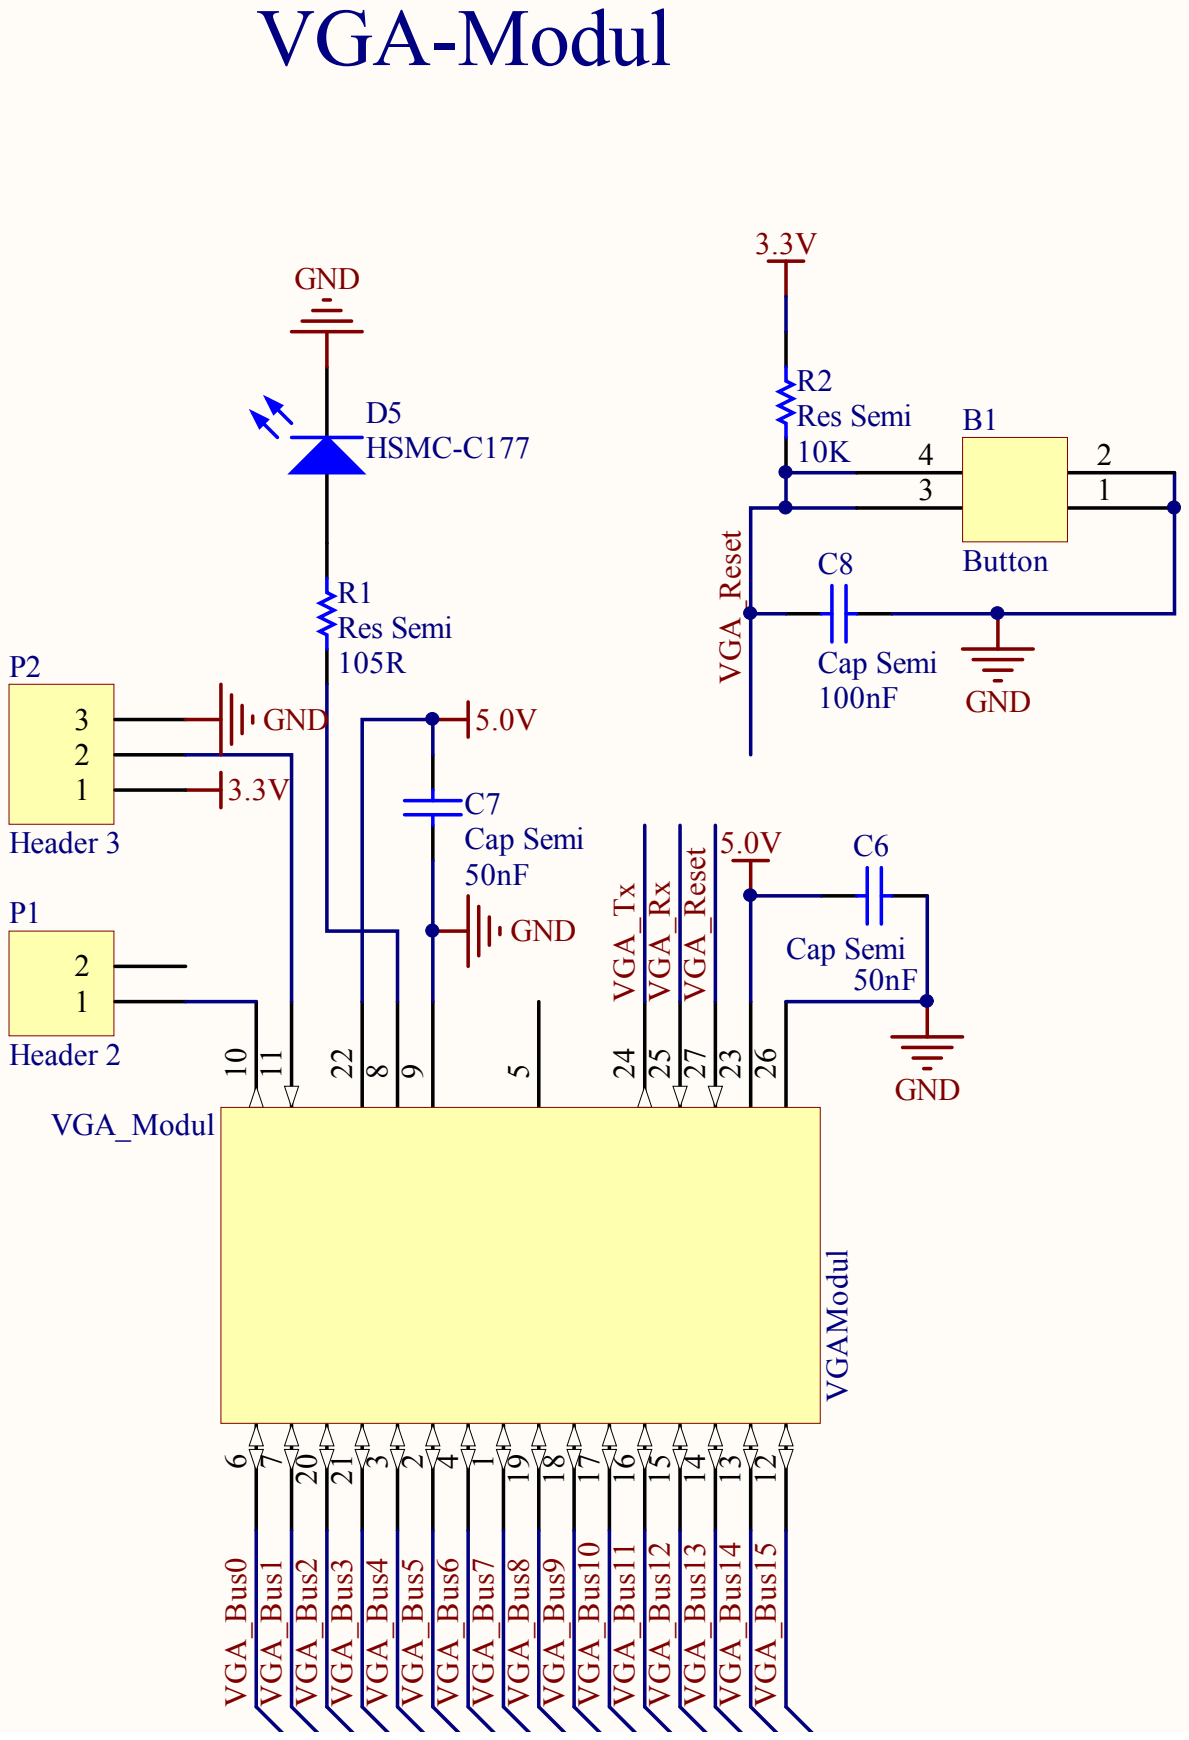
[picture p65: page 1]
