martingms/dmpro2012ytelse/report/fig/pcb/schematics/pcbschematic.pdf

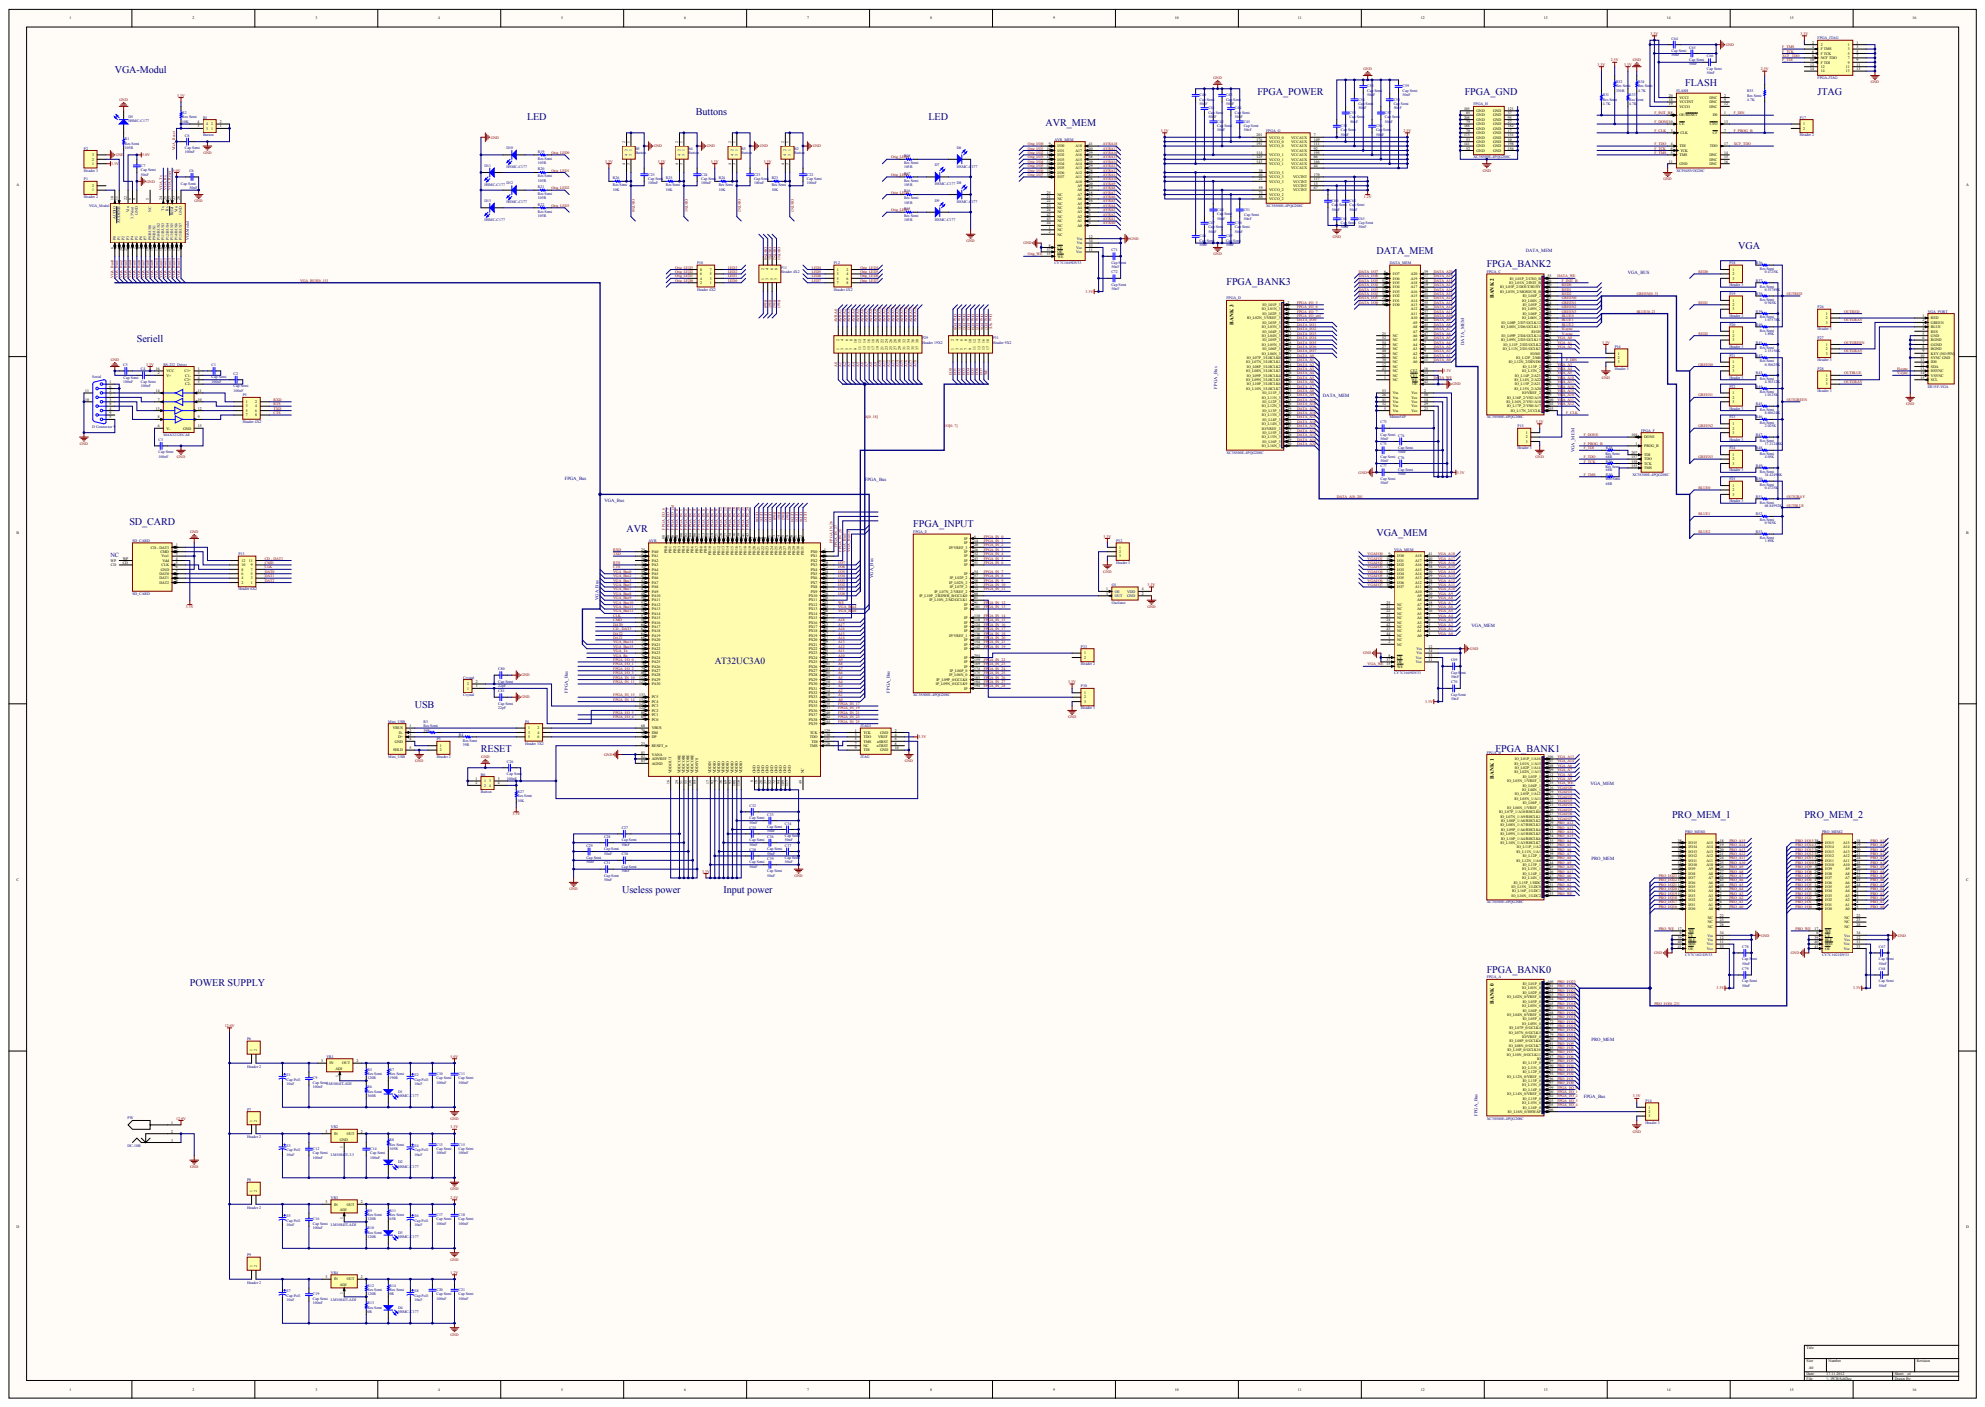
[picture p66: page 1]

50nF C35 Cap Semi C34

100nF LM1084IT-ADJ R10 Res Semi 120R | D3 HSMC-C177 | 10uF
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
