martingms/dmpro2012ytelse/(list of files, drawings)

Other design files:
pcb/altium/256 - Copy.PcbDoc
pcb/altium/256.PcbDoc
pcb/altium/dmpro-yesteryear/LED.PcbLib
pcb/altium/dmpro-yesteryear/PowerIn.PcbLib
pcb/altium/dmpro-yesteryear/Project Outputs for FestinaLente/FestinaLente/Button.PcbLib
pcb/altium/dmpro-yesteryear/Project Outputs for FestinaLente/FestinaLente/Button.SchLib
pcb/altium/dmpro-yesteryear/Project Outputs for FestinaLente/FestinaLente/Crystal.PcbLib
pcb/altium/dmpro-yesteryear/Project Outputs for FestinaLente/FestinaLente/Crystal.SchLib
pcb/altium/dmpro-yesteryear/Project Outputs for FestinaLente/FestinaLente/Molex.PcbLib
pcb/altium/dmpro-yesteryear/Project Outputs for FestinaLente/FestinaLente/Molex.SchLib
pcb/altium/dmpro-yesteryear/Project Outputs for FestinaLente/FestinaLente/Oscilator.PcbLib
pcb/altium/dmpro-yesteryear/Project Outputs for FestinaLente/FestinaLente/Oscilator.SchLib
pcb/altium/dmpro-yesteryear/Project Outputs for FestinaLente/FestinaLente/PowerConnector.PcbLib
pcb/altium/dmpro-yesteryear/Project Outputs for FestinaLente/FestinaLente/PowerIn.SchLib
pcb/altium/JTAG/FPGA-JTAG.SchLib
pcb/altium/JTAG/JTAG.SchLib
pcb/altium/More_or_less_old_PCB.SchDoc
pcb/altium/New_PCB.SchDoc
pcb/altium/PCB.SchDoc
pcb/altium/Project/256sog -3_10.PcbDoc
pcb/altium/Project/256sog - Copy.PcbDoc
pcb/altium/Project/256sog.PcbDoc
pcb/altium/Project/Lenna.PcbDoc
pcb/altium/Project/LennaThicker.PcbDoc
pcb/altium/Project/PCB.PrjPcb
pcb/altium/SD_CARD/SD_CARD.PcbLib
pcb/altium/SD_CARD/SD_CARD.SchLib
pcb/altium/Sheet1.SchDoc
pcb/altium/TSOP/CY7C1021DV33.SchLib
pcb/altium/TSOP/CY7C1049DV33.SchLib
pcb/altium/TSOP/CY7C1069DV33.SchLib
pcb/altium/TSOP/MemChip.SchLib
pcb/altium/TSOP/Project Outputs for MemoryChips/MemoryChips/CY7C1021DV33.SchLib
pcb/altium/TSOP/Project Outputs for MemoryChips/MemoryChips/CY7C1049DV33.SchLib
pcb/altium/TSOP/Project Outputs for MemoryChips/MemoryChips/CY7C1069DV33.SchLib
pcb/altium/TSOP/Project Outputs for MemoryChips/MemoryChips/TSOP.PcbLib
pcb/altium/TSOP/TSOP.PcbLib
pcb/altium/VGA/Project Outputs for VGAcomponents/VGAcomponents/VGAModul.PcbLib
pcb/altium/VGA/Project Outputs for VGAcomponents/VGAcomponents/VGAModul.SchLib
pcb/altium/VGA/Project Outputs for VGAcomponents/VGAcomponents/VGAPlugg.PcbLib
pcb/altium/VGA/Project Outputs for VGAcomponents/VGAcomponents/VGAplugg.SchLib
pcb/altium/VGA/VGAModul.PcbLib
pcb/altium/VGA/VGAModul.SchLib
pcb/altium/VGA/VGAPlugg.PcbLib
pcb/altium/VGA/VGAplugg.SchLib
