martingms/dmpro2012ytelse/(commit log)

2012-09-19 REPORT: Create initial TEX-file, and add in some of the ordered PCB-components
2012-09-19 first test project for avr32 test board, evk1100
2012-09-19 decided to avoid eclipse, deleted lots of avr code
    [led.c]
2012-09-22 Add basic TSOP54/TSOP44/MemChip-configurations
    [MemChip.SchLib, TSOP.PcbLib]
2012-09-22 Add the other memory chip-thing
    [CY7C1021DV33.SchLib, MemChip.SchLib]
2012-09-23 MEMORY: Update footprints and schematics for all 3 types of memory
    [CY7C1021DV33.SchLib, CY7C1049DV33.SchLib, CY7C1069DV33.SchLib, MemChip.SchLib]
2012-09-23 MEMORY: Remove old file
    [MemChip.SchLib]
2012-09-25 Added in usefull schematics and footprints from Festina Lente
    [Button.PcbLib, Button.SchLib, LED.PcbLib, Molex.PcbLib, Molex.SchLib, PowerConnector.PcbLib, PowerIn.PcbLib, PowerIn.SchLib]
2012-09-26 Added PCB screenshots
2012-10-03 Revised SIMD node data flow
2012-10-05 int->U8 fix + documentation
    [button.c, button.h]
2012-10-06 Added missing control signals to FPGA SIMD node architecture schematic
2012-10-07 PCB: Add almost complete PCB-files to repos
    [256sog.PcbDoc, Button.PcbLib, Button.SchLib, CY7C1021DV33.SchLib, CY7C1049DV33.SchLib, CY7C1069DV33.SchLib, Crystal.PcbLib, Crystal.SchLib]
2012-10-09 Started implementing DMA in FPGA simulator
2012-10-13 fixed some bad code
    [bus.c, bus.h, fpga.c]
2012-10-14 Started writing VHDL for DMA module. Don't know if this code is reasonable in any way yet
2012-10-15 added missing singal to simd node schematic
2012-10-15 added support for sram added seprintf for having a direct printf instead of needing to write two function calls added assert.h containing macros for making assertions about variables for easier debug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
2012-10-15 see previous commit, some files didn't come along.
    [assert.h, conf_access.h, conf_explorer.h, conf_sd_mmc_spi.h, sdramc.c, sdramc.h]
2012-10-15 bus test, fpga interrupt, shades_of_gray.h
2012-10-16 Continued playing monkey on a typewriter in the DMA VHDL code
2012-10-17 more work on sram wrote a method to read file sof any length (fat16 would only read about 12kb on every call corrected assert.h (would miss serial.h previously)
    [assert.h]
2012-10-17 Assertion violations now also print out the expression that failed
    [assert.h]
2012-10-17 corrected a lot of seprintf calls in main
    [main.c]
2012-10-17 interrupt conflict fixed, fpga file input change
    [bus.c, button.c, fpga.c, fpga.h, main.c, test_bus.c]
2012-10-17 Made the DMA code actually synthesize
2012-10-19 Don't wait for rising clock to update DMA signals, but rather the state
2012-10-19 Added testbench for DMA, reading a slice from an image of Lenna
2012-10-23 fixed various syntax errors in FPGA NODE
    [instruction_decoder.vhd, node.vhd]
2012-10-25 Added missing FPGA SIMD node files
    [COM.vhd, STATE.vhd]
2012-10-26 Byttet board-fil
2012-10-26 Fixed DMA writing
2012-10-26 REPORT: Add a skeleton for the PCB-chapter of the report
2012-10-27 Added disposition for PCB
    Structural disposition of PCB part of report
2012-10-27 Files for PCB
    [256 - Copy.PcbDoc, 256.PcbDoc, 256sog - Copy.PcbDoc, 256sog -3_10.PcbDoc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]
2012-10-27 Cleanup of files for PCB
    [PCB.~(253).SchDoc, PCB.~(254).SchDoc]
2012-10-28 fixed LED-mapping (4 first LEDs), fixed LED_On / LED_Off
    [bus.c, fpga.c, led.c, main.c, shades_of_gray.h]
2012-10-29 REPORT: Exorcise windows-line-endings from pcb.tex AND create section-files for the PCB-report (Yes, this is a two-in-one commit :)
2012-10-29 REPORT: Stub out the power-supply section of the PCB
2012-10-29 REPORT: Flesh out the Footprints-section of the PCB some more
2012-10-29 REPORT: Flesh out the schematics-part of the PCB-report a bit
2012-10-29 REPORT: Explain a bit more about paralellism in the PCB-workflow
2012-10-29 REPORT: Add some more information to the Footprint-section.
    In effect, this adds datasheet-references for most of the components,
    the hyperlinks probably shouldn't be here, but in some BibTex-thinga-ma-jingie,
    but that'll be fixed when the section is done.
    Also, this marks most of the TODO things here as TODOs
2012-10-29 REPORT: Add a TODO to the workarounds section for the PCB
2012-10-29 REPORT: Stub a Macaos-guide for the PCB-section.
2012-10-29 REPORT: Remind myself to mention the 1206-resistors/capacitors
2012-10-29 REPORT: Add some overall design choices to the PCB-chapter
2012-10-29 REPORT: Flesh out a bit about the power planes
2012-10-29 REPORT: Move "The PCB" to it's own .tex-file
2012-10-29 REPORT: Add some details about the missed pin when reordering for physical proximity
2012-10-30 Made report oneside.
    Will still be prepared as a twoside, in case someone wants a printed
    copy.
2012-10-30 PCB: Remove history from the PCB-project-files
2012-10-30 REPORT: Add newlines to PCB-report
2012-10-30 REPORT: Correct some information in the footprints-section
2012-10-30 REPORT: Add in a preliminary PDF-export of the PCB-schematic
    Right now it's in the wrong folder (ch/pcb), this should eventually
    go into the Appendix, but it's kept here until we clean up the comments
    in the Schematic
2012-10-30 REPORT: Add some more talk about single-doc vs multi-doc to the Schematic section for the PCB
2012-10-30 REPORT: Mention the IPC Footprint Wizard
2012-10-30 tilpasset for knapper + compile error
    [button.c, main.c, shades_of_gray.h]
2012-10-30 working SD-card on our own board \o/
2012-10-31 REPORT: Update PCB-schematic.pdf
2012-10-31 REPORT: Add PCB-schematic.svg
2012-10-31 report: Added new images (Power planes, hole image and routing picture)
2012-10-31 implemented the filebrowser iterator deleted timer.c and timer.h because they caused bizzare compilation errors.
    [main.c]
2012-10-31 started on fpga simd node array
    [node_timesim.sdf]
2012-11-02 Created VHDL toplevel mapping all IO pins correctly
    [toplevel.vhd]
2012-11-02 Fixed memory accesses from the VGA controller
    [memctrl.vhd, toplevel.vhd]
2012-11-04 Correctly show Lenna on screen served from the data RAM
    [memctrl.vhd, toplevel.vhd]
2012-11-04 Align the fetched pixels to the current screen position correctly
    [pixelpusher.vhd]
2012-11-04 Temporary fix of buggy memory pin
    [toplevel.vhd]
2012-11-05 screen display error message + cleanups
    [fpga.c, program_select.c, screen.c, screen.h, script.c]
2012-11-06 REPORT: Remove umlaut-mistake in schematic.tex
2012-11-06 FPGA SIMD array cont
    [node_timesim.sdf]
2012-11-06 REPORT: Add a TODO to powerplanes
2012-11-06 REPORT: Expand section on The PCB
2012-11-06 REPORT: Clean up some formatting in the footprints-section
2012-11-06 REPORT: Add a bit about board-scaling
2012-11-06 REPORT: Remove the disposition from the actual PCB-report
2012-11-06 REPORT: Mark the datasheet-TODO as done for footprints
2012-11-06 JNSpell on PCB part.
2012-11-07 Fix clock and mem_write_enable-mapping.
    [clock.vhd, test_image_loader.vhd, toplevel.vhd]
2012-11-08 FPGA instruction assembler; LENA
2012-11-08 cleaned up the fpga assembler
2012-11-08 added support for assembling swap instructions
2012-11-08 Added support for assembling FPGA program text file to FPGA program binary file
2012-11-08 Make assembler executable
2012-11-09 Added a reset flag from the state register
    [state_register.vhd, test_image_loader.vhd]
2012-11-09 Mapped reset signal to toplevel components
    [data_loader.vhd, instruction_register.vhd, program_loader.vhd, state_register.vhd, toplevel.vhd]
2012-11-09 Properly reset the address in the data/program loaders
    [data_loader.vhd, program_loader.vhd, tb_data_loader.vhd]
2012-11-09 Added DMA to toplevel and MUX-ed data RAM with an active signal from the DMA
2012-11-09 New version of FPGA assembler with support for all SIMD NODE instructions. Sample program is provided.
2012-11-09 assembler can now write true binary program file
2012-11-09 Started adding a reset flag to the DMA controller
    [dma.vhd]
2012-11-09 re-ordered AVR<->FPGA pin definitions
2012-11-09 Print progress in images_to_binary.py
2012-11-11 began fixing stuff after trying the board...
    [bus.c, bus.h, button.c, button.h, fpga.c, fpga.h, program_select.c]
2012-11-11 Handle reset in DMA module
    [dma.vhd, toplevel.vhd]
2012-11-11 Send instruction from RAM to avoid SIMD array being optimized away
    [instruction_register.vhd, toplevel.vhd]
2012-11-11 Fixed the leftmost columns of pixels
    [test_screen_copy.vhd]
2012-11-12 Revised FPGA SIMD controll core architecture schematic
2012-11-12 FPGA CONTROL CORE is now synthezising correctly and looks very much working, however, untested...
    [CONTROLL.vhd, INSTRUCTION_DECODER.vhd, PC.vhd, REGISTER_BANK.vhd, fpga_constant_pkg.vhd]
2012-11-12 modified assembler to work with proper simd node instruction format with node prefix for instructions. Started working on the control core instruction assembler.
2012-11-12 Added support for Control Core Instructions and JUMP labels in assembler
2012-11-12 Swapped VDATA and VADDR in the assembler
2012-11-13 replace dead pin definition. more avr/fpga comm. functions. other minor changes
    [bus.c, bus.h, fpga.c, shades_of_gray.h, sram.h]
2012-11-13 mmc_init() should return error code instead of void
    [mmc.c, mmc.h]
2012-11-13 REPORT: Some cleanup in the PCB-chapter
2012-11-13 REPORT: Purge a Footprint-TODO
2012-11-13 REPORT: Cleanup in the footprints-section
2012-11-13 Fixed something in the pcb part
2012-11-13 REPORT: Move the PCB introduction to a subsection
2012-11-13 Add pcb with compoents.eps
2012-11-13 REPORT: Move macaos.tex down from ch/pcb to ch/
2012-11-13 REPORT: Sectionize the PCB-introduction
2012-11-13 REPORT: Rewrite the wording of the introduction to the PCB-chapter
2012-11-13 REPORT: Insane SDCard Reader-footprints AAAAAAAAAAAAAAAAAAAAAAARGH!!!!!!!1111111 <3<4
2012-11-13 Resolved UI menu bug
    [button.c, program_select.c, script.c, script.h]
2012-11-13 REPORT: Cleanup in the PCB-Footprints-section
2012-11-13 Wrote a wall of text about the DMA module
2012-11-14 Report: Minor changes in The "The PCB"-section.
2012-11-14 wrote something about SPI issues with the AVR
2012-11-14 Mention image filters in FPGA architecture
2012-11-14 display framerate over video
2012-11-14 bugfixes in avr code
    [bus.h]
2012-11-14 Added initial power result section.
2012-11-14 REPORT: Add power plane imagery
2012-11-14 REPORT: Add more images for PCB-usage
2012-11-14 REPORT: Add the power_plane figure to the PCB-section
2012-11-14 REPORT: Tablify the Footprint-information
2012-11-14 REPORT: Fix a typo in PCB->Routing
2012-11-14 Remapped a AVR bus pin. Always use a 50 MHz clock for VGA mem ctrl.
2012-11-14 Attempted to resove errors in FPGA CTRL node which resulted in brances not being taken
    [PC.vhd, REGISTER_BANK.vhd, tb_control.vhd]
2012-11-14 interrupt-less timer in avr
2012-11-14 minor avr code fixes all over the place
    [bus.c, program_select.c, screen.c, script.c, sd_mmc_spi.c, sram.h]
2012-11-14 changed dead pin definition (again)
2012-11-14 Add vga-pseudo-circuit-diagram.
2012-11-14 Add vga-circuit-figure tex-file.
2012-11-14 Small rewrite of vga-section and include circuit-figure.
2012-11-15 Support jump/branch to subsequent labels in assembler
2012-11-15 FPGA ctrl node now appears correctly in ISE
    [CONTROL.vhd, TB_CONTROL.vhd, toplevel.vhd]
2012-11-15 Missed a couple of files in the previous commit
2012-11-15 Put together CTRL, DMA and ARRAY for testing.
2012-11-15 Fixed checkerboard test program
    [clock.vhd]
2012-11-16 fixed instruction sending from avr
    [bus.c, bus.h, fpga.c, gpio.c, shades_of_gray.h, smc_peripheral.h]
2012-11-16 Move PCB schematics to figure directory.
2012-11-16 Fix layout, citations and todos in PCB chapter.
2012-11-16 Support for CTRL DMA commands in assembler
    Added support for CTRL DMA commands in the assembler. Inspect the
    source code for a list of the commands.
    Added support for 'ctrl branch label' instead of only 'ctrl beq label'
    which was kind of misleading.
    Added some extra comments.
2012-11-16 Notepad++ language style for LENA assembly
2012-11-16 bugfix in reading block start/length from file
    [program_select.c, script.c]
2012-11-16 improved osd/timer
2012-11-16 Activated DMA
2012-11-16 Fixed assembler for DMA instructions
2012-11-16 Jobba med component functionality i rapporten. Skrevet om de språk problemene jahre klagde på, og la in noen ting som Jahre ønsket som TODOer.
2012-11-16 Fikset på språk der Jahre klaget på det i FPGA kapittlet. Og la in en del av hannes kommentarer som TODOer.
2012-11-16 Fixed PCB appendix -- should now be good.
2012-11-17 Put together CTRL, DMA and ARRAY for testing
2012-11-17 fixed error with multiple drivers
    [ARRAY.vhd]
2012-11-17 separerte process & design i PCB intro. Det gamle ligger der utkommentert så om noen er uenig er det bare å gjenopprette.
2012-11-17 Fixed errors with multiple drivers
    [SIMD_ARCHITECTUR.vhd, TB_SIMD_ARCHITECTURE.vhd, dma.vhd]
2012-11-17 Moved a lot of the PCB text into a separate process, since Jahre complained a lot about Process being mixed with the rest.
2012-11-17 fixing overhead use of step signals
    [S_REG.vhd, TB_SIMD_ARCHITECTURE.vhd]
2012-11-17 Stop DMA from writing to RAM when it shouldn't
2012-11-17 Fixed bug where edge nodes swapped data when they shouldnt
    [NODE_EDGE.vhd]
2012-11-17 added avr tests for leds/buttons
2012-11-17 fixing various errors with S-REG
    [NODE_EDGE.vhd, S_REG.vhd, TB_SIMD_ARCHITECTURE.vhd]
2012-11-17 Change pic of pcb with component
2012-11-17 REPORT: Add PCB-Schematic.pdf
2012-11-17 Fixed 75% of the SIMD array DMA thingy
    [NODE_EDGE.vhd, dma.vhd, toplevel.vhd]
2012-11-17 REPORT: Rename PCB.pdf -> pcbschematic.pdf
2012-11-17 REPORT: Remove the duplication done in ch/pcb/process.tex
2012-11-17 WIP on master: ba9e6ee REPORT: Remove the duplication done in ch/pcb/process.tex
2012-11-17 Shrink pcbwithcompnew.jpeg to reasonable size.
2012-11-17 REPORT: Add PCB-schematic figure texfile
2012-11-17 REPORT: Make a figure for the VGA-module schematic
2012-11-18 Load data correctly into the SIMD array
    [ARRAY.vhd]
2012-11-18 Added support for mask instructions in assembler
2012-11-18 removed incorrect debug print out form assembler
2012-11-18 REPORT: Add sliced PCB-schematics-files
2012-11-18 REPORT: Move PCB Schematic to subfolder
2012-11-18 REPORT: Create a Schematics-appendix
2012-11-18 REPORT: Rotate two schematics for easier reading
2012-11-18 Fix masking in assembler
2012-11-18 Add schematics to the PDF, and rename the figure
2012-11-18 Small changes to schematics.tex
2012-11-18 Report: Added figure 'removing vias' in pcb
2012-11-18 Fixed button bug
2012-11-18 Report: PCB
2012-11-18 FPGA assembled with 2X3 node array... stay tuned!
2012-11-18 Change Table name to The Customized Footprints
2012-11-18 REPORT: fixed TODO about power planes
2012-11-18 no FPS OSD when data source is single frame
2012-11-18 REPORT: Fix TODO in footprint section
2012-11-18 REPORT: Fix footprints-descriptions
2012-11-18 REPORT: Fill in an explanation to the table regarding the footprints we made
2012-11-19 Fix edge detection and gradient programs for 2x3 array
    You have to add noops, so the number of instructions
    are at least 50 in each dma run, for correct result
2012-11-19 FPGA: fixed problems related to edge node data forwarding
    [NODE_EDGE.vhd]
2012-11-19 REPORT: Restate the power-supply-subsubsection
2012-11-19 REPORT: My foot, your print, what's the difference.
2012-11-19 Split up soldering to subsection, other fixes.
2012-11-19 Language cleanup in Soldering
2012-11-19 Add LENA assembly (is in other branch).
2012-11-19 Rewrite last sentence of power_supply
2012-11-19 Fix SPI figures and plots.
2012-11-19 Report: PCB, routing, some more progress
2012-11-19 Minor rephrasing and typo-fixing in pcb workarounds.
2012-11-19 Report: PCB workaround
2012-11-19 Reword the schematics-section
2012-11-19 Report: Removed story about messing up a pin
2012-11-19 REPORT: Overordnet beskrivelse av schematic-creation-workflow
2012-11-19 fixed rs232 AVR code
    [serial.c]
2012-11-19 Add overview of pin use
2012-11-19 REPORT: Add a picture of the soldered power-supply
2012-11-19 REPORT: Flesh out a bit of an introduction to the PCB chapter
2012-11-19 Proofread start of PCB chapter.
2012-11-19 REPORT: Various typos in the PCB-chapter
2012-11-19 Routing in PCB,workarounds needs some looking over
2012-11-19 New images of PCB
2012-11-19 Repor: Moved SIMD section above DMA & Control
2012-11-19 REPORT: Mention how slow the VGA-module is in the PCB-chapter
2012-11-19 REPORT: Move the PCB "testing" section into process
2012-11-19 The third board
2012-11-19 REPORT: Move an image up to the beginning of the PCB-chapter
2012-11-19 Median filter -> edge detection filter in FR7 test.
2012-11-19 REPORT: Update the PCB introduction to reflect the change in section-ordering
2012-11-19 Rapport: Third board
2012-11-19 Fixes of third board.
2012-11-19 REPORT: Force the power-supply image-location
2012-11-19 REPORT: Fix a reference-TODO in PCB
2012-11-19 REPORT: Purge another TODO from PCB
2012-11-19 bugfix in AVR code
    [bus.c, fpga.c]
2012-11-19 omskrivninger, nåtid/datid, LED/BUTTON-VGA debug nonsense fjernet
2012-11-19 Add pygments style for LENA assembly. (soderberg)
2012-11-19 Fix config to support LENA assembly.
2012-11-19 at [up to] 13 frames per second
2012-11-19 PCB corrections
2012-11-19 avr: invert bug resolved
    [bus.c, fpga.c, program_select.c, screen.c]
2012-11-19 avr: UI resets at end of video
    [program_select.c, script.c]
2012-11-20 handle single frame data; button click during playback restarts program; avr menu navigation now wraps
2012-11-20 more avr bug fixes
    [program_select.c]
2012-11-20 Set clock to 25MHz, fix timing constraints and create mcs file
    [clock.vhd, toplevel.vhd]
